kalymos/PsNee/images/BIOS/32p.png

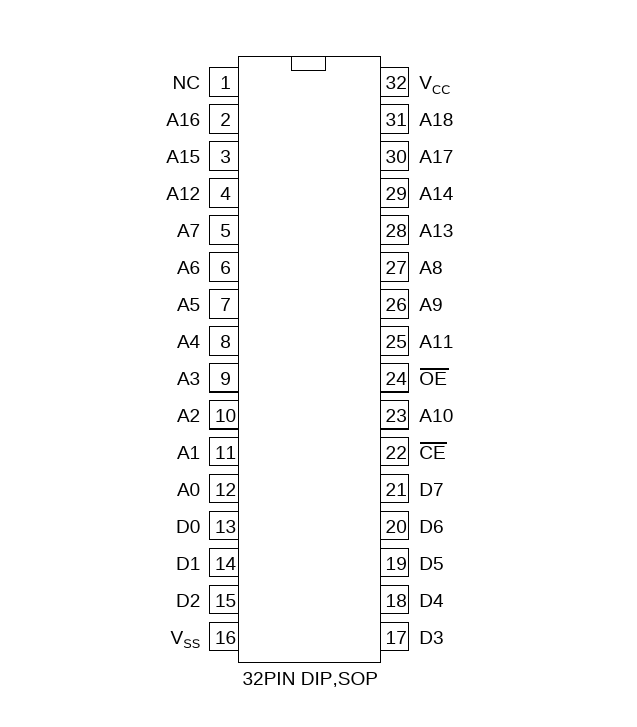
images/BIOS/32p.png
