kalymos/PsNee/images/BIOS/40p SCPH 1000-3000-pic.png

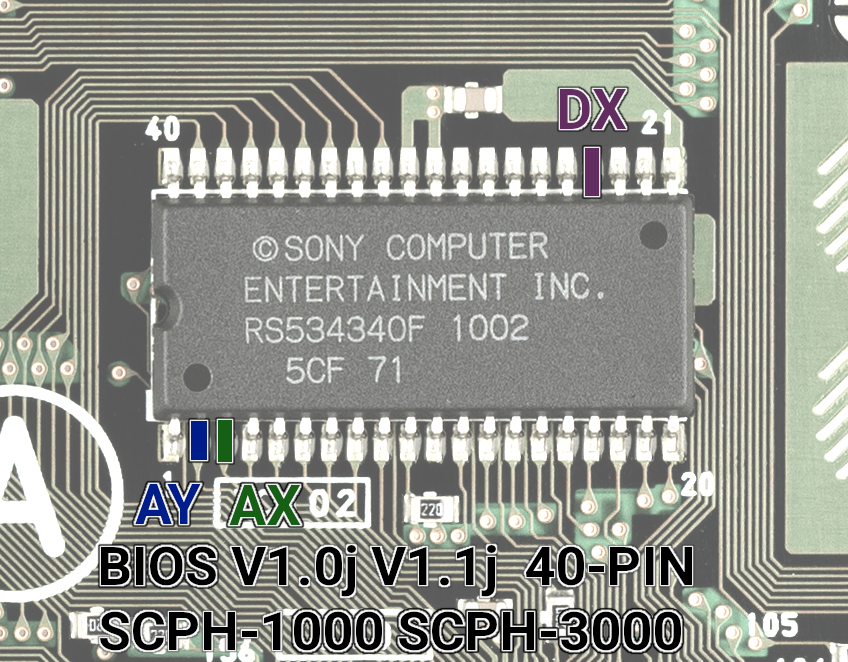
images/BIOS/40p SCPH 1000-3000-pic.png
