kalymos/PsNee/images/BIOS/40p SCPH 3500-5000-pic.png

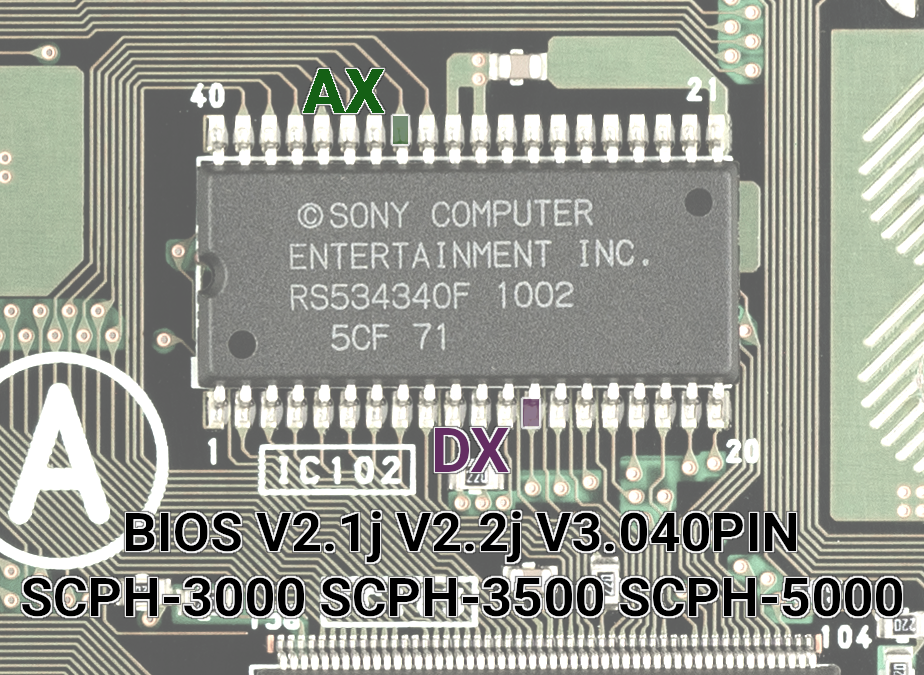
images/BIOS/40p SCPH 3500-5000-pic.png
