kalymos/PsNee/images/BIOS/40p.png

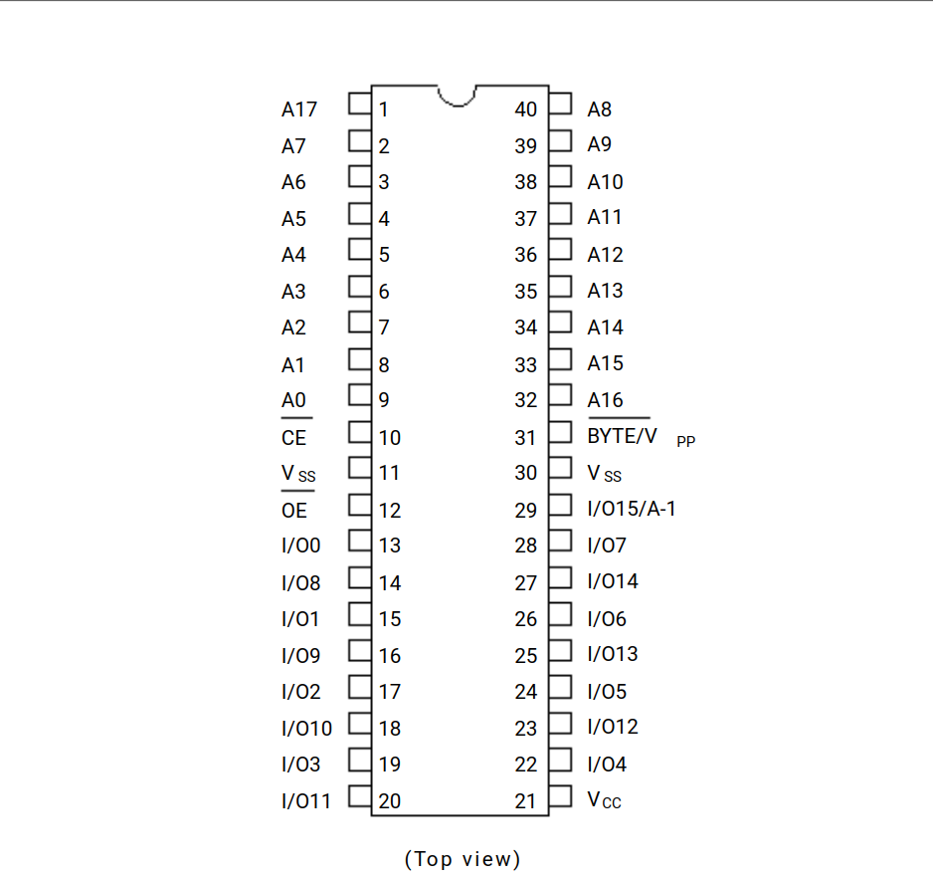
images/BIOS/40p.png
