kalymos/PsNee/images/motherboard/PU-7.png

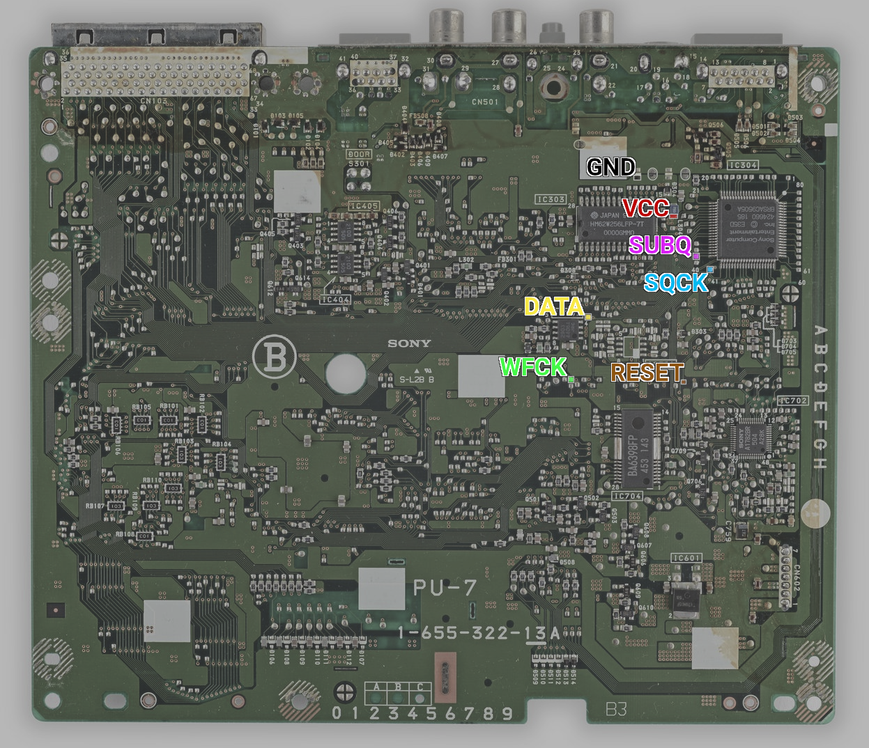
images/motherboard/PU-7.png
