kalymos/PsNee/images/motherboard/pu-8b.png

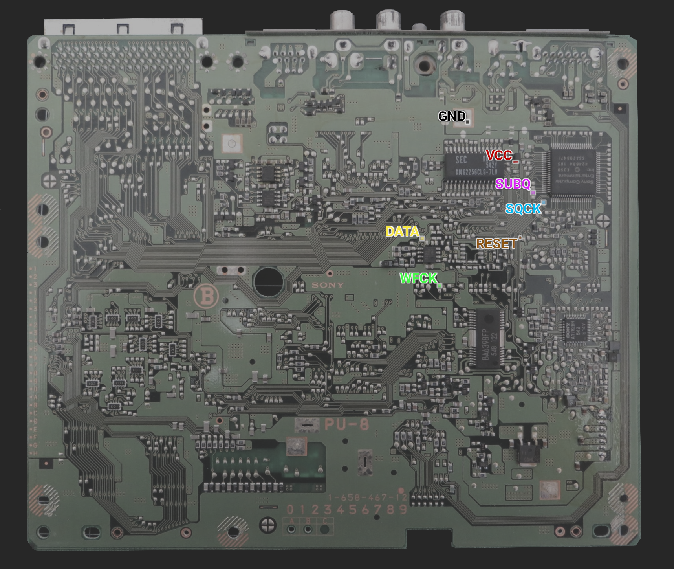
images/motherboard/pu-8b.png
