kalymos/PsNee/images/MUC Arduino/ATtiny25_45_85.png

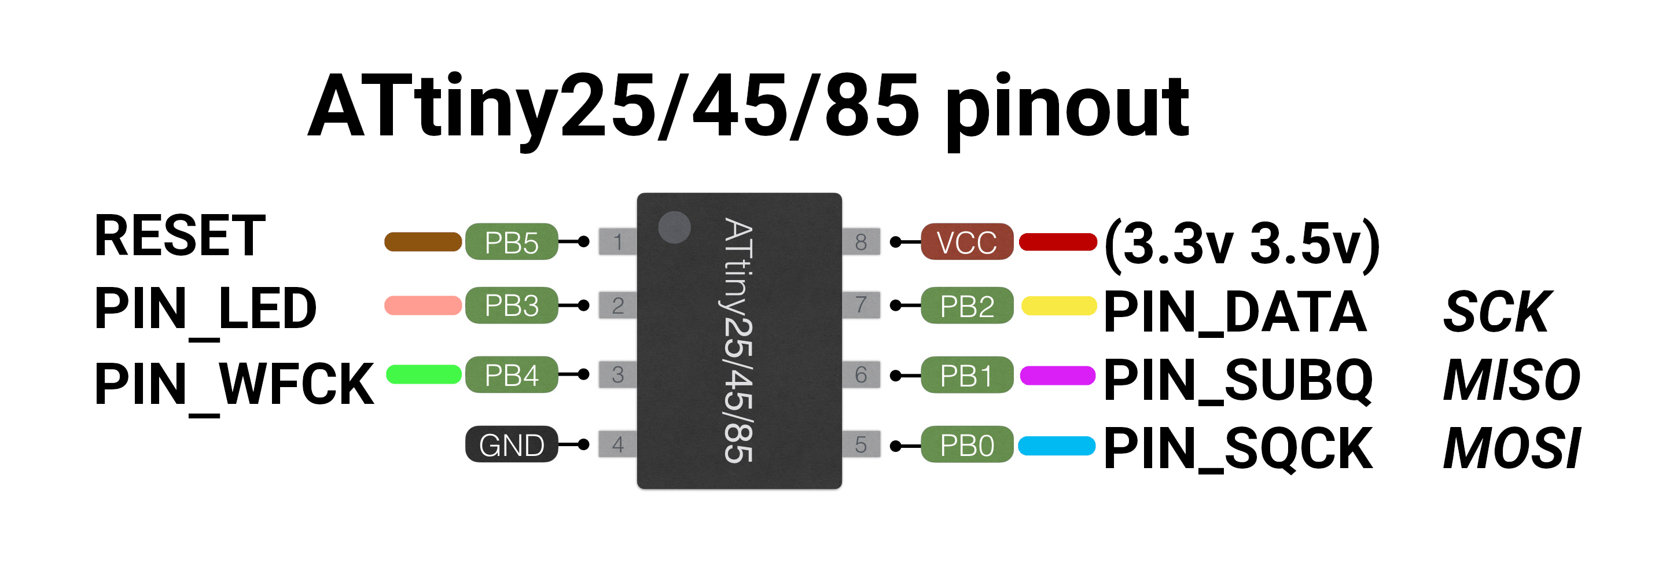
images/MUC Arduino/ATtiny25_45_85.png
