kalymos/PsNee/images/MUC Arduino/micro.png

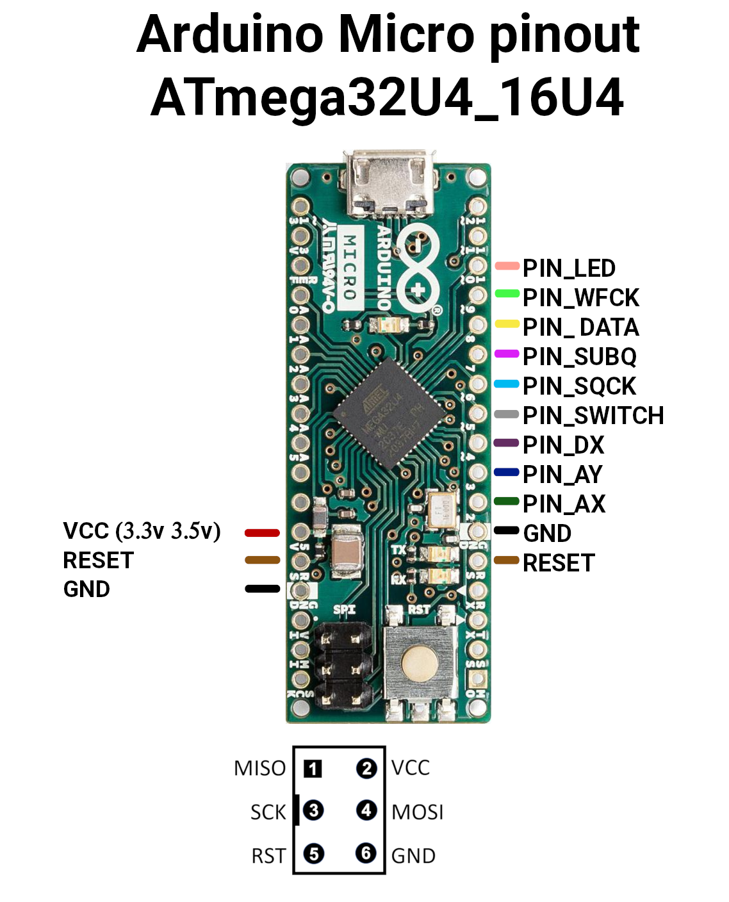
images/MUC Arduino/micro.png
