kalymos/PsNee/images/MUC Arduino/Nano.png

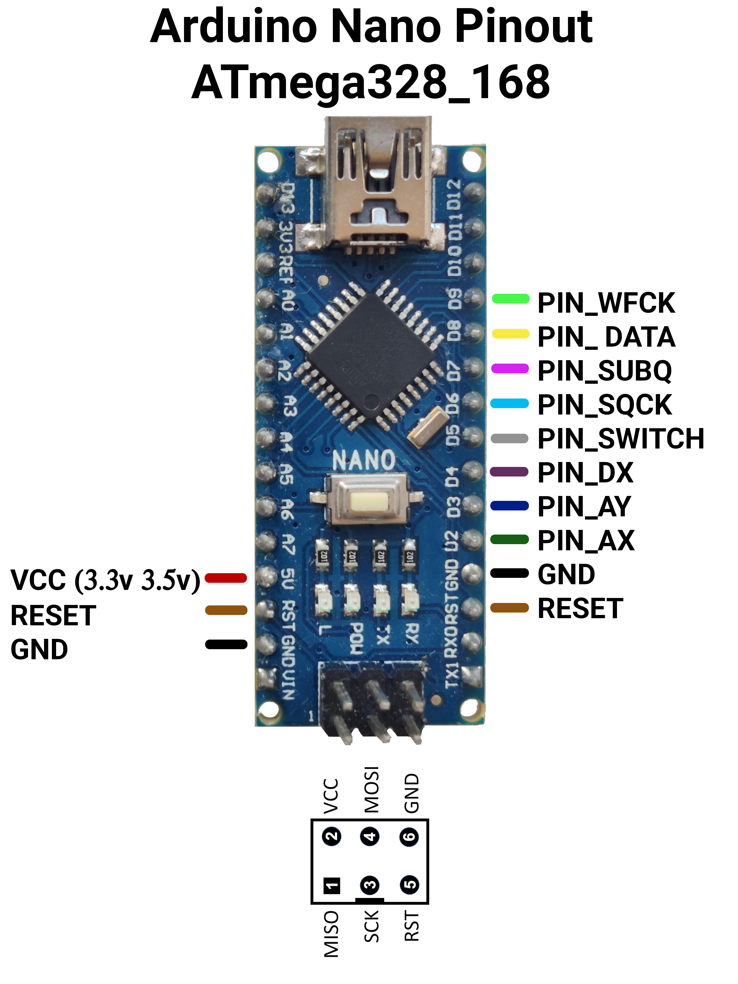
images/MUC Arduino/Nano.png
