kalymos/PsNee/images/MUC Arduino/Pro Micro.png

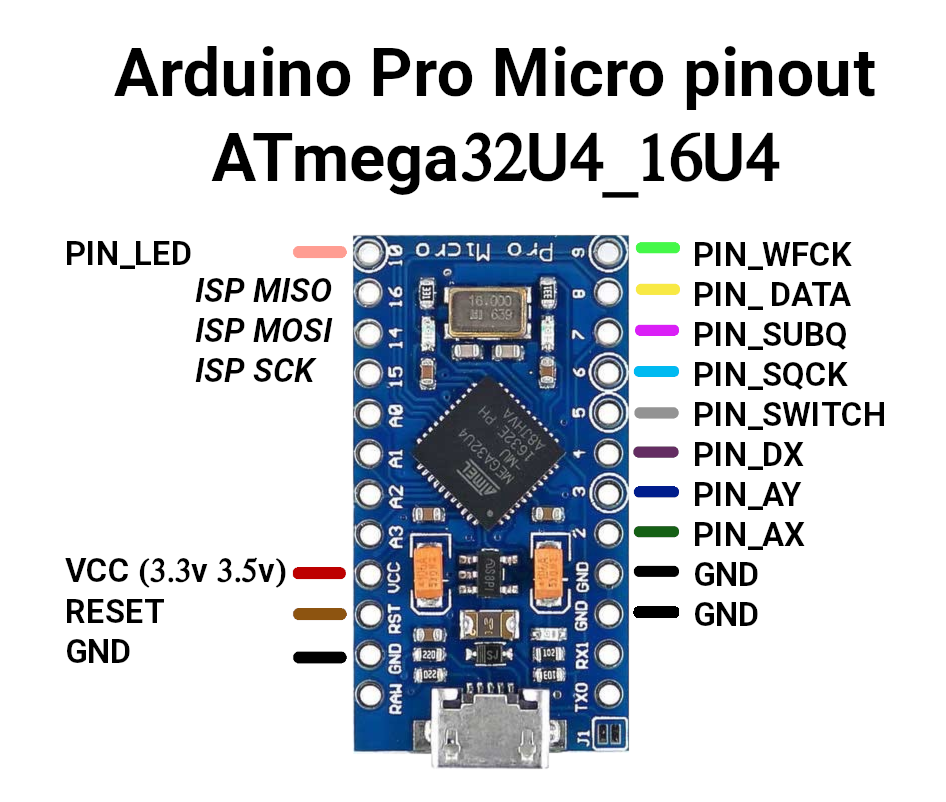
images/MUC Arduino/Pro Micro.png
