kalymos/PsNee/images/MUC Arduino/pro mini.png

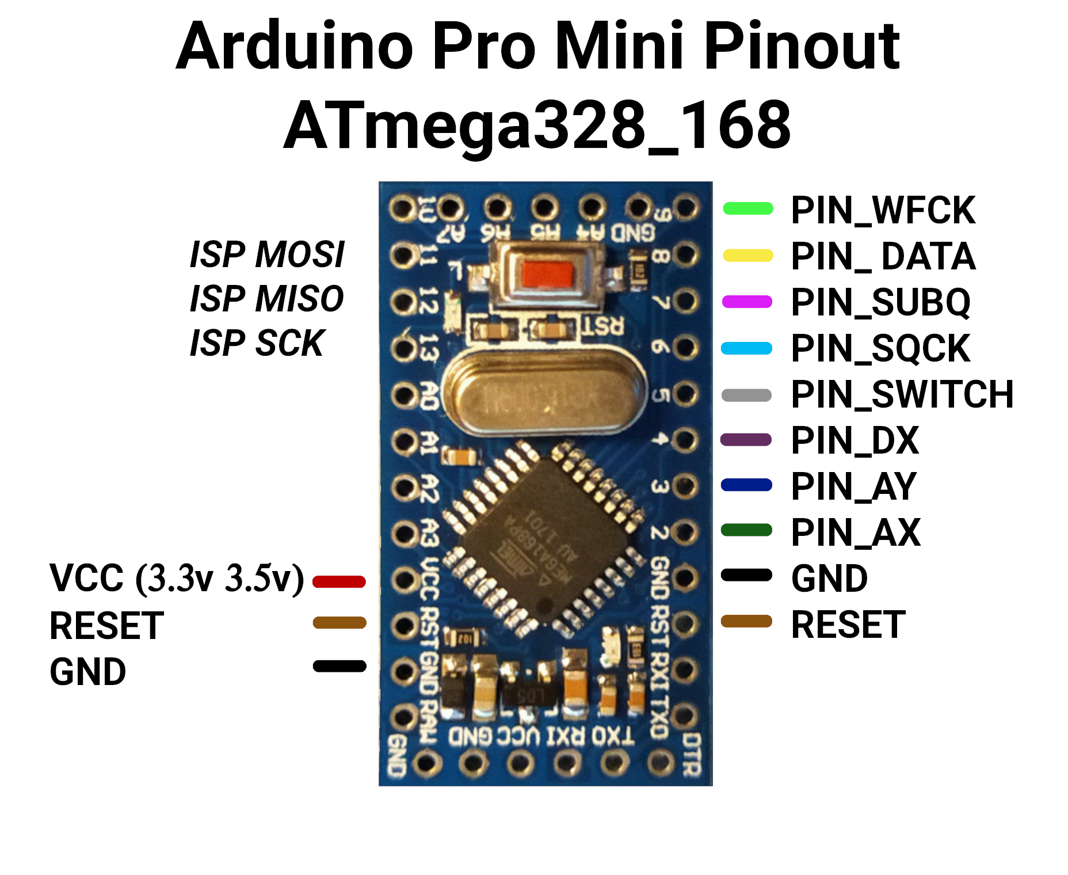
images/MUC Arduino/pro mini.png
