kalymos/PsNee/images/MUC Arduino/PSNee_V9_pinout.png

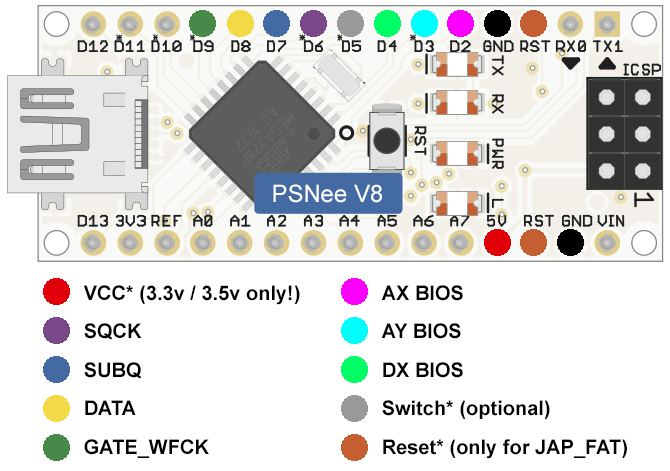
images/MUC Arduino/PSNee_V9_pinout.png
