kalymos/PsNee/images/schemat/Arduino_ISP_wires.jpg

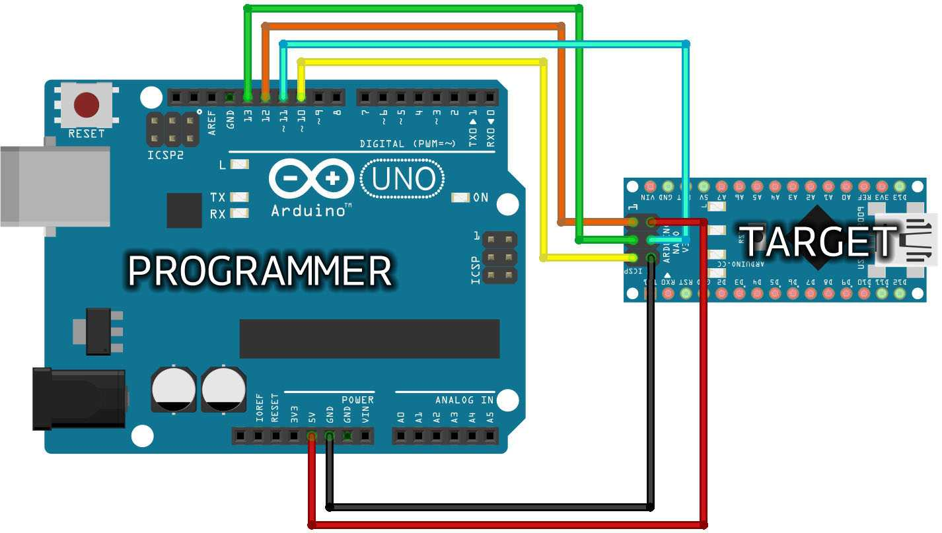
images/schemat/Arduino_ISP_wires.jpg
