kalymos/PsNee/images/schemat/ISP_gateway.png

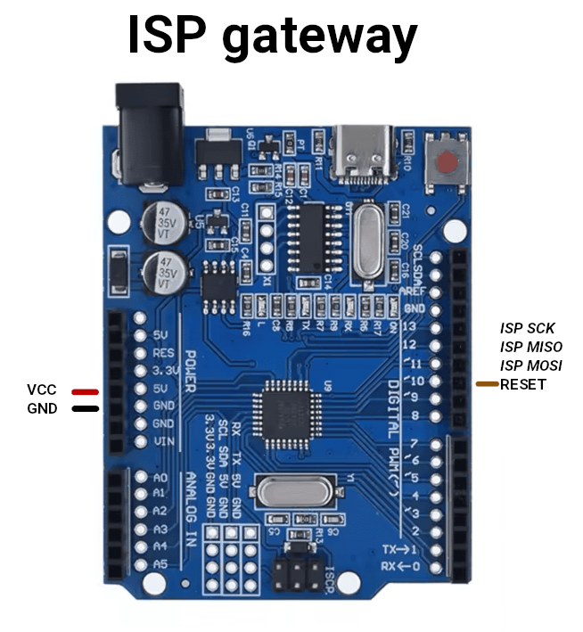
images/schemat/ISP_gateway.png
