kalymos/PsNee/images/schemat/LED_PIN.png

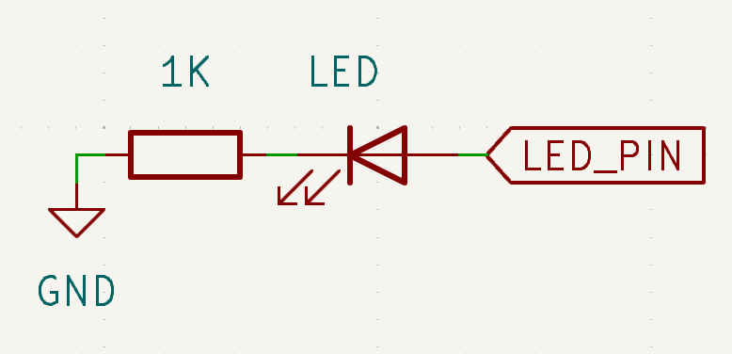
images/schemat/LED_PIN.png
