kalymos/PsNee/images/schemat/PIN_SWITCH.png

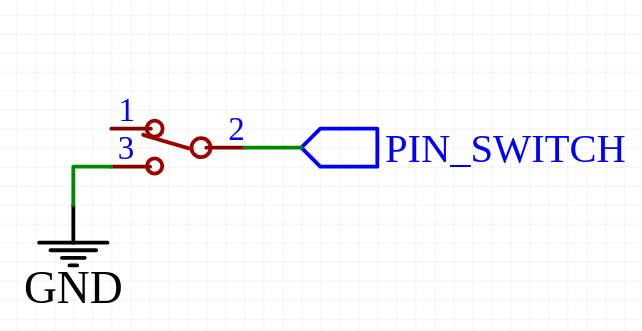
images/schemat/PIN_SWITCH.png
