kalymos/PsNee/images/tuto/blink-ISP.gif

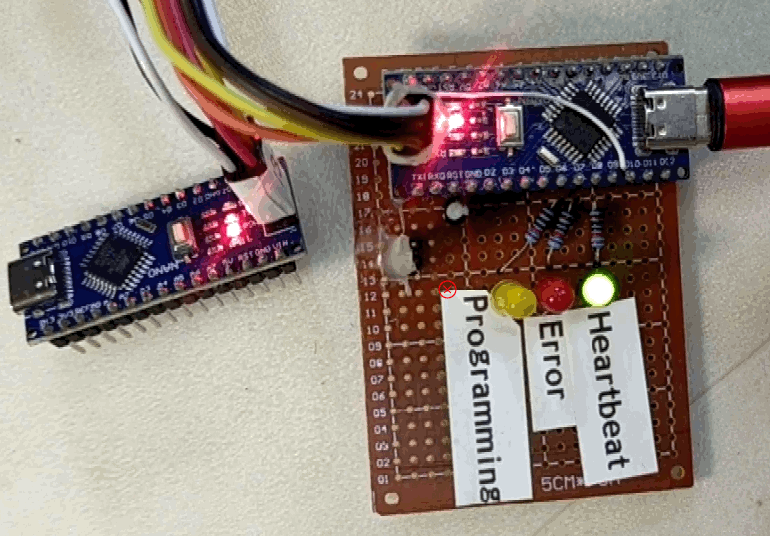
images/tuto/blink-ISP.gif
