kalymos/PsNee/images/tuto/blink-USB.gif

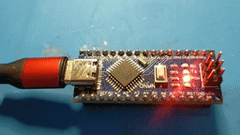
images/tuto/blink-USB.gif
