kalymos/PsNee/images/my test material/ISP-programer.jpg

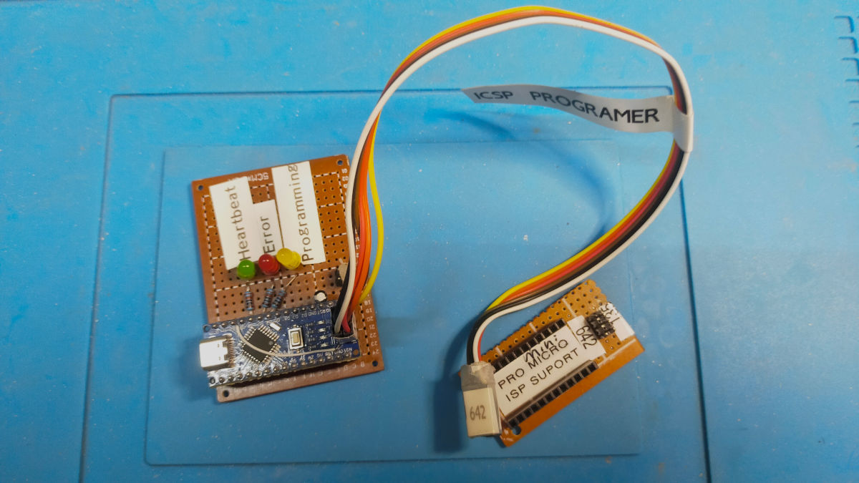
images/my test material/ISP-programer.jpg
