kalymos/PsNee/images/my test material/MCU-and-adapter.jpg

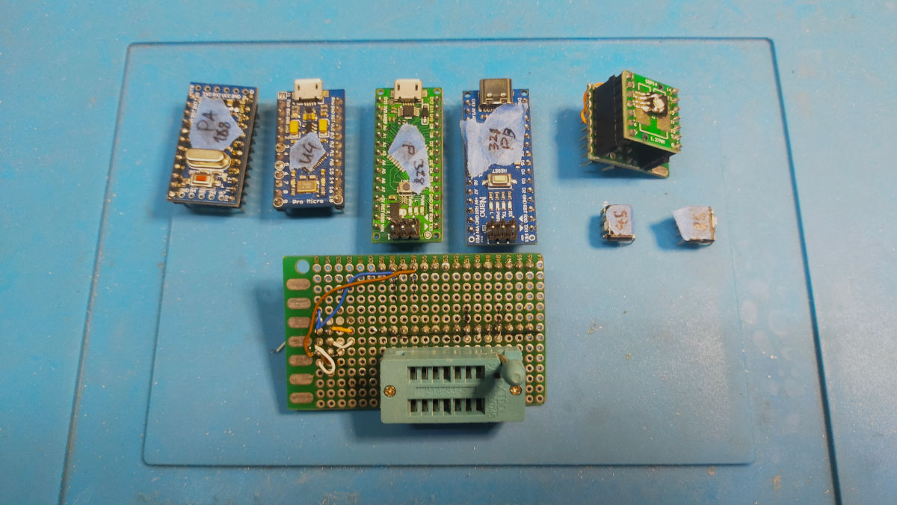
images/my test material/MCU-and-adapter.jpg
