kalymos/PsNee/(threads)

Thread 3 (2017-06-23):

BiosA18 + D2

Matyricon, 2017-06-23:
Could you please explain more about these points? Like do all PAL unit require this step? Also finding these points on the board itself has proven difficult.

kalymos, 2017-06-23:
The problem for pal occurs only on the SCPH-102.
 In the code there is the wiring mode, and it is not 100% clear, look at the wiki there is a more clot numbering.

Closed 2023-04-28.

Thread 4 (2017-06-28):

Improve instructions.

damopinn, 2017-06-28:
I used this but i commented out the NTSC fix because my ps1 doesn't need it. I think it would hang waiting for a signal it wont receive if I didn't. It doesn't mention you should edit the inject_playstation() for your region.

kalymos, 2017-06-29:
Hi if you use PsNee v6, test this version [https://github.com/kalymos/PsNee/blob/6ec387f30d0540b84bb129c454a168752bf1613f/PsNee.ino](https://github.com/kalymos/PsNee/blob/6ec387f30d0540b84bb129c454a168752bf1613f/PsNee.ino) It works with the same welding as the v6 (For me v6 does not work properly) There is also the psxdev.net that works well, seley it has not the same welding.

damopinn, 2017-06-29:
At the moment I'm not going to try I just rebuilt my ps1 with an attiny85 using v6. It's working OK.
Which region are you because v6 is Europe only but you can edit it for other regions.
and the NTSC fix needs to be removed if you don't need it I presume it will cause a hang, from reading the code it waits for an input from some bios pins which I didn't connect. What is your problem with v6?

kalymos, 2017-07-01:
I'm on the European region with SCPH-102, normally I need NTSC patch. I tested practically all the versions and it is the only one that I failed to run.
I tried several manipulation on the code, remove the patch NTSC, and something else. She always refused to inject code on the data line.

damopinn, 2017-07-01:
What device are you using because I used the Attiny85. the pin numbers are Arduino pin number like on a Digispark. using a pro mini is a lot easier. I can send you my edited code if you want.

kalymos, 2017-07-01:
I use a mini pro, and I tested an Attiny 45. I want your code, it will allow me to see where I follow myself.
I also have the new psxdev code to test.

damopinn, 2017-07-01:
I made a fork and uploaded the file. I can help to test when I'm not too busy. I suppose you leave a header to make it easier to test

kalymos, 2017-07-03:
It's good its function I had to go like a dirty :)

Thread 5 (2017-07-05):

tried to port to attiny

damopinn, 2017-07-05:
I added some code to the psxdev program.

  #define ATTINY

    #ifdef ATTINY
      // board pins
      #define sqck 3          // connect to PSX HC-05 SQCK pin
      #define subq 4          // connect to PSX HC-05 SUBQ pin
      #define data 2          // connect to point 6 in old modchip diagrams
      #define gate_wfck 0     // connect to point 5 in old modchip diagrams
      // MCU input / output
      #define SUBQPORT PINB       // Atmel MCU port for the 2 SUBQ sampling inputs
      #define SQCKBIT 3           // ATmega PD6 "SQCK" Mechacon pin 26 (PU-7 and early PU-8 Mechacons: pin 41)
      #define SUBQBIT 4           // ATmega PD7 "SUBQ" Mechacon pin 24 (PU-7 and early PU-8 Mechacons: pin 39)
      #define GATEWFCKPORT PINB   // Atmel MCU port for the gate input (used for WFCK)
      #define DATAPORT PORTB      // Atmel MCU port for the gate input (used for WFCK)
      #define GATEWFCKBIT 0       // ATmega PB1
      #define DATABIT 2          // ATmega PB0
    #endif

on the attiny there is only portb and the bit number is the same as the pin number so I changed pind to pinb and the pins and mcu input output to match but it doesnt work.

kalymos, 2017-07-07:
I would not lie. It seems to me that there is a registry call which does not conform with the Attiny. Most people even to answer exactly, are on psxdev. I do not really develop the code, I test it within the limit of my abilities ;)

damopinn, 2017-07-08:
Thanks, I found the thread on psxdev. I've been chatting there a few days now. Good job on putting this on github

Closed 2023-04-28.

Thread 9 (2017-08-28):

Arduino Pro Micro support?

gamelaster, 2017-08-28:
Hey, I have SCPH-5502, trying to use Pro Micro for modchip, but sooo, what to do, since: `has a different pin assignment and needs some easy porting`. Any more information about it?

Thanks

kalymos, 2017-08-28:
Hi if your motherboard looks like this [-->](https://upload.wikimedia.org/wikipedia/commons/thumb/b/b8/Sony_Playstation_1_SCPH-5502_motherboard_top.jpg/773px-Sony_Playstation_1_SCPH-5502_motherboard_top.jpg) It is a PU-18, you will find an adequate diagram in PsNee-V7-Diagram.

ramapcsx2, 2017-08-29:
Pro Micros can do the job but the ATmegaU chip has differnet ports and the Arduino pinout changed.
Since this code uses direct port manipulation and the pinout changed, you will have to find free pins and tell the code to use them.
For example, 'data' uses PB0, assigned to pin#8 on Arduino.
On Pro Micro, PB0 isn't available (used for an LED), so the data pin has to move and all port manipulation adjusted accordingly.
If you don't feel like doing all that, get a Nano. That should be compatible with the Arduino Uno #define ;)

ramapcsx2, 2017-08-30:
Those pins look good, yeah.
It looks like you can re-use all port defines from 'ARDUINO_BOARD'. Nice choice of pins :)
All you'll have to change is the pin numbers (sqck, subq, data, gate_wfck) and the bits (SQCKBIT, SUBQBIT, GATEWFCKBIT, DATABIT).
This should already work then.
Solder the wires, connect Vcc and ground as per the installation diagrams (now with your changed pins) and give it a test!

gamelaster, 2017-08-30:
@ramapcsx2 well, I probably already have mod chipped so I don't know if I want to do more work on it, but for contribution, I will probably try that! I will post here the results (Serial dumps if it will not work) later 😊
Thank you for now

LameNobody, 2017-10-03:
Well, tested it out with these pins,
`SQCKBIT => pin 2 (PD1)`
`SUBQBIT => pin 3 (PD0)`
`GATEWFCKBIT => pin 15 (PB1)`
`DATABIT => pin 14 (PB3)`
It booted the backup.. so I'm going to assume it worked fine.

kpek, 2020-03-22:
can anyone who got this to work with Pro Micro please share what exactly has to be changed in the code ? when i read all the info in this thread its confusing,
Do we change the pin defines only ? or only bits defines ? or both  ?

Thanks

wyatt8740, 2020-05-25:
@kpek check pull request #22 . I have this installed inside my SCPH-1001 on a pro micro.

Clone [my repository](https://github.com/wyatt8740/PsNee) and set `#define ARDUINO_32UX_BOARD`. My repository has the readme updated with the correct pinouts for it.

wyatt8740, 2020-05-28:
@ramapcsx2 can this issue be closed now since PR #22 was merged?

gamelaster, 2020-05-28:
@wyatt8740 I will close it. Thank you for testing :)

BTW. I was trying it too, sadly, after all soldering, code changes, I dummy forget that I have 5V version of ProMicro 🤦

wyatt8740, 2020-05-29:
> BTW. I was trying it too, sadly, after all soldering, code changes, I dummy forgot that I have 5V version of ProMicro
I have the 5V pro micro as well. It still worked for me, just feed it 3.5V on the Vcc pin or whatever it's called. The pin that doesn't go through a regulator. It might actually be called `5V`, but connect 3.5V to it anyway.

gamelaster, 2020-05-29:
@wyatt8740 Well, I thought the reason why it doesn't work is because 5V, well I had issue somewhere else! Good to know!

wyatt8740, 2020-06-04:
@gamelaster Glad it helped. If your board has LED's and they just turn on and stay dimmer than usual it's usually a sign they're being powered wrong through the regulator. But even though AVR's aren't really designed to run at 16MHz on ~3.3V in practice it seems to work fine with the 3.5V from a PSX at least.

Took me a while to figure that out, too, but I think rama3 or someone else on the psxdev forum thread brought it up.

Closed 2020-05-28.

Thread 10 (2017-10-04):

PSone Pins

Madad1996, 2017-10-04:
Is this compatible to the PSone, if yes which pins i should use?

ramapcsx2, 2017-10-05:
PAL or NTSC-U/J machine?
PAL requires the boot patch, which means more cables.
In any case, the install diagrams include this model. The diagram is for PAL.

Madad1996, 2017-10-06:
Cant find the Pins on the Board...
https://imgur.com/gallery/9Iwq6

Madad1996, 2017-10-06:
SCPh-102

ramapcsx2, 2017-10-07:
Ah, this is the more rare PM-41(2) board.
You'll have to use a multimeter and find something to solder to. Google image search has some old modchip installation pictures for these boards. They can help you find your pins.
The 2 BIOS pins will be the same, so will Vcc and Gnd.
Data is usually marked '6' in old diagrams. It will be one side of an smd capacitor.
WFCK is marked '5' and is a test point pad.
SUBQ is pin24, SQCK is pin26 on the HC-05 (IC304).

Closed 2023-04-28.

Thread 11 (2018-01-27):

non-working games

zoinknoise, 2018-01-27:
i apologize if this isn’t the right place to report this. have found a few non-working games.

-Henry Explorers (SLPM-86021) boots to “Insert PlayStation cd-rom”
-Tokimeki Memorial: Forever with You (SLPS-00065) boots to CD player

both are Konami games from 1995, strange coincidence.

i also found a game that trips the anti-mod protection, though I was booting a copy not an original: Ore no Ryouri (SCPS-10099) this game was burned from a Redump image.

my setup is SCPH-1001, PU-8 board, ACM drive. using latest version of code, modified a/a/a boot string on Arduino pro mini clone @16mhz.

zoinknoise, 2018-01-27:
update: uninstalled PsNee and replaced with Mayumi v1.1 (PICF508). can confirm these three games boot successfully. but now Spyro 3 doesn't work, oh well. :P

just reporting, cuz i like this project. :)

ramapcsx2, 2018-01-27:
Thanks :)
I can imagine what the failing games do. The non-booting titles are probably using a rare disc layout, maybe lots of audio in the TOC.
The one that trips the antimod, not sure. That should be almost impossible.

ramapcsx2, 2018-01-27:
Ore no Ryouri is working just fine on either a PAL (expected) or Japan PSX (should fail, if the code was bad).
The check is right after the SCE message on bootup, right? (I can hear the laser move, to search for modchip symbols. Then it continues fine, meaning it passed the test.)

zoinknoise, 2018-01-27:
hmm... i didn’t try more than once, maybe i should have. it certainly could have been  the extremely finicky ACM drive causing the error. mine is in good condition but it still despises CD-R’s.

my machine is NTSC U/C region btw.

zoinknoise, 2018-01-27:
yes the error happened immediately for me after boot. the screen actually came up in a Japanese which I can’t remember if that’s typical for a US machine.

zoinknoise, 2018-01-29:
maybe there can be an option to force game mode? so if the disc is being mistakenly booted as audio, there can be a manual override. just an idea~

zoinknoise, 2018-01-30:
reinstalled PsNee. can confirm Ore no Ryouri works fine. must have been a fluke.

trying more Konami games and found another that won't boot:

-Sexy Parodius (SLPM-86009) boots to "insert PlayStation CD-ROM"

not an original, but burned multiple times from Redump to confirm.

ramapcsx2, 2018-01-30:
The code should just work, no options necessary. If there are games that don't start, I consider it a bug that needs fixing :)
I actually have Parodius. I'll see what it does here.

ramapcsx2, 2018-02-01:
No problem on Parodius either. Check your wiring, try to attach a serial monitor and read the debug messages.

zoinknoise, 2018-02-01:
are we talking about the same Parodius? there are three for PS1 i believe. Sexy Parodius is the one that won't boot; the other two will.

if all three should work, then it must have to do with my PS1's issue with CD-R discs since i don't own original copies of those. but the two games at the top, Tokimeki and Henry Explorers, do not boot from spotless original copies. they DO boot with a Mayumi on the exact same machine/drive, so i must assume the discs are not defective.

besides these few games, i have had total success booting all backups and originals with the current version of PsNee! i will get things wired up and post some serial logs soon.

ramapcsx2, 2018-02-01:
Okay, I found Henry Explorers and this one really doesn't work.
If you look at the logs, it's easy to tell why:
61 00 A0 99 35 28 00 01 20 00 FC FF
The game has one bit too many set, compared to all other titles.
Adding the flag fixes the problem.

zoinknoise, 2018-02-01:
sweet! will the next version of the code have this fix?

i will test and log Tokimeki and Sexy Parodius later today if you don’t get to them first.

ramapcsx2, 2018-02-02:
Yeah, this is going to need a new revision. I think I also found a nicer way to go about the injection timing.
Normally, this (and old codes) use a fire and forget method to unlock the HC-05.
The new method looks at the effects of a single injection and can break/exit as soon as it thinks the HC-05 has been unlocked.
This is all to try and reduce interference to normal operation, since the modchip action is pretty bad for the error correction and thus, the laser.

zoinknoise, 2018-02-02:
excellent to hear! here are the logs i promised:

zoinknoise, 2018-02-02:
Tokimeki Memorial: Forever with You [SLPS-00065]

MCU frequency: 16000000 Hz
Waiting for SQCK..
highs: 4832 lows: 0
pu22mode: 0
21 00 A2 06 39 26 00 70 38 11 69 1F
61 00 01 06 39 31 00 00 02 00 FC FF
21 00 02 06 39 33 00 66 24 14 9F 7F
21 00 02 06 39 34 00 66 24 14 FC FF
61 00 A0 06 39 35 00 01 20 00 9F 7F
61 00 A0 06 39 36 00 01 20 00 FC FF
61 00 A0 06 39 37 00 01 20 00 9F 7F
01 00 A1 06 39 38 00 02 00 00 FC FF
01 00 A1 06 39 39 00 02 00 00 9F 7F
01 00 A1 06 39 40 00 02 00 00 FC FF
21 00 A2 06 39 41 00 70 38 11 9F 7F
21 00 A2 06 39 42 00 70 38 11 FC FF
21 00 A2 06 39 43 00 70 38 11 9F 7F
61 00 01 06 39 44 00 00 02 00 FC FF
61 00 01 06 39 45 00 00 02 00 9F 7F
61 00 01 06 39 46 00 00 02 00 FC FF
21 00 02 06 39 47 00 66 24 14 9F 7F
21 00 02 06 39 48 00 66 24 14 FC FF
21 00 02 06 39 49 00 66 24 14 9F 7F
61 00 A0 06 39 50 00 01 20 00 FC FF
61 00 A0 06 39 51 00 01 20 00 9F 7F
61 00 A0 06 39 52 00 01 20 00 FC FF
01 00 A1 06 39 53 00 02 00 00 9F 7F
01 00 A1 06 39 54 00 02 00 00 FC FF
01 00 A1 06 39 55 00 02 00 00 9F 7F
21 00 A2 06 39 56 00 70 38 11 FC FF
21 00 A2 06 39 57 00 70 38 11 9F 7F
21 00 A2 06 39 58 00 70 38 11 FC FF
61 00 01 06 39 59 00 00 02 00 9F 7F
61 00 01 06 39 60 00 00 02 00 FC FF
61 00 01 06 39 61 00 00 02 00 9F 7F
21 00 02 06 39 62 00 66 24 14 FC FF
21 00 02 06 39 63 00 66 24 14 9F 7F
21 00 02 06 39 64 00 66 24 14 FC FF
61 00 A0 06 39 65 00 01 20 00 9F 7F
61 00 A0 06 39 66 00 01 20 00 FC FF
61 00 A0 06 39 67 00 01 20 00 9F 7F
01 00 A1 06 39 68 00 02 00 00 FC FF
01 00 A1 06 39 69 00 02 00 00 9F 7F
01 00 A1 06 39 70 00 02 00 00 FC FF
21 00 A2 06 39 71 00 70 38 11 9F 7F
21 00 A2 06 39 72 00 70 38 11 FC FF
21 00 A2 06 39 73 00 70 38 11 9F 7F
61 00 01 06 39 74 00 00 02 00 FC FF
61 00 01 06 40 00 00 00 02 00 9F 7F
61 00 01 06 40 01 00 00 02 00 FC FF
21 00 02 06 40 02 00 66 24 14 9F 7F
21 00 02 06 40 03 00 66 24 14 FC FF
21 00 02 06 40 04 00 66 24 14 9F 7F
61 00 A0 06 40 05 00 01 20 00 FC FF
61 00 A0 06 40 06 00 01 20 00 9F 7F
61 00 A0 06 40 07 00 01 20 00 FC FF
01 00 A1 06 40 08 00 02 00 00 9F 7F
01 00 A1 06 40 09 00 02 00 00 FC FF
01 00 A1 06 40 10 00 02 00 00 9F 7F
21 00 A2 06 40 11 00 70 38 11 FC FF
21 00 A2 06 40 12 00 70 38 11 9F 7F
21 00 A2 06 40 13 00 70 38 11 FC FF
61 00 01 06 40 14 00 00 02 00 9F 7F
61 00 01 06 40 15 00 00 02 00 FC FF
61 00 01 06 40 16 00 00 02 00 9F 7F
21 00 02 06 40 17 00 66 24 14 FC FF
21 00 02 06 40 18 00 66 24 14 9F 7F
21 00 02 06 40 19 00 66 24 14 FC FF
61 00 A0 06 40 20 00 01 20 00 9F 7F
61 00 A0 06 40 21 00 01 20 00 FC FF
61 00 A0 06 40 22 00 01 20 00 9F 7F
01 00 A1 06 40 23 00 02 00 00 FC FF
01 00 A1 06 40 24 00 02 00 00 9F 7F
01 00 A1 06 40 25 00 02 00 00 FC FF
21 00 A2 06 40 26 00 70 38 11 9F 7F
21 00 A2 06 40 27 00 70 38 11 FC FF
21 00 A2 06 40 28 00 70 38 11 9F 7F
61 00 01 06 40 29 00 00 02 00 FC FF
61 00 01 06 40 30 00 00 02 00 9F 7F
61 00 01 06 40 31 00 00 02 00 FC FF
21 00 02 06 40 32 00 66 24 14 9F 7F
21 00 02 06 40 33 00 66 24 14 FC FF
21 00 02 06 40 34 00 66 24 14 9F 7F
61 00 A0 06 40 35 00 01 20 00 FC FF
61 00 A0 06 40 36 00 01 20 00 9F 7F
61 00 A0 06 40 37 00 01 20 00 FC FF
01 00 A1 06 40 38 00 02 00 00 9F 7F
01 00 A1 06 40 39 00 02 00 00 FC FF
01 00 A1 06 40 40 00 02 00 00 9F 7F
21 00 A2 06 40 41 00 70 38 11 FC FF
21 00 A2 06 40 42 00 70 38 11 9F 7F
21 00 A2 06 40 43 00 70 38 11 FC FF
61 00 01 06 40 44 00 00 02 00 9F 7F
61 00 01 06 40 45 00 00 02 00 FC FF
61 00 01 06 40 46 00 00 02 00 9F 7F
21 00 02 06 40 47 00 66 24 14 FC FF
21 00 02 06 40 48 00 66 24 14 9F 7F
21 00 02 06 40 49 00 66 24 14 FC FF
61 00 A0 06 40 50 00 01 20 00 9F 7F
61 00 A0 06 40 51 00 01 20 00 FC FF
61 00 A0 06 40 52 00 01 20 00 9F 7F
01 00 A1 06 40 53 00 02 00 00 FC FF
01 00 A1 06 40 54 00 02 00 00 9F 7F
01 00 A1 06 40 55 00 02 00 00 FC FF
21 00 A2 06 40 56 00 70 38 11 9F 7F
21 00 A2 06 40 57 00 70 38 11 FC FF
21 00 A2 06 40 58 00 70 38 11 9F 7F
61 00 01 06 40 59 00 00 02 00 FC FF
61 00 01 06 40 60 00 00 02 00 9F 7F
61 00 01 06 40 61 00 00 02 00 FC FF
21 00 02 06 40 62 00 66 24 14 9F 7F
21 00 02 06 40 63 00 66 24 14 FC FF
21 00 02 06 40 64 00 66 24 14 9F 7F
61 00 A0 06 40 65 00 01 20 00 FC FF
61 00 A0 06 40 66 00 01 20 00 9F 7F
61 00 A0 06 40 67 00 01 20 00 FC FF
01 00 A1 06 40 68 00 02 00 00 9F 7F
01 00 A1 06 40 69 00 02 00 00 FC FF
01 00 A1 06 40 70 00 02 00 00 9F 7F
21 00 A2 06 40 71 00 70 38 11 FC FF
21 00 A2 06 40 73 00 70 38 11 9F 7F
61 00 01 06 40 74 00 00 02 00 FC FF
61 00 01 06 41 00 00 00 02 00 9F 7F
61 00 01 06 41 01 00 00 02 00 FC FF
21 00 02 06 41 02 00 66 24 14 9F 7F
21 00 02 06 41 03 00 66 24 14 FC FF
21 00 02 06 41 04 00 66 24 14 9F 7F
61 00 A0 06 41 05 00 01 20 00 FC FF
61 00 A0 06 41 06 00 01 20 00 9F 7F
61 00 A0 06 41 07 00 01 20 00 FC FF
01 00 A1 06 41 08 00 02 00 00 9F 7F
01 00 A1 06 41 09 00 02 00 00 FC FF
01 00 A1 06 41 10 00 02 00 00 9F 7F
21 00 A2 06 41 11 00 70 38 11 FC FF
21 00 A2 06 41 12 00 70 38 11 9F 7F
21 00 A2 06 41 13 00 70 38 11 FC FF
61 00 01 06 41 14 00 00 02 00 9F 7F
61 00 01 06 41 15 00 00 02 00 FC FF
61 00 01 06 41 16 00 00 02 00 9F 7F
21 00 02 06 41 17 00 66 24 14 FC FF
21 00 02 06 41 18 00 66 24 14 9F 7F
21 00 02 06 41 19 00 66 24 14 FC FF
61 00 A0 06 41 20 00 01 20 00 9F 7F
61 00 A0 06 41 21 00 01 20 00 FC FF
61 00 A0 06 41 22 00 01 20 00 9F 7F
01 00 A1 06 41 23 00 02 00 00 FC FF
01 00 A1 06 41 24 00 02 00 00 9F 7F
01 00 A1 06 41 25 00 02 00 00 FC FF
21 00 A2 06 41 26 00 70 38 11 9F 7F
21 00 A2 06 41 27 00 70 38 11 FC FF
21 00 A2 06 41 28 00 70 38 11 9F 7F
61 00 01 06 41 29 00 00 02 00 FC FF
61 00 01 06 41 30 00 00 02 00 9F 7F
61 00 01 06 41 31 00 00 02 00 FC FF
21 00 02 06 41 32 00 66 24 14 9F 7F
21 00 02 06 41 33 00 66 24 14 FC FF
21 00 02 06 41 34 00 66 24 14 9F 7F
61 00 A0 06 41 35 00 01 20 00 FC FF
61 00 A0 06 41 36 00 01 20 00 9F 7F
61 00 A0 06 41 37 00 01 20 00 FC FF
01 00 A1 06 41 38 00 02 00 00 9F 7F
01 00 A1 06 41 39 00 02 00 00 FC FF
01 00 A1 06 41 40 00 02 00 00 9F 7F
21 00 A2 06 41 41 00 70 38 11 FC FF
21 00 A2 06 41 42 00 70 38 11 9F 7F
21 00 A2 06 41 43 00 70 38 11 FC FF
61 00 01 06 41 44 00 00 02 00 9F 7F
61 00 01 06 41 45 00 00 02 00 FC FF
61 00 01 06 41 46 00 00 02 00 9F 7F
21 00 02 06 41 47 00 66 24 14 FC FF
21 00 02 06 41 48 00 66 24 14 9F 7F
21 00 02 06 41 49 00 66 24 14 FC FF
61 00 A0 06 41 50 00 01 20 00 9F 7F
61 00 A0 06 41 51 00 01 20 00 FC FF
61 00 A0 06 41 52 00 01 20 00 9F 7F
01 00 A1 06 41 53 00 02 00 00 FC FF
01 00 A1 06 41 54 00 02 00 00 9F 7F
01 00 A1 06 41 55 00 02 00 00 FC FF
21 00 A2 06 41 56 00 70 38 11 9F 7F
21 00 A2 06 41 57 00 70 38 11 FC FF
21 00 A2 06 41 58 00 70 38 11 9F 7F
61 00 01 06 41 59 00 00 02 00 FC FF
61 00 01 06 41 60 00 00 02 00 9F 7F
61 00 01 06 41 61 00 00 02 00 FC FF
21 00 02 06 41 62 00 66 24 14 9F 7F
21 00 02 06 41 63 00 66 24 14 FC FF
21 00 02 06 41 64 00 66 24 14 9F 7F
61 00 A0 06 41 65 00 01 20 00 FC FF
61 00 A0 06 41 66 00 01 20 00 9F 7F
61 00 A0 06 41 67 00 01 20 00 FC FF
01 00 A1 06 41 68 00 02 00 00 9F 7F
01 00 A1 06 41 69 00 02 00 00 FC FF
01 00 A1 06 41 70 00 02 00 00 9F 7F
21 00 A2 06 41 71 00 70 38 11 FC FF
21 00 A2 06 41 72 00 70 38 11 9F 7F
21 00 A2 06 41 73 00 70 38 11 FC FF
61 00 01 06 41 74 00 00 02 00 9F 7F
61 00 01 06 42 00 00 00 02 00 FC FF
61 00 01 06 42 01 00 00 02 00 9F 7F
21 00 02 06 42 02 00 66 24 14 FC FF
21 00 02 06 42 03 00 66 24 14 9F 7F
21 00 02 06 42 04 00 66 24 14 FC FF
61 00 A0 06 42 05 00 01 20 00 9F 7F
61 00 A0 06 42 06 00 01 20 00 FC FF
61 00 A0 06 42 07 00 01 20 00 9F 7F
01 00 A1 06 42 08 00 02 00 00 FC FF
01 00 A1 06 42 09 00 02 00 00 9F 7F
01 00 A1 06 42 10 00 02 00 00 FC FF
21 00 A2 06 42 11 00 70 38 11 9F 7F
21 00 A2 06 42 12 00 70 38 11 FC FF
21 00 A2 06 42 13 00 70 38 11 9F 7F
61 00 01 06 42 14 00 00 02 00 FC FF
61 00 01 06 42 15 00 00 02 00 9F 7F
61 00 01 06 42 16 00 00 02 00 FC FF
21 00 02 06 42 17 00 66 24 14 9F 7F
21 00 02 06 42 18 00 66 24 14 FC FF
21 00 02 06 42 19 00 66 24 14 9F 7F
61 00 A0 06 42 20 00 01 20 00 FC FF
61 00 A0 06 42 21 00 01 20 00 9F 7F
61 00 A0 06 42 22 00 01 20 00 FC FF
01 00 A1 06 42 23 00 02 00 00 9F 7F
01 00 A1 06 42 24 00 02 00 00 FC FF
01 00 A1 06 42 25 00 02 00 00 9F 7F
21 00 A2 06 42 26 00 70 38 11 FC FF
21 00 A2 06 42 27 00 70 38 11 9F 7F
21 00 A2 06 42 28 00 70 38 11 FC FF
61 00 01 06 42 29 00 00 02 00 9F 7F
61 00 01 06 42 30 00 00 02 00 FC FF
61 00 01 06 42 31 00 00 02 00 9F 7F
21 00 02 06 42 32 00 66 24 14 FC FF
21 00 02 06 42 33 00 66 24 14 9F 7F
21 00 02 06 42 34 00 66 24 14 FC FF
61 00 A0 06 42 35 00 01 20 00 9F 7F
61 00 A0 06 42 36 00 01 20 00 FC FF
61 00 A0 06 42 37 00 01 20 00 9F 7F
01 00 A1 06 42 38 00 02 00 00 FC FF
01 00 A1 06 42 39 00 02 00 00 9F 7F
01 00 A1 06 42 40 00 02 00 00 FC FF
21 00 A2 06 42 41 00 70 38 11 9F 7F
21 00 A2 06 42 42 00 70 38 11 FC FF
21 00 A2 06 42 43 00 70 38 11 9F 7F
61 00 01 06 42 44 00 00 02 00 FC FF
61 00 01 06 42 45 00 00 02 00 9F 7F
61 00 01 06 42 46 00 00 02 00 FC FF
21 00 02 06 42 47 00 66 24 14 9F 7F
21 00 02 06 42 48 00 66 24 14 FC FF
21 00 02 06 42 49 00 66 24 14 9F 7F
61 00 A0 06 42 50 00 01 20 00 FC FF
61 00 A0 06 42 51 00 01 20 00 9F 7F
61 00 A0 06 42 52 00 01 20 00 FC FF
01 00 A1 06 42 53 00 02 00 00 9F 7F
01 00 A1 06 42 54 00 02 00 00 FC FF
01 00 A1 06 42 55 00 02 00 00 9F 7F
21 00 A2 06 42 56 00 70 38 11 FC FF
21 00 A2 06 42 57 00 70 38 11 9F 7F
21 00 A2 06 42 58 00 70 38 11 FC FF
61 00 01 06 42 59 00 00 02 00 9F 7F
61 00 01 06 42 60 00 00 02 00 FC FF
61 00 01 06 42 61 00 00 02 00 9F 7F
21 00 02 06 42 62 00 66 24 14 FC FF
21 00 02 06 42 63 00 66 24 14 9F 7F
21 00 02 06 42 64 00 66 24 14 FC FF
61 00 A0 06 42 65 00 01 20 00 9F 7F
61 00 A0 06 42 66 00 01 20 00 FC FF
61 00 A0 06 42 67 00 01 20 00 9F 7F
01 00 A1 06 42 68 00 02 00 00 FC FF
01 00 A1 06 42 69 00 02 00 00 9F 7F
01 00 A1 06 42 70 00 02 00 00 FC FF
21 00 A2 06 42 71 00 70 38 11 9F 7F
21 00 A2 06 42 72 00 70 38 11 FC FF
21 00 A2 06 42 73 00 70 38 11 9F 7F
61 00 01 06 42 74 00 00 02 00 FC FF
61 00 01 06 43 00 00 00 02 00 9F 7F
61 00 01 06 43 01 00 00 02 00 FC FF
21 00 02 06 43 02 00 66 24 14 9F 7F
21 00 02 06 43 03 00 66 24 14 FC FF
21 00 02 06 43 04 00 66 24 14 9F 7F
61 00 A0 06 43 05 00 01 20 00 FC FF
61 00 A0 06 43 06 00 01 20 00 9F 7F
61 00 A0 06 43 07 00 01 20 00 FC FF
01 00 A1 06 43 08 00 02 00 00 9F 7F
01 00 A1 06 43 09 00 02 00 00 FC FF
01 00 A1 06 43 10 00 02 00 00 9F 7F
21 00 A2 06 43 11 00 70 38 11 FC FF
21 00 A2 06 43 12 00 70 38 11 9F 7F
21 00 A2 06 43 13 00 70 38 11 FC FF
61 00 01 06 43 14 00 00 02 00 9F 7F
61 00 01 06 43 15 00 00 02 00 FC FF
61 00 01 06 43 16 00 00 02 00 9F 7F
21 00 02 06 43 17 00 66 24 14 FC FF
21 00 02 06 43 18 00 66 24 14 9F 7F
21 00 02 06 43 19 00 66 24 14 FC FF
61 00 A0 06 43 20 00 01 20 00 9F 7F
61 00 A0 06 43 21 00 01 20 00 FC FF
61 00 A0 06 43 22 00 01 20 00 9F 7F
01 00 A1 06 43 23 00 02 00 00 FC FF
01 00 A1 06 43 24 00 02 00 00 9F 7F
01 00 A1 06 43 25 00 02 00 00 FC FF
21 00 A2 06 43 26 00 70 38 11 9F 7F
21 00 A2 06 43 27 00 70 38 11 FC FF
21 00 A2 06 43 28 00 70 38 11 9F 7F
61 00 01 06 43 29 00 00 02 00 FC FF
61 00 01 06 43 30 00 00 02 00 9F 7F
61 00 01 06 43 31 00 00 02 00 FC FF
21 00 02 06 43 32 00 66 24 14 9F 7F
21 00 02 06 43 33 00 66 24 14 FC FF
21 00 02 06 43 34 00 66 24 14 9F 7F
61 00 A0 06 43 35 00 01 20 00 FC FF
61 00 A0 06 43 36 00 01 20 00 9F 7F
61 00 A0 06 43 37 00 01 20 00 FC FF
01 00 A1 06 43 38 00 02 00 00 9F 7F
01 00 A1 06 43 39 00 02 00 00 FC FF
01 00 A1 06 43 40 00 02 00 00 9F 7F
21 00 A2 06 43 41 00 70 38 11 FC FF
21 00 A2 06 43 42 00 70 38 11 9F 7F
21 00 A2 06 43 43 00 70 38 11 FC FF
61 00 01 06 43 44 00 00 02 00 9F 7F
61 00 01 06 43 45 00 00 02 00 FC FF
61 00 01 06 43 46 00 00 02 00 9F 7F
21 00 02 06 43 47 00 66 24 14 FC FF
21 00 02 06 43 48 00 66 24 14 9F 7F
21 00 02 06 43 49 00 66 24 14 FC FF
61 00 A0 06 43 50 00 01 20 00 9F 7F
61 00 A0 06 43 51 00 01 20 00 FC FF
61 00 A0 06 43 52 00 01 20 00 9F 7F
01 00 A1 06 43 53 00 02 00 00 FC FF
01 00 A1 06 43 54 00 02 00 00 9F 7F
01 00 A1 06 43 55 00 02 00 00 FC FF
21 00 A2 06 43 56 00 70 38 11 9F 7F
21 00 A2 06 43 57 00 70 38 11 FC FF
21 00 A2 06 43 58 00 70 38 11 9F 7F
61 00 01 06 43 59 00 00 02 00 FC FF
61 00 01 06 43 60 00 00 02 00 9F 7F
61 00 01 06 43 61 00 00 02 00 FC FF
21 00 02 06 43 62 00 66 24 14 9F 7F
21 00 02 06 43 63 00 66 24 14 FC FF
21 00 02 06 43 64 00 66 24 14 9F 7F
61 00 A0 06 43 65 00 01 20 00 FC FF
61 00 A0 06 43 66 00 01 20 00 9F 7F
61 00 A0 06 43 67 00 01 20 00 FC FF
01 00 A1 06 43 68 00 02 00 00 9F 7F
01 00 A1 06 43 69 00 02 00 00 FC FF
01 00 A1 06 43 70 00 02 00 00 9F 7F
21 00 A2 06 43 71 00 70 38 11 FC FF
21 00 A2 06 43 72 00 70 38 11 9F 7F
21 00 A2 06 43 73 00 70 38 11 FC FF
61 00 01 06 43 74 00 00 02 00 9F 7F
61 00 01 06 44 00 00 00 02 00 FC FF
61 00 01 06 44 01 00 00 02 00 9F 7F
21 00 02 06 44 02 00 66 24 14 FC FF
21 00 02 06 44 03 00 66 24 14 9F 7F
21 00 02 06 44 04 00 66 24 14 FC FF
61 00 A0 06 44 05 00 01 20 00 9F 7F
61 00 A0 06 44 06 00 01 20 00 FC FF
61 00 A0 06 44 07 00 01 20 00 9F 7F
01 00 A1 06 44 08 00 02 00 00 FC FF
01 00 A1 06 44 09 00 02 00 00 9F 7F
01 00 A1 06 44 10 00 02 00 00 FC FF
21 00 A2 06 44 11 00 70 38 11 9F 7F
21 00 A2 06 44 12 00 70 38 11 FC FF
21 00 A2 06 44 13 00 70 38 11 9F 7F
61 00 01 06 44 14 00 00 02 00 FC FF
61 00 01 06 44 15 00 00 02 00 9F 7F
61 00 01 06 44 16 00 00 02 00 FC FF
21 00 02 06 44 17 00 66 24 14 9F 7F
21 00 02 06 44 18 00 66 24 14 FC FF
21 00 02 06 44 19 00 66 24 14 9F 7F
61 00 A0 06 44 20 00 01 20 00 FC FF
61 00 A0 06 44 21 00 01 20 00 9F 7F
61 00 A0 06 44 22 00 01 20 00 FC FF
01 00 A1 06 44 23 00 02 00 00 9F 7F
01 00 A1 06 44 24 00 02 00 00 FC FF
01 00 A1 06 44 25 00 02 00 00 9F 7F
21 00 A2 06 44 26 00 70 38 11 FC FF
21 00 A2 06 44 27 00 70 38 11 9F 7F
21 00 A2 06 44 28 00 70 38 11 FC FF
61 00 01 06 44 29 00 00 02 00 9F 7F
61 00 01 06 44 30 00 00 02 00 FC FF
61 00 01 06 44 31 00 00 02 00 9F 7F
21 00 02 06 44 32 00 66 24 14 FC FF
21 00 02 06 44 33 00 66 24 14 9F 7F
21 00 02 06 44 34 00 66 24 14 FC FF
61 00 A0 06 44 35 00 01 20 00 9F 7F
61 00 A0 06 44 36 00 01 20 00 FC FF
61 00 A0 06 44 37 00 01 20 00 9F 7F
01 00 A1 06 44 38 00 02 00 00 FC FF
01 00 A1 06 44 39 00 02 00 00 9F 7F
01 00 A1 06 44 40 00 02 00 00 FC FF
21 00 A2 06 44 41 00 70 38 11 9F 7F
21 00 A2 06 44 42 00 70 38 11 FC FF
21 00 A2 06 44 43 00 70 38 11 9F 7F
61 00 01 06 44 44 00 00 02 00 FC FF
61 00 01 06 44 45 00 00 02 00 9F 7F
61 00 01 06 44 46 00 00 02 00 FC FF
21 00 02 06 44 47 00 66 24 14 9F 7F
21 00 02 06 44 48 00 66 24 14 FC FF
21 00 02 06 44 49 00 66 24 14 9F 7F
61 00 A0 06 44 50 00 01 20 00 FC FF
61 00 A0 06 44 51 00 01 20 00 9F 7F
61 00 A0 06 44 52 00 01 20 00 FC FF
01 00 A1 06 44 53 00 02 00 00 9F 7F
01 00 A1 06 44 54 00 02 00 00 FC FF
01 00 A1 06 44 55 00 02 00 00 9F 7F
21 00 A2 06 44 56 00 70 38 11 FC FF
21 00 A2 06 44 57 00 70 38 11 9F 7F
21 00 A2 06 44 58 00 70 38 11 FC FF
61 00 01 06 44 59 00 00 02 00 9F 7F
61 00 01 06 44 60 00 00 02 00 FC FF
61 00 01 06 44 61 00 00 02 00 9F 7F
21 00 02 06 44 62 00 66 24 14 FC FF
21 00 02 06 44 63 00 66 24 14 9F 7F
21 00 02 06 44 64 00 66 24 14 FC FF
61 00 A0 06 44 65 00 01 20 00 9F 7F
61 00 A0 06 44 66 00 01 20 00 FC FF
61 00 A0 06 44 67 00 01 20 00 9F 7F
01 00 A1 06 44 68 00 02 00 00 FC FF
01 00 A1 06 44 69 00 02 00 00 9F 7F
01 00 A1 06 44 70 00 02 00 00 FC FF
21 00 A2 06 44 71 00 70 38 11 9F 7F
21 00 A2 06 44 72 00 70 38 11 FC FF
21 00 A2 06 44 73 00 70 38 11 9F 7F
61 00 01 06 44 74 00 00 02 00 FC FF
61 00 01 06 45 00 00 00 02 00 9F 7F
61 00 01 06 45 01 00 00 02 00 FC FF
21 00 02 06 45 02 00 66 24 14 9F 7F
21 00 02 06 45 03 00 66 24 14 FC FF
21 00 02 06 45 04 00 66 24 14 9F 7F
61 00 A0 06 45 05 00 01 20 00 FC FF
61 00 A0 06 45 06 00 01 20 00 9F 7F
61 00 A0 06 45 07 00 01 20 00 FC FF
01 00 A1 06 45 08 00 02 00 00 9F 7F
01 00 A1 06 45 09 00 02 00 00 FC FF
01 00 A1 06 45 10 00 02 00 00 9F 7F
21 00 A2 06 45 11 00 70 38 11 FC FF
21 00 A2 06 45 12 00 70 38 11 9F 7F
21 00 A2 06 45 13 00 70 38 11 FC FF
61 00 01 06 45 14 00 00 02 00 9F 7F
61 00 01 06 45 15 00 00 02 00 FC FF
61 00 01 06 45 16 00 00 02 00 9F 7F
21 00 02 06 45 17 00 66 24 14 FC FF
21 00 02 06 45 18 00 66 24 14 9F 7F
21 00 02 06 45 19 00 66 24 14 FC FF
61 00 A0 06 45 20 00 01 20 00 9F 7F
61 00 A0 06 45 21 00 01 20 00 FC FF
61 00 A0 06 45 22 00 01 20 00 9F 7F
01 00 A1 06 45 23 00 02 00 00 FC FF
01 00 A1 06 45 24 00 02 00 00 9F 7F
01 00 A1 06 45 25 00 02 00 00 FC FF
21 00 A2 06 45 26 00 70 38 11 9F 7F
21 00 A2 06 45 27 00 70 38 11 FC FF
21 00 A2 06 45 28 00 70 38 11 9F 7F
61 00 01 06 45 29 00 00 02 00 FC FF
61 00 01 06 45 30 00 00 02 00 9F 7F
61 00 01 06 45 31 00 00 02 00 FC FF
21 00 02 06 45 32 00 66 24 14 9F 7F
21 00 02 06 45 33 00 66 24 14 FC FF
21 00 02 06 45 34 00 66 24 14 9F 7F
61 00 A0 06 45 35 00 01 20 00 FC FF
61 00 A0 06 45 36 00 01 20 00 9F 7F
61 00 A0 06 45 37 00 01 20 00 FC FF
61 00 01 06 51 59 00 00 02 00 9F 7F
61 01 00 00 00 34 00 00 01 40 FC FF
61 01 00 00 00 23 00 00 01 51 9F 7F
61 01 00 00 00 22 00 00 01 52 FC FF
61 01 00 00 00 21 00 00 01 53 9F 7F
61 01 00 00 00 20 00 00 01 54 FC FF
61 01 00 00 00 19 00 00 01 55 9F 7F
61 01 00 00 00 18 00 00 01 56 FC FF
61 01 00 00 00 17 00 00 01 57 9F 7F
61 01 00 00 00 16 00 00 01 58 FC FF
61 01 00 00 00 15 00 00 01 59 9F 7F
61 01 00 00 00 14 00 00 01 60 FC FF
61 01 00 00 00 13 00 00 01 61 9F 7F
61 01 00 00 00 12 00 00 01 62 FC FF
61 01 00 00 00 11 00 00 01 63 9F 7F
61 01 00 00 00 10 00 00 01 64 FC FF
61 01 00 00 00 09 00 00 01 65 9F 7F
61 01 00 00 00 08 00 00 01 66 FC FF
61 01 00 00 00 07 00 00 01 67 9F 7F
61 01 00 00 00 06 00 00 01 68 FC FF
61 01 00 00 00 05 00 00 01 69 9F 7F
61 01 00 00 00 04 00 00 01 70 FC FF
61 01 00 00 00 03 00 00 01 71 9F 7F
61 01 00 00 00 02 00 00 01 72 FC FF
61 01 00 00 00 01 00 00 01 73 9F 7F
61 01 00 00 00 09 00 00 01 65 FC FF
61 01 00 00 00 08 00 00 01 66 9F 7F
61 01 00 00 00 07 00 00 01 67 FC FF
61 01 00 00 00 06 00 00 01 68 9F 7F
61 01 00 00 00 05 00 00 01 69 FC FF
61 01 00 00 00 04 00 00 01 70 9F 7F
61 01 00 00 00 03 00 00 01 71 FC FF
61 01 00 00 00 02 00 00 01 72 9F 7F
61 01 00 00 00 01 00 00 01 73 FC FF
61 01 00 00 00 09 00 00 01 65 9F 7F
61 01 00 00 00 08 00 00 01 66 FC FF
61 01 00 00 00 07 00 00 01 67 9F 7F
61 01 00 00 00 06 00 00 01 68 FC FF
61 01 00 00 00 05 00 00 01 69 9F 7F
61 01 00 00 00 04 00 00 01 70 FC FF
61 01 00 00 00 03 00 00 01 71 9F 7F
61 01 00 00 00 02 00 00 01 72 FC FF
61 01 00 00 00 01 00 00 01 73 9F 7F
61 01 00 00 00 09 00 00 01 65 FC FF
61 01 00 00 00 08 00 00 01 66 9F 7F
61 01 00 00 00 07 00 00 01 67 FC FF
61 01 00 00 00 06 00 00 01 68 9F 7F
61 01 00 00 00 05 00 00 01 69 FC FF
61 01 00 00 00 04 00 00 01 70 9F 7F
61 01 00 00 00 03 00 00 01 71 FC FF
61 01 00 00 00 02 00 00 01 72 9F 7F
61 01 00 00 00 01 00 00 01 73 FC FF
61 01 00 00 00 09 00 00 01 65 9F 7F
61 01 00 00 00 08 00 00 01 66 FC FF
61 01 00 00 00 07 00 00 01 67 9F 7F
61 01 00 00 00 06 00 00 01 68 FC FF
61 01 00 00 00 05 00 00 01 69 9F 7F
61 01 00 00 00 04 00 00 01 70 FC FF
61 01 00 00 00 03 00 00 01 71 9F 7F
61 01 00 00 00 02 00 00 01 72 FC FF
61 01 00 00 00 01 00 00 01 73 9F 7F
61 01 00 00 00 09 00 00 01 65 FC FF
61 01 00 00 00 08 00 00 01 66 9F 7F
61 01 00 00 00 07 00 00 01 67 FC FF
61 01 00 00 00 06 00 00 01 68 9F 7F
61 01 00 00 00 05 00 00 01 69 FC FF
61 01 00 00 00 04 00 00 01 70 9F 7F
61 01 00 00 00 03 00 00 01 71 FC FF
61 01 00 00 00 02 00 00 01 72 9F 7F
61 01 00 00 00 01 00 00 01 73 FC FF
61 01 00 00 00 09 00 00 01 65 9F 7F
61 01 00 00 00 08 00 00 01 66 FC FF
61 01 00 00 00 07 00 00 01 67 9F 7F
61 01 00 00 00 06 00 00 01 68 FC FF
61 01 00 00 00 05 00 00 01 69 9F 7F
61 01 00 00 00 04 00 00 01 70 FC FF
61 01 00 00 00 03 00 00 01 71 9F 7F
61 01 00 00 00 02 00 00 01 72 FC FF
61 01 00 00 00 01 00 00 01 73 9F 7F
61 01 00 00 00 09 00 00 01 65 FC FF
61 01 00 00 00 08 00 00 01 66 9F 7F
61 01 00 00 00 07 00 00 01 67 FC FF
61 01 00 00 00 06 00 00 01 68 9F 7F
61 01 00 00 00 05 00 00 01 69 FC FF
61 01 00 00 00 04 00 00 01 70 9F 7F
61 01 00 00 00 03 00 00 01 71 FC FF
61 01 00 00 00 02 00 00 01 72 9F 7F
61 01 00 00 00 01 00 00 01 73 FC FF
61 01 00 00 00 09 00 00 01 65 9F 7F
61 01 00 00 00 08 00 00 01 66 FC FF
61 01 00 00 00 07 00 00 01 67 9F 7F
61 01 00 00 00 06 00 00 01 68 FC FF
61 01 00 00 00 05 00 00 01 69 9F 7F
61 01 00 00 00 04 00 00 01 70 FC FF
61 01 00 00 00 03 00 00 01 71 9F 7F
61 01 00 00 00 02 00 00 01 72 FC FF
61 01 00 00 00 01 00 00 01 73 9F 7F
61 01 00 00 00 09 00 00 01 65 FC FF
61 01 00 00 00 08 00 00 01 66 9F 7F
61 01 00 00 00 07 00 00 01 67 FC FF
61 01 00 00 00 06 00 00 01 68 9F 7F
61 01 00 00 00 05 00 00 01 69 FC FF
61 01 00 00 00 04 00 00 01 70 9F 7F
61 01 00 00 00 03 00 00 01 71 FC FF
61 01 00 00 00 02 00 00 01 72 9F 7F
61 01 00 00 00 01 00 00 01 73 FC FF
61 01 00 00 00 09 00 00 01 65 9F 7F
61 01 00 00 00 08 00 00 01 66 FC FF
61 01 00 00 00 07 00 00 01 67 9F 7F
61 01 00 00 00 06 00 00 01 68 FC FF
61 01 00 00 00 05 00 00 01 69 9F 7F
61 01 00 00 00 04 00 00 01 70 FC FF
61 01 00 00 00 03 00 00 01 71 9F 7F
61 01 00 00 00 02 00 00 01 72 FC FF
61 01 00 00 00 01 00 00 01 73 9F 7F
61 01 00 00 00 09 00 00 01 65 FC FF
61 01 00 00 00 08 00 00 01 66 9F 7F
61 01 00 00 00 07 00 00 01 67 FC FF
61 01 00 00 00 06 00 00 01 68 9F 7F
61 01 00 00 00 05 00 00 01 69 FC FF
61 01 00 00 00 04 00 00 01 70 9F 7F
61 01 00 00 00 03 00 00 01 71 FC FF
61 01 00 00 00 02 00 00 01 72 9F 7F
61 01 00 00 00 01 00 00 01 73 FC FF
61 01 00 00 00 09 00 00 01 65 9F 7F
61 01 00 00 00 08 00 00 01 66 FC FF
61 01 00 00 00 07 00 00 01 67 9F 7F
61 01 00 00 00 06 00 00 01 68 FC FF
61 01 00 00 00 05 00 00 01 69 9F 7F
61 01 00 00 00 04 00 00 01 70 FC FF
61 01 00 00 00 03 00 00 01 71 9F 7F
61 01 00 00 00 02 00 00 01 72 FC FF
61 01 00 00 00 01 00 00 01 73 9F 7F
61 01 00 00 00 09 00 00 01 65 FC FF
61 01 00 00 00 08 00 00 01 66 9F 7F
61 01 00 00 00 07 00 00 01 67 FC FF
61 01 00 00 00 06 00 00 01 68 9F 7F
61 01 00 00 00 05 00 00 01 69 FC FF
61 01 00 00 00 04 00 00 01 70 9F 7F
61 01 00 00 00 03 00 00 01 71 FC FF
61 01 00 00 00 02 00 00 01 72 9F 7F
61 01 00 00 00 01 00 00 01 73 FC FF
61 01 00 00 00 09 00 00 01 65 9F 7F
61 01 00 00 00 08 00 00 01 66 FC FF
61 01 00 00 00 07 00 00 01 67 9F 7F
61 01 00 00 00 06 00 00 01 68 FC FF
61 01 00 00 00 05 00 00 01 69 9F 7F
61 01 00 00 00 04 00 00 01 70 FC FF
61 01 00 00 00 03 00 00 01 71 9F 7F
61 01 00 00 00 02 00 00 01 72 FC FF
61 01 00 00 00 01 00 00 01 73 9F 7F
61 01 00 00 00 09 00 00 01 65 FC FF
61 01 00 00 00 08 00 00 01 66 9F 7F
61 01 00 00 00 07 00 00 01 67 FC FF
61 01 00 00 00 06 00 00 01 68 9F 7F
61 01 00 00 00 05 00 00 01 69 FC FF
61 01 00 00 00 04 00 00 01 70 9F 7F
61 01 00 00 00 03 00 00 01 71 FC FF
61 01 00 00 00 02 00 00 01 72 9F 7F
61 01 00 00 00 01 00 00 01 73 FC FF
61 01 00 00 00 09 00 00 01 65 9F 7F
61 01 00 00 00 08 00 00 01 66 FC FF
61 01 00 00 00 07 00 00 01 67 9F 7F
61 01 00 00 00 06 00 00 01 68 FC FF
61 01 00 00 00 05 00 00 01 69 9F 7F
61 01 00 00 00 04 00 00 01 70 FC FF
61 01 00 00 00 03 00 00 01 71 9F 7F
61 01 00 00 00 02 00 00 01 72 FC FF
61 01 00 00 00 01 00 00 01 73 9F 7F
61 01 00 00 00 09 00 00 01 65 FC FF
61 01 00 00 00 08 00 00 01 66 9F 7F
61 01 00 00 00 07 00 00 01 67 FC FF
61 01 00 00 00 06 00 00 01 68 9F 7F
61 01 00 00 00 05 00 00 01 69 FC FF
61 01 00 00 00 04 00 00 01 70 9F 7F
61 01 00 00 00 03 00 00 01 71 FC FF
61 01 00 00 00 02 00 00 01 72 9F 7F
61 01 00 00 00 01 00 00 01 73 FC FF
61 01 00 00 00 09 00 00 01 65 9F 7F
61 01 00 00 00 08 00 00 01 66 FC FF
61 01 00 00 00 07 00 00 01 67 9F 7F
61 01 00 00 00 06 00 00 01 68 FC FF
61 01 00 00 00 05 00 00 01 69 9F 7F
61 01 00 00 00 04 00 00 01 70 FC FF
61 01 00 00 00 03 00 00 01 71 9F 7F
61 01 00 00 00 02 00 00 01 72 FC FF
61 01 00 00 00 01 00 00 01 73 9F 7F
61 01 00 00 00 09 00 00 01 65 FC FF
61 01 00 00 00 08 00 00 01 66 9F 7F
61 01 00 00 00 07 00 00 01 67 FC FF
61 01 00 00 00 06 00 00 01 68 9F 7F
61 01 00 00 00 05 00 00 01 69 FC FF
61 01 00 00 00 04 00 00 01 70 9F 7F
61 01 00 00 00 03 00 00 01 71 FC FF
61 01 00 00 00 02 00 00 01 72 9F 7F
61 01 00 00 00 01 00 00 01 73 FC FF
61 01 00 00 00 09 00 00 01 65 9F 7F
61 01 00 00 00 08 00 00 01 66 FC FF
61 01 00 00 00 07 00 00 01 67 9F 7F
61 01 00 00 00 06 00 00 01 68 FC FF
61 01 00 00 00 05 00 00 01 69 9F 7F
61 01 00 00 00 04 00 00 01 70 FC FF
61 01 00 00 00 03 00 00 01 71 9F 7F
61 01 00 00 00 02 00 00 01 72 FC FF
61 01 00 00 00 01 00 00 01 73 9F 7F
61 01 00 00 00 09 00 00 01 65 FC FF
61 01 00 00 00 08 00 00 01 66 9F 7F
61 01 00 00 00 07 00 00 01 67 FC FF
61 01 00 00 00 06 00 00 01 68 9F 7F
61 01 00 00 00 05 00 00 01 69 FC FF
61 01 00 00 00 04 00 00 01 70 9F 7F
61 01 00 00 00 03 00 00 01 71 FC FF
61 01 00 00 00 02 00 00 01 72 9F 7F
61 01 00 00 00 01 00 00
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

Thread 12 (2018-01-27):

Any reason why we shouldn't use 5v Arduino?

mylogon341, 2018-01-27:
Hi, I'm _fairly_ new to electronics. I have some 5v 16Mhz Arduino Pro Mini boards and found that these run on 3.3/3.5v no problem. Is there any reason why I shouldn't use 5v boards?
Thanks

zoinknoise, 2018-01-28:
that’s the kind of Arduino I’m using for PsNee with no problem, the 8mhz option is probably just for people with that board

ramapcsx2, 2018-01-28:
Every 5V Arduino I had / I tested ran fine at 3.3V / 16Mhz. But some of them will not rewrite correctly at that voltage.
I'd say it is fine to flash a 5V / 16Mhz Arduino at 5V, and then use in the PSX at 3.3V.
Never had any issues and the system isn't critical.

mylogon341, 2018-01-28:
That's great to know. Thank you so much. I was just really confused on why there was such an emphasis on not using the 5v versions without any reason given. Good to know that I don't have to go out and buy more Arduinos.
Thanks

ramapcsx2, 2018-01-28:
The warning is a little different:
It says you must not use an Arduino *that is powered by 5V*, the reason being that it would send 5V level signals into the 3.3V PSX.

mylogon341, 2018-01-28:
Ah. So it does. I seemed to have misread/ misunderstood the point. That makes total sense.
Thanks @ramapcsx2 !

Closed 2018-01-28.

Thread 15 (2019-01-01):

Attiny85

gtchandra, 2019-01-01:
Hi, thanks for the great page, the project is awesome, I tried today to mod my father PS1 with an ATTINY85 and did not work.
I initially set the clockspeed at 8Mhz internal clock (burning the bootloader) then I programmed the chip using my programmer and an arduino board with ISP.
I also tried to get some debug details, connecting on pin3 @115200 and it seems working, injection is called sometimes, but I had no luck in making a burnt CD working (already tried on other modded boards). It seems injection is not effective.
Any advice?
thanks

kalymos, 2019-01-01:
From memory, the stability of the ATTINY85 clock and problematic. The best solution is to use an arduino pro mini.

Or the https://github.com/kalymos/PsNee/blob/AttyNee/PsNee.ino branch, and built for ATTINY.

For more explanation the forum http://www.psxdev.net/forum/viewtopic.php?f=47&t=1262&start=480 is the best place.

happy New Year.

gtchandra, 2019-01-01:
Thank you! and happy New Year to you!!

gtchandra, 2019-01-01:
I'm trying to change code to http://www.psxdev.net/forum/viewtopic.php?f=47&t=1262&start=480
but I can't find all the necessary board endpoint. I was able to find LID, GATE and Reset using this diagram.
http://modchip.aeug.org/install/508-pu18-stealth.html
but still cant find
// - PB3 = biosA18
// - PB4 = biosD2
on the PU-18 Board...

kalymos, 2019-01-01:
I understand why you can not find, the indication is in the code.

unsigned char biosA18 = 11; //Only used in SCPH-102 PAL mode

unsigned char biosD2 = 12; //Only used in SCPH-102 PAL mode

Thank you for the question, I just added the warning in the table.

Le mar. 1 janv. 2019 à 14:41, Gabriele Tazzari <notifications@github.com> a
écrit :

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

ramapcsx2, 2019-01-08:
The chip works just fine, but your laser/drive/electronics have lots of trouble reading the disk.
Note: Once you see the black PS screen with a burned copy, you know that a modchip is working ;)

gtchandra, 2019-01-08:
that's what I thought, I have to clean and repair the optical drive.
Thanks, I'll let you know and eventually switch back to attiny85 (which worked as well up to that point) so we can put a TESTED on the SCPH5502.

kalymos, 2019-01-08:
Great thank you for keeping me informed.

Le mar. 8 janv. 2019 à 11:51, Gabriele Tazzari <notifications@github.com> a
écrit :

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

gtchandra, 2019-03-02:
Hi there, just a quick one to update on the issue here.
The PSX I was working SCPH5502 on had serious issues related to the CD DSP. I tried on a SCPH 7502 (PU-22) with an ATTINY85 and it works perfectly.
Thanks for your support.

Closed 2019-03-02.

Thread 16 (2019-05-06):

PAL PsOne GU 41 Problem with Bios patching

Speedy1102, 2019-05-06:
I soldered a Arduino Pro mini Board.

The Chip works fine for PAL Games.

When i want to Load a Backup of an NTSC Game it loads 2 out of 6 Times.

Flashed the Code twice.

Shortened Cables

The Arduino is flashed over isp. So no Bootloader i guess.

Can you give me any Tips ?

Thanks

Speedy1102, 2019-05-08:
The Arduino Board Sems to be Faulty.

Tried an other one and Works Perfect.

Closed 2019-05-08.

Thread 19 (2020-02-16):

A problem with PM-41 NTSC-J boards 1-679-335-61

celcion, 2020-02-16:
I recently got a bunch of Japanese PS Ones (PM-41) sold in one lot as unchecked and while I was testing and fixing them, I also tried to mod them with PsNee. Most of them worked fine, but two boards with "1-679-335-61" printed on top of them just didn't want to boot CD-Rs no matter what I did. It starts spinning the disc, but not speeding it up for actual checking. And after some time it either shows the standard "Please Insert Playstation Format disc" screen, or switch to CD Audio player if the game on CD-R contains audio tracks. No injecting happens during this time either. As if I inserted the wrong disc.
Still, licensed discs worked fine and PsNee debug output showed that it does injecting. I also messed around a bit with injection making licensed discs not loading too as a test, so I determined that PsNee indeed does injection and PS One takes it. I also tried to change the CD drive to the one that worked fine in the other modded PS One and it didn't help too. These "1-679-335-61" boards looks almost exactly the same as "1-679-335-51" ones that worked fine, all the soldering points for the mod are at the same locations.
I'm using ATTiny45 with the latest "master" version of the firmware and soldering instructions. I tried to play around with injection and timing, but it didn't help at all.
Here is debug log from the CD-R (Guilty Gear) loading which ultimately led to CD-Audio player: https://pastebin.com/eb0sip99
And here's the log from the regular game disc (Tekken 3) which boots like it should: https://pastebin.com/NcADhLkx

I'm pretty much stuck at this point, don't know what to do next.
Maybe I should try AttyNee? Does it work with ATTiny45?
Thanks in advance for any help.

ramapcsx2, 2020-02-16:
Is the Guilty Gear log cut short?
It looks like garbage data at first, then some valid subcodes, then it ends.
The initial garbage is fine, as long as it then starts to read valid subcodes.

celcion, 2020-02-17:
Thank you for the fast answer!
No, this is a full log of Guilty Gear loading, PS One actually stops the disc spinning after that. And if you go to the CD Player - it shows two tracks, the second being audio one, obviously. This Guilty Gear disc works just fine on the *-41 and *-51 boards revisions. And I tried to swap the CD drive from those, it didn't help. It's like if PS One also does some other checks before it starts treating the disk like a game disk at all.
And - no, this is not a PM-41 (2) board, the layout is the same as the regular PM-41.
Here's the picture of the board: https://photos.app.goo.gl/PLAXBrBjAA5mwDpi6

ramapcsx2, 2020-02-17:
Ah yeah, okay.
The CD controller redesign happened with -71, so the WFCK test point is for the regular PM-41 indeed.

So I suppose your -61 expects unlock symbols earlier than all the other boards.
You can test that by reducing the threshold here:
https://github.com/kalymos/PsNee/blob/master/PsNee.ino#L383
Remember to also lower the ceiling accordingly here:
https://github.com/kalymos/PsNee/blob/master/PsNee.ino#L386

(Example: threshold 7, ceiling 5)

celcion, 2020-02-17:
I went all the way to the 0 for the ceiling and it didn't help, even Tekken 3 started to hang on the startup.

Thing is that it's not even trying to spin the disc faster like it should. And whaty I also noticed is that it's not spinning the CD-R discs specifically, any of them (I have about 5 different CD-R disc types). Because when I tried to put just a random factory written CD disc with Windows game - it started to spin it.

And, again, it's not because of the CD drive itself, I specifically tried the drive from the PS One with -41 board which was modded with the same PsNee and ATTiny45 and worked fine - it also doesn't even try to spin up the CD-R disc. But it still detects it as an Audio CD. Like, it slowly spins it and then goes to CD Player in the BIOS. And all the audio tracks reads fine, so it's not just reading problem either.

I don't really know the details, but it looks like it it fails to detect CD-R disc correctly even before modchip have to inject anything.

ramapcsx2, 2020-02-18:
Ah, okay. So yeah, this is a hardware problem.
I've seen this on an older model PSX once or twice: The CD controller never goes into 2x mode.
But these machines would also not run official games. They were simply broken.
If your console still runs an official disk, then I assume the CD subsystem is not working up to spec.
This could be caused by bad capacitors, resistors, even the modchip (if it's soldered on wrong, or not working correctly).

celcion, 2020-02-18:
Yeah, I thought so when I had this with the first -61 board I had. But I just passed the modchip I made with PsNee to the PS One with the -51 board - and it worked right away. And then I had another -61 - and it failed in exactly the same manner. And I also passed the chip to the other board (-11 this time) - and it also worked fine. I never had any problems with the other boards. I soldered them all in pretty much the same way, like this (this one works fine): https://photos.app.goo.gl/GmzEfzRoS7c9zdkG8
I'm not a pro, so of course it could be my shoddy soldering, I won't deny that.

Both of these -61 systems runs official discs, both fails in the very same manner with the modchip. So I could assume they both have some common hardware problem, sure, but I don't have any clue where to look. I think I should also note that they have different CD driver, first one have BA5947FP and the other one have AN8732SB.
Still, you're right, this problem is probably is not related to PsNee whatsoever since it looks like it never comes to PsNee to do anything.

One last question though, if I may - what else could I try to check? Like, try some other version of PsNee and the soldering?
Thank you for your time anyway.

ramapcsx2, 2020-02-19:
Soldering and modchip seem to be fine. I think the CD-R is not being read reliably.
Reasoning: The subcode logs from PsNee look fine, except that it never proceeds to inject.
So I assume that the drive times out and resets reading, then gives up.

celcion, 2020-02-19:
Yeah, but good question is - why? I mean, I tried the CD drive from the PS One where modchip worked without any problems at all. Three of them, in fact. For me it pretty much excludes any possibilities of problems with CD drive itself.
I think that PROBABLY -61 has some BIOS alterations that does some initial disc checking or something. Because it still tries to spin up a regular factory made Windows CD disc with the game (and freeze there, just staying on double spinning speed). This is what makes it really strange, because unmodded PS One doesn't try to spin up the same disc, just showing the standard "Please Insert Playstation Format disc" screen. So it looks like PsNee does its job kicking PS One to detect the regular disc as a game disc, but not for CD-R discs... Which kinda don't make too much sense to me.
I tried all the CD-R types I had, even tried to write on 4x speed with some old IDE CD-RW drive I have - it still doesn't work...
I modded 10 PS Ones so far, one of them being older SCPH-9000 (which I used as a first "victim") - and only those two -61 boards just don't work, all the other works pretty much fine. So I guess we can safely assume that -61 boards probably need some additional research to do in order make PsNee work. I can try to help with that if you're interested and will tell me what to do.

ramapcsx2, 2020-02-19:
Well, as I said, you can pretty much exclude problems with the modchip itself.
The issue is directly with CD-R and that board revision, and the striking difference between CD-R and pressed disks is their lower pit/land reflectivity.

jayjr1105, 2020-07-08:
I realize this is some months back but did you ever figure it out?  I had a similar issue with a NTSC PM-41 board with 1-679-335-61 on it.  Someone on Discord helped me set the fuses correctly and it resolved my issue.  Working fine on my 1-679-335-61 board now.

celcion, 2020-07-08:
> I realize this is some months back but did you ever figure it out? I had a similar issue with a NTSC PM-41 board with 1-679-335-61 on it. Someone on Discord helped me set the fuses correctly and it resolved my issue. Working fine on my 1-679-335-61 board now.

Oh, really? No, I didn't resolve it. Could you please tell me what you did to make it work?

jayjr1105, 2020-07-08:
Keep in mind that I had a SCEA board and this may or may not work for you.  In my case I used an ATTINY85 chip and it wouldn't work at all.  Someone on Discord walked me through setting up the correct "fuses" on the chip and now it works...  I took some notes https://ghostbin.co/paste/4uam3

celcion, 2020-07-08:
Thank you! So, wiring is the same, only fuses should be different?

jayjr1105, 2020-07-08:
Yes, Wiring is identical to any other PM-41 board.

celcion, 2020-07-08:
So, I checked. Sadly, it didn't help. I also noticed that your wiring is slightly different - checked that too. No luck.
It looks like it's some kind of strange SCEI-specific case of -61 boards... I also tried to program it with universal programmer, playing with fuses - no luck either. I guess that I can also try some actual Arduino board instead of ATTiny45, but I doubt it'll change anything...

jayjr1105, 2020-07-09:
My wiring is only slight different because I used different points for ground and vcc.   There are more than one solder point for the other wires as well.  I used this pinout/guide https://quade.co/ps1-modchip-guide/psnee/pm-41/

Too bad it's still not working.  check your solder points with a multimeter in continuity mode.

celcion, 2020-07-09:
I mean, I used a local soldering diagram. This one: https://github.com/kalymos/PsNee/blob/master/PsNee%20modchip%20installation%20guide.pdf
And I altered it for SQCK soldering point. Makes no difference really, but why not.
Anyway, I re-soldered it so many times and on two different boards, I doubt it was a problem with bad soldering - at least once I had to get it right. Also, I successfully modded more than 10 other PS Ones with not -61 boars, including even two -71s (PM-41(2)).
I also tried different ATTiny chips (tried ATTiny13a with different firmware) and other soldering diagrams. Everything failed to work. I can only conclude that it probably have something to do with different BIOS since Japanese PM-41s has region lock that requires disc image patching.

L10N37, 2021-08-29:
I made a new chip not long ago, https://github.com/L10N37/tehUberChip_Another_PSX_Modchip

No jap console BIOS patching though, although someone released 'psnee V8' about the same time with JAP BIOS patching support.

ItzSwirlz, 2023-06-19:
Hello, I'm on a PM-41 (2), SCPH-101, NTSC model. Having same issue here and I've tried resoldering

kalymos, 2023-06-23:
I don't know exactly what your problem is, but with my PU41, I had to set
the timer on line 153

Le lun. 19 juin 2023 à 21:37, Joshua Peisach ***@***.***> a
écrit :

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

Closed 2023-04-28.

Thread 20 (2020-02-17):

PM-41 PAL issue with BIOS patching

greguz, 2020-02-17:
Hi everyone.
I just installed a PsNee (Arduino Pro Mini 3.3v 8MHz no bootloader) inside an SCPH-102 PAL.
PAL games (both backups and original) work fine, but I have an original NTCS game that I'm not able to boot. Already shortened all wires, but no luck. Always show the "dashboard".

From what I understood, the problem may be the [BIOS patch section](https://github.com/kalymos/PsNee/blob/master/PsNee.ino#L175). I suppose the Arduino running at 8MHz may be too slow to patch the BIOS in time. Could it make sense?

Thanks, and nice project!

ramapcsx2, 2020-02-18:
I suspect this is the problem, yes.
You can verify that the patch worked by the video mode the PSone uses for the BIOS.
If it's still PAL, the patch failed. If it's NTSC (the screen is larger than in PAL, and 60Hz instead of 50Hz), then the patch worked and the issue is somewhere else.

Unfortunately, we found some inconsistencies with the BIOS patch. You may want to read about it in the development thread, but you may not find a quick solution:
http://www.psxdev.net/forum/viewtopic.php?f=47&t=1262&start=460

greguz, 2020-02-21:
I just ordered another Pro Mini, a 5V 16MHz version this time. In the next days, I'll do some testing with both the Arduino versions.

Thank you @ramapcsx2

greguz, 2020-03-06:
With the 16MHz version, I was able to boot my NTCS game, and The TV shows a nice "NTCS" label.

I confirm that with the 8MHz the TV is still running on PAL mode, I was not able to make it work.

Even with the 16MHz version, sometimes the game will not boot, like 15% of boots.

ramapcsx2, 2020-03-07:
Okay, thanks for the report :)
I'm not sure how to make this better though, maybe the chip isn't well suited for patching this early after power on.

greguz, 2020-03-07:
Thanks for the support. :)
Hopefully, in the next days, I'll do some more testing with other and more powerful boards.

Closed 2020-03-07.

Thread 21 (2020-02-20):

PM-41(2) PAL different layout

klode82, 2020-02-20:
I cannot find all points to made solders on my PCB. I'm working with an Arduino Nano with ATMega.

This is the PCB: [https://imgur.com/tgAdHI5](url)

ramapcsx2, 2020-02-20:
Try this:
https://i.imgur.com/68TnVRw.jpg

klode82, 2020-02-20:
Thanks a lot!, but is not too easy understand where the wired are connected on the Nano, and a wire is hidden (the pins 4 and 5...)
Thanks to your image, I've realized this one.

https://imgur.com/a/g9mkhkB

Please, can you help me to identify D4 and D5?

Thanks.

ramapcsx2, 2020-02-20:
Sorry, I don't have a board out to find the pins.

klode82, 2020-02-20:
Don't worry, I've found all Pins.

https://imgur.com/vJZQBQL

I'll try as soon as possible.

Closed 2023-04-28.

Thread 24 (2020-12-07):

ESP8266 Support?

INVALID-CLIENT, 2020-12-07:
Will this be able to work with a ESP8266?

ramapcsx2, 2020-12-09:
Of course, but you'll have to port it :)

INVALID-CLIENT, 2020-12-10:
> Of course, but you'll have to port it :)

I'm new with arduinos. How would one possibly port it to the ESP8266? Would I just change the pin layout in the .ino file? Or is there more to it?

Closed 2023-04-28.

Thread 25 (2020-12-11):

PS2 Compatibility?

LackofTrack, 2020-12-11:
Hi, I was wondering if this mod chip could be installed in a PS2. I've tracked down all the pins required but I don't know if the PS2 acts different to the PS1. If so, is there anyway to make it work?

LackofTrack, 2020-12-16:
Anybody? @ramapcsx2?

ramapcsx2, 2020-12-16:
Oh, this is probably a bad idea.
The theory of operation could apply on a PS2, but due to the various differences, it would basically be whole new project.

I once got a very simple (unlock symbol spamming) modchip working in the PS2, so if you simply use an old 4 wire chip code, that would do it.
The bigger issue is with all the software protections.

LackofTrack, 2020-12-16:
I assume the 4 wire method wouldn't allow for anti modchip games right? That's a bummer, but thanks for answering. Is the PS2 really that different in PS1 mode? I always assumed they would be virtually identical.

ramapcsx2, 2020-12-16:
Yes, a lot of details are different. The hardware is (obviously) PS2 chips, but configured to run in a backward compatible mode.
The tricks to fool the PSX hardware don't apply 1to1.

LackofTrack, 2020-12-19:
I made my own stealth modchip for the PS2 with the help of your code. I found a handy signal that goes low until the PS2 enters PSX mode. From there I just use your code. It works pretty well for the most part.

DraconicNEO, 2021-01-19:
> I made my own stealth modchip for the PS2 with the help of your code. I found a handy signal that is High until the PS2 enters PSX mode (I just spam the unlock symbol while in PS2 mode). From there I just use your code. It works pretty well for the most part.

Is this for PS1 games on PS2 or is it an actual PS2 modchip? For some reason no one else has had the idea of using an Arduino as a PS2 modchip (Just PS1).

LackofTrack, 2021-01-24:
Sorry, it's just for PS1 games. PS2 modchips seem to be a bit more complicated, perhaps too much for an Arduino.

LMS737, 2021-01-25:
@LackofTrack Hello. I am also interested in getting this to work for PS1 mode inside a PS2. You said that you found a handy signal that indicates the current mode. Do you mind telling us which signal, and where you tapped it from, so it might also help others out?

Also I wonder what you meant by "works well for the most part". What issues did you encounter, and did you manage to solve it?

DraconicNEO, 2021-01-25:
>
>
> Sorry, it's just for PS1 games. PS2 modchips seem to be a bit more complicated, perhaps too much for an Arduino.

Maybe it would work with the Raspberry Pi Pico, or if Not that I'm sure it would defiantly work with a raspberry Pi zero.

LackofTrack, 2021-01-27:
@LMS737 I believe the signal I used was 'GFS', at least that's what the Service Manual calls it. I'm not actually sure what the signal is for but it stays HIGH until the PS2 enters PS1 Mode. So you can use it to determine where you are in the boot process. You'll also have to wire a Reset signal if you want it to work when you reset the console. You can do this by wiring the reset button on the Arduino to the power button on the PS2.

> Also I wonder what you meant by "works well for the most part". What issues did you encounter, and did you manage to solve it?
It only works if you directly go into the game from boot up, meaning you can't go to the menu and then insert your game. I haven't figure out why it won't work when booting from the menu, but for my case it really doesn't matter.

Closed 2023-04-28.

Thread 28 (2021-01-02):

PU-23 and ATtiny45

Jambul46, 2021-01-02:
can someone please post me wiring diagram for ATtiny45 i can't find it and i don't want to mess it up.

PS MdN:SCPH-9002 PU-23.

Thanks.

Jambul46, 2021-01-02:
and i don't understand this
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

kalymos, 2021-01-03:
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

Jambul46, 2021-01-03:
yeah i know but i would need something like this
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

But TY.

Jambul46, 2021-01-03:
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

Something like this?

Jambul46, 2021-01-03:
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
?

kalymos, 2021-01-03:
yes I think that's it, it's been a long time since I modded a ps.

Jambul46, 2021-01-03:
Ok Thanks.

Jambul46, 2021-01-05:
just want to ask i have PAL PSone and i the code it says that bios patch is not supported
and when i put i game it says me "Please Insert PlayStation CD-ROM"

Jambul46, 2021-01-05:
oh only for PM-41 so  do i have to enable it?

Jambul46, 2021-01-06:
Nice it work's i had to select default region

wyatt8740, 2021-04-06:
You can also just get ground off the "disc lid" switch.

Sorry about the miscellaneous gore on this board. It was a parts board I revitalized.

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

Closed 2023-04-28.

Thread 30 (2021-04-24):

A problem with PM-41 NTSC-J board PM-41 (2) -71

eduardokenj, 2021-04-24:
I have issue with backup games burned in CD-R, some times jump to cd player or go to red screen "please insert PlayStation disc", here is the logs from the boot. I used an a arduino pro mini and programmed it with ISP.
[STREETFIHGTERCOLLECTION2-BKP_SCEA.txt](https://github.com/kalymos/PsNee/files/6370776/STREETFIHGTERCOLLECTION2-BKP_SCEA.txt)
[TEKKEN3-BKP_SCEI.txt](https://github.com/kalymos/PsNee/files/6370777/TEKKEN3-BKP_SCEI.txt)
[MEGAMANX5-BKP_SCEA.txt](https://github.com/kalymos/PsNee/files/6370778/MEGAMANX5-BKP_SCEA.txt)
[R4_RIDGERACERTYPE4-BKP_SCEA.txt](https://github.com/kalymos/PsNee/files/6370779/R4_RIDGERACERTYPE4-BKP_SCEA.txt)

and here the logs from original disks
[ACECOMBAT3-OG_SCEI.txt](https://github.com/kalymos/PsNee/files/6370780/ACECOMBAT3-OG_SCEI.txt)
[MGS-OG_SCEA.txt](https://github.com/kalymos/PsNee/files/6370781/MGS-OG_SCEA.txt)

PS: my installation is correct and CD-R run in PS2

Closed 2023-04-28.

Thread 32 (2021-09-08):

ISS Pro Evolution not booting on my SCPH-102 with PSNee 7.01

MrGasS, 2021-09-08:
My "daily driver" PS1 is an SCPH-102, with PM-41(A) motherboard, manufactured during year 2000 and with a PSNee 7.01 that I installed in September 2019 (Arduino Pro Mini 5v/16MhZ clone as I remember).

I used this console a lot and it reads everything.

Yesterday I tried to run two versions of ISS Pro Evolution :
-SLES-02095-P / ENG-FR-DE (on Ritek Co. 97m15s17f/Pioneer burner at 4x speed/IMGBurn)
-SLES-02424 / ITA-ESP (on Ritek Co. 97m15s17f/Pioneer burner at 4x speed/IMGBurn and CMC Magnetics Corp. 97m26s66f/LG-Hitachi burner at 16x speed/IMGBurn)

This specific PSOne with PSNee goes straight into the Audio CD Player screen without booting these games.

These three discs work with my other consoles like PS1 (5502,9002,102,102c) with Mayumi4/OneChip and PS2 (39004,50004,70004) with Modbo 5.0.

What could be the problem?

EDIT 23-9-2021
WORKAROUND: I successfully booted ISS Pro Evolution on my PSNee PSOne both with TonyHax boot CD and memory card exploit (currently at version 1.4.3)

Closed 2023-04-28.

Thread 33 (2022-04-04):

How to tell if Fuses are correct?

jayjr1105, 2022-04-04:
I remember a while back having to use AVRdude to manually set fuses on ATTINY85's for them to work in a PM-41.  I just did a couple new ATTINY85's and I can't tell from the output but it's possible burning the bootloader is not setting the fuses as it should?

https://ghostbin.com/DEgrU/raw

kalymos, 2022-04-04:
From memory, the fuse is not modified by burning the PsNee.

Thread 35 (2022-12-09):

Works great with an ATtiny85 on a PU-8

lagomorph, 2022-12-09:
No issue, just wanted to report success. Serial debug even works at 115200 which surprises me a bit. Every once in a while I'll get the play CD screen with a burned CD but it's pretty rare. Cool stuff!

some-git-user, 2023-01-13:
@lagomorph sorry for taking over your thread, but maybe you could give me some help with attiny85.
I programmed the attiny85 with ardiuno as ISP without a problem.
But after soldering, the PU-23 does not read any game disc. Neither originals nor backups. After reading the disc, the ps1 stuck at "please insert ps1 disc" screen.
But audio CDs working fine.

kalymos, 2023-01-13:
It seems to me of memory it can be the internet clock of 85, which is not perfect.I will see if I find the parameter of the code to modify

lagomorph, 2023-01-13:
Not sure about the PU-23. Are you able to get debug info out of it by defining PSNEEDEBUG? If I connect it up to a console I get something like:

m 0
41000101234900000200257F
41000101235000000200FCFF
010002012351000024669F7F
01000201235200002466FCFF
010002012353000024669F7F
01000301235400054454FCFF
010003012355000544549F7F
01000301235600054454FCFF
010004012357001019509F7F
01000401235800101950FCFF
010004012359001019509F7F
01000501236000154026FCFF
010005012361001540269F7F
01000501236200154026FCFF
!
410100000006000001699F7F
41010000000500000170FCFF
410100000004000001719F7F
41010000000300000172FCFF
410100000002000001739F7F
41010000000100000174FCFF
410100000009000001669F7F
41010000000800000167FCFF
410100000007000001689F7F
41010000000600000169FCFF
410100000005000001709F7F
41010000000400000171FCFF
410100000003000001729F7F
41010000000200000173FCFF
410100000001000001749F7F
41010000000900000166FCFF
410100000008000001679F7F
41010000000700000168FCFF
410100000006000001699F7F
41010000000500000170FCFF
410100000004000001719F7F
41010000000300000172FCFF
410100000002000001739F7F
41010000000100000174FCFF
410100000009000001669F7F
41010000000800000167FCFF
410100000007000001689F7F
41010000000600000169FCFF
...

kalymos, 2023-01-13:
If you want more info on serial output, you can find more info on the original forum. http://www.psxdev.net/forum/viewtopic.php?f=47&t=1262&start=40
Because there frankly it is beyond my poor memory;)

some-git-user, 2023-01-14:
Ok, thank you guys. It's my first programmed chip ever. Will try to enable debugging.

kalymos, 2023-01-14:
Welcome. I never tested the debug on the Attiny, but it seems to me that the output is a little different from the Atmeg

some-git-user, 2023-01-15:
Can confirm it's working on PU-23, but can't really tell why. Tested with Dino Crisis.
Only thing I changed, is the define PSNEEDEBUG flag, but didn't need to debug yet.
Also this time, I choose "Burn Bootloader" before flashing the Attiny85.
Is this even necessary and I forget it in the first place?

kalymos, 2023-01-16:
It's not necessary.
Arduino bootloader operation introduces boot latency, which prevents proper operation of PsNee if you boot the console with a CD in it.

The bootloader is only necessary, when you want to program with the TxTr interface, if you prefer the SIP which does not need a bootloader.

lagomorph, 2023-01-16:
Burning the bootloader also sets the fuses. Maybe an old fuse value was causing issues. 🤷‍♂️

kalymos, 2023-01-16:
I didn't know that it modifies the fuses, it's always good to take as a trick

Closed 2023-04-28.

Thread 36 (2022-12-10):

Arduino Mini Pro 3.3v 8mhz and Japanese PU-7 SCPH-1000. Is there any additional step?

odelot, 2022-12-10:
Hi. First of all, thanks for the amazing job!

I've tried to use Arduino pro mini 8mhz 3.3v, using the Arduino Uno as an ISP programmer, but it didn't work.

Does this version only work with NTSC PU-7?

Can you give me some direction so I can debug what is happening?

Thanks in advance

odelot, 2022-12-10:
forget about it. took another arduino and worked great, thanksss

Closed 2022-12-10.

Thread 37 (2022-12-13):

Pro Micro pinout column was deleted from readme

wyatt8740, 2022-12-13:
What was the reasoning for deleting the ProMicro column from the table in the README?

It still claims to be "supported" in the readme, but the pinout i tested and contributed was removed in https://github.com/kalymos/PsNee/commit/df44218ea28a6499ee7ff2a0575fc0931ad1dd85 with no explanation given.

Pins 15 and 14 on the ProMicro are not labeled as SCK and MISO on the ProMicro as they are on the Leonardo. They are labeled 15 and 14.

I suspect that's what https://github.com/kalymos/PsNee/issues/31 is asking about.

kalymos, 2022-12-13:
Hello
I removed the promicro because it has the same pin-out as the Arduino uno.
iI is true that I should specify, Arduino Uno and ATMega 368

Closed 2023-04-28.

Thread 39 (2022-12-31):

Update information on the PSX copy protection

david4599, 2022-12-31:
Hi, I noticed that the "PLAYSTATION 1 SECURITY - HOW IT DOES ITS THING" paragraph is really outdated and should be updated to gather clearer and accurate information, e.g.:

> very little pits and ehm... little not-pits

The "not-pits" are called lands.

> The nifty Sony engineers did not use the pits and stuff to store the security checks for Playstation discs, but went crazy with the rolled up carrier string.

The engineers were not as crazy as it sounds like. They just replaced the 22kHz frequency modulated ATIP (Absolute Time In Pregroove) signal useful for burning only by the 250bps SCEx string (same 22kHz frequency but amplitude modulated).

> the Sony engineers decidedly "fumbled up" the track of sector 4 on a Playstation disc (the track was modulated, in nerd-speak) so that the error correction circuit outputs a recognisable signal, as the laser needs to be corrected to follow the track optimally. This output signal actually is a 250bps serial bitstream

We know the sector 4 has nothing to do with the 250bps SCEx string which is actually located all over the lead-in (I can confirm from my experiments that it begins at least from the middle of it, around sector -6000 and stops just before sector 0). The sector 4 can be seen in any PSX CD image file and contains the license string we see on the boot screen with the 3D PlayStation logo.

kalymos, 2023-01-13:
The part of the text where you propose modifications had been written by the person who had modified the code the most, unfortunately she is no longer really active on this project.
Personally, I was more concerned with trying to gather the documentation, I don't have enough knowledge, in English and in the operation of the system, to modify this part of the text.
 For these different reasons if you feel the courage to send me a version of the improved text I would be grateful.

david4599, 2023-01-17:
I am not the best in English either but here is what would be the modified text, maybe too long but should be accurate enough and hopefully without errors.
And actually, "not-pit" is technically not wrong but the term "land" is always used to designate the opposite of pit.

### The PlayStation 1 security, how does it work?

To protect its precious PlayStation from running unauthorized software, Sony implemented a copy protection mechanism based on a simple ASCII string of text that is read from a part of an original PlayStation disc that cannot be reproduced by an ordinary PC CD burner.

Basically, a CD is made from a really long spiral of pits and lands that represent the data stored on the disc. Inside the Optical Pickup Unit (OPU), a laser diode emits infrared light that goes through lenses and mirrors, hits the disc, bounces back and shines on a sensor made from at least 4 photodiodes. These photodiodes receive different amounts of light depending on pits and lands' reflectivity allowing to recover the data but they are also used to perform self-adjustment to keep the track aligned and in focus.
This is done by comparing photodiodes outputs in a way to create the Tracking Error (TE) and Focus Error (FE) signals and then send them to the CD controller to move the lens head horizontally for the tracking and vertically for the focus.

On a CD-ROM (read-only disc pressed inside a CD factory), the spiral is a simple rolled up line. However, on a blank CD-R, the spiral i.e. the pregroove is wobbling on all over the disc and the CD controller follows it. This wobble picked up by the TE signal actually carries data known as the Absolute Time In Pregroove (ATIP) and is frequency-modulated at 22kHz (1x read speed). The ATIP contains information about the disc characteristics but is useful only for burning.

Now, what is the relation between these explanations and the PlayStation security?

As PlayStation discs are read-only mediums, they do not need the ATIP. Sony engineers surely thought:

> Why not reuse the wobble that burners can't reproduce (in theory) to encode some sort of information that will provide copy protection?

And that's what they did! In the lead-in area of a PlayStation disc (negative sectors), the spiral is wobbling at the same 22kHz frequency like a CD-R but instead of storing the ATIP, they stored a 250bps amplitude-modulated serial bitstream (with 1 start bit and 2 stop bits) that repeats until sector 0 (end of lead-in).

The important thing to understand is the bitstream is not part of the game data which is encoded using pits and lands' length. Instead, it is made by slightly shifting the pits and lands' position. The self-adjusting system simply follows this wobbling track creating a modulated TE signal that needs to be demodulated using a 22kHz filter. Then, it goes to the PlayStation sub-CPU for decoding.

The bitstream in plain ASCII says "SCEA" (Sony Computer Entertainment of America), "SCEE" (Sony Computer Entertainment of Europe) or "SCEI" (Sony Computer Entertainment Inc. (i.e. Japan)), depending on the region of the disc.
The security thus functions not only as copy protection, but also as region protection.

The text string from the disc is compared with the one that is embedded in the PlayStation sub-CPU. If these text strings are the same, the disc is interpreted to be authentic and from the correct region. Bingo!

kalymos, 2023-01-17:
great, I'll take a look to get this straightened out when I get back from vacation ;)

kalymos, 2023-02-05:
I went home, reread the text, and made the changes.
Thank you for your contribution.

david4599, 2023-02-06:
You're welcome!

Closed 2023-02-06.

Thread 40 (2023-01-28):

RPi Pico support?

xslendix, 2023-01-28:
Those are some really cheap microcontrollers, and are easy to come by. I think having support for those would be quite cool.

VoxelTek, 2023-04-27:
I agree, and I'm trying to port the code to it now. I literally have not tested this code and am not an Arduino or PS1 security guru by any means, but I figure I might as well give it a shot.

[https://github.com/VoxelTek/PicoNee](https://github.com/VoxelTek/PicoNee)

kalymos, 2023-04-28:
Good initiative, here I will keep the code for attiny and attmega.
Tell me when the code will be functional I will put a link.

Le ven. 28 avr. 2023 à 01:06, VoxelTek ***@***.***> a écrit :

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

remoitrix, 2023-06-14:
Hi!
I compiled the code and show this errors;

In file included from C:\Users\thesp\AppData\Local\Arduino15\packages\Seeeduino\hardware\rp2040\2.7.2\variants\SEEED_XIAO_RP2040/pinmode_arduino.h:30:0,
                 from C:\Users\thesp\AppData\Local\Arduino15\packages\Seeeduino\hardware\rp2040\2.7.2\cores\arduino/Arduino.h:26,
                 from C:\Users\thesp\AppData\Local\Temp\arduino\sketches\05397FCBE827B03C5F7D492FE9E31C1C\sketch\sketch_jun14a.ino.cpp:1:
C:\Users\thesp\Desktop\mods\psone hard-softmod\Mod cambio Bios\PsNee-7.01\PsNee-7.01\test\sketch_jun14a\sketch_jun14a.ino: In function 'void inject_SCEX(char)':
C:\Users\thesp\Desktop\mods\psone hard-softmod\Mod cambio Bios\PsNee-7.01\PsNee-7.01\test\sketch_jun14a\sketch_jun14a.ino:103:24: error: 'PINB' was not declared in this scope
   #define GATEWFCKPORT PINB   // MCU port for the gate input (used for WFCK)
                        ^
C:\Users\thesp\AppData\Local\Arduino15\packages\Seeeduino\hardware\rp2040\2.7.2\cores\arduino/api/Common.h:67:32: note: in definition of macro 'bitClear'
 #define bitClear(value, bit) ((value) &= ~(1UL << (bit)))
                                ^~~~~
C:\Users\thesp\Desktop\mods\psone hard-softmod\Mod cambio Bios\PsNee-7.01\PsNee-7.01\test\sketch_jun14a\sketch_jun14a.ino:174:16: note: in expansion of macro 'GATEWFCKPORT'
       bitClear(GATEWFCKPORT, DATABIT); // data low
                ^~~~~~~~~~~~
C:\Users\thesp\Desktop\mods\psone hard-softmod\Mod cambio Bios\PsNee-7.01\PsNee-7.01\test\sketch_jun14a\sketch_jun14a.ino:103:24: note: suggested alternative: 'SING'
   #define GATEWFCKPORT PINB   // MCU port for the gate input (used for WFCK)
                        ^
C:\Users\thesp\AppData\Local\Arduino15\packages\Seeeduino\hardware\rp2040\2.7.2\cores\arduino/api/Common.h:67:32: note: in definition of macro 'bitClear'
 #define bitClear(value, bit) ((value) &= ~(1UL << (bit)))
                                ^~~~~
C:\Users\thesp\Desktop\mods\psone hard-softmod\Mod cambio Bios\PsNee-7.01\PsNee-7.01\test\sketch_jun14a\sketch_jun14a.ino:174:16: note: in expansion of macro 'GATEWFCKPORT'
       bitClear(GATEWFCKPORT, DATABIT); // data low
                ^~~~~~~~~~~~
C:\Users\thesp\Desktop\mods\psone hard-softmod\Mod cambio Bios\PsNee-7.01\PsNee-7.01\test\sketch_jun14a\sketch_jun14a.ino:103:24: error: 'PINB' was not declared in this scope
   #define GATEWFCKPORT PINB   // MCU port for the gate input (used for WFCK)
                        ^
C:\Users\thesp\AppData\Local\Arduino15\packages\Seeeduino\hardware\rp2040\2.7.2\cores\arduino/api/Common.h:65:32: note: in definition of macro 'bitRead'
 #define bitRead(value, bit) (((value) >> (bit)) & 0x01)
                                ^~~~~
C:\Users\thesp\Desktop\mods\psone hard-softmod\Mod cambio Bios\PsNee-7.01\PsNee-7.01\test\sketch_jun14a\sketch_jun14a.ino:183:38: note: in expansion of macro 'GATEWFCKPORT'
           bool wfck_sample = bitRead(GATEWFCKPORT, GATEWFCKBIT);
                                      ^~~~~~~~~~~~
C:\Users\thesp\Desktop\mods\psone hard-softmod\Mod cambio Bios\PsNee-7.01\PsNee-7.01\test\sketch_jun14a\sketch_jun14a.ino:103:24: note: suggested alternative: 'SING'
   #define GATEWFCKPORT PINB   // MCU port for the gate input (used for WFCK)
                        ^
C:\Users\thesp\AppData\Local\Arduino15\packages\Seeeduino\hardware\rp2040\2.7.2\cores\arduino/api/Common.h:65:32: note: in definition of macro 'bitRead'
 #define bitRead(value, bit) (((value) >> (bit)) & 0x01)
                                ^~~~~
C:\Users\thesp\Desktop\mods\psone hard-softmod\Mod cambio Bios\PsNee-7.01\PsNee-7.01\test\sketch_jun14a\sketch_jun14a.ino:183:38: note: in expansion of macro 'GATEWFCKPORT'
           bool wfck_sample = bitRead(GATEWFCKPORT, GATEWFCKBIT);
                                      ^~~~~~~~~~~~
C:\Users\thesp\Desktop\mods\psone hard-softmod\Mod cambio Bios\PsNee-7.01\PsNee-7.01\test\sketch_jun14a\sketch_jun14a.ino:104:20: error: 'PORTB' was not declared in this scope
   #define DATAPORT PORTB      // MCU port for the gate input (used for WFCK)
                    ^
C:\Users\thesp\AppData\Local\Arduino15\packages\Seeeduino\hardware\rp2040\2.7.2\cores\arduino/api/Common.h:66:30: note: in definition of macro 'bitSet'
 #define bitSet(value, bit) ((value) |= (1UL << (bit)))
                              ^~~~~
C:\Users\thesp\Desktop\mods\psone hard-softmod\Mod cambio Bios\PsNee-7.01\PsNee-7.01\test\sketch_jun14a\sketch_jun14a.ino:184:11: note: in expansion of macro 'bitWrite'
           bitWrite(DATAPORT, DATABIT, wfck_sample); // output wfck signal on data pin
           ^~~~~~~~
C:\Users\thesp\Desktop\mods\psone hard-softmod\Mod cambio Bios\PsNee-7.01\PsNee-7.01\test\sketch_jun14a\sketch_jun14a.ino:184:20: note: in expansion of macro 'DATAPORT'
           bitWrite(DATAPORT, DATABIT, wfck_sample); // output wfck signal on data pin
                    ^~~~~~~~
C:\Users\thesp\Desktop\mods\psone hard-softmod\Mod cambio Bios\PsNee-7.01\PsNee-7.01\test\sketch_jun14a\sketch_jun14a.ino:103:24: error: 'PINB' was not declared in this scope
   #define GATEWFCKPORT PINB   // MCU port for the gate input (used for WFCK)
                        ^
C:\Users\thesp\AppData\Local\Arduino15\packages\Seeeduino\hardware\rp2040\2.7.2\cores\arduino/api/Common.h:67:32: note: in definition of macro 'bitClear'
 #define bitClear(value, bit) ((value) &= ~(1UL << (bit)))
                                ^~~~~
C:\Users\thesp\Desktop\mods\psone hard-softmod\Mod cambio Bios\PsNee-7.01\PsNee-7.01\test\sketch_jun14a\sketch_jun14a.ino:196:12: note: in expansion of macro 'GATEWFCKPORT'
   bitClear(GATEWFCKPORT, DATABIT); // pull data low
            ^~~~~~~~~~~~
C:\Users\thesp\Desktop\mods\psone hard-softmod\Mod cambio Bios\PsNee-7.01\PsNee-7.01\test\sketch_jun14a\sketch_jun14a.ino:103:24: note: suggested alternative: 'SING'
   #define GATEWFCKPORT PINB   // MCU port for the gate input (used for WFCK)
                        ^
C:\Users\thesp\AppData\Local\Arduino15\packages\Seeeduino\hardware\rp2040\2.7.2\cores\arduino/api/Common.h:67:32: note: in definition of macro 'bitClear'
 #define bitClear(value, bit) ((value) &= ~(1UL << (bit)))
                                ^~~~~
C:\Users\thesp\Desktop\mods\psone hard-softmod\Mod cambio Bios\PsNee-7.01\PsNee-7.01\test\sketch_jun14a\sketch_jun14a.ino:196:12: note: in expansion of macro 'GATEWFCKPORT'
   bitClear(GATEWFCKPORT, DATABIT); // pull data low
            ^~~~~~~~~~~~
C:\Users\thesp\Desktop\mods\psone hard-softmod\Mod cambio Bios\PsNee-7.01\PsNee-7.01\test\sketch_jun14a\sketch_jun14a.ino: In function 'void setup()':
C:\Users\thesp\Desktop\mods\psone hard-softmod\Mod cambio Bios\PsNee-7.01\PsNee-7.01\test\sketch_jun14a\sketch_jun14a.ino:296:3: error: 'ADCSRA' was not declared in this scope
   ADCSRA = ADCSRA & B01111111;
   ^~~~~~
C:\Users\thesp\Desktop\mods\psone hard-softmod\Mod cambio Bios\PsNee-7.01\PsNee-7.01\test\sketch_jun14a\sketch_jun14a.ino:296:3: note: suggested alternative: 'ADC0'
   ADCSRA = ADCSRA & B01111111;
   ^~~~~~
   ADC0
C:\Users\thesp\Desktop\mods\psone hard-softmod\Mod cambio Bios\PsNee-7.01\PsNee-7.01\test\sketch_jun14a\sketch_jun14a.ino:298:3: error: 'ACSR' was not declared in this scope
   ACSR = B10000000;
   ^~~~
C:\Users\thesp\Desktop\mods\psone hard-softmod\Mod cambio Bios\PsNee-7.01\PsNee-7.01\test\sketch_jun14a\sketch_jun14a.ino:300:3: error: 'DIDR0' was not declared in this scope
   DIDR0 = DIDR0 | B00111111;
   ^~~~~
C:\Users\thesp\Desktop\mods\psone hard-softmod\Mod cambio Bios\PsNee-7.01\PsNee-7.01\test\sketch_jun14a\sketch_jun14a.ino:300:3: note: suggested alternative: 'DIR'
   DIDR0 = DIDR0 | B00111111;
   ^~~~~
   DIR
In file included from C:\Users\thesp\AppData\Local\Arduino15\packages\Seeeduino\hardware\rp2040\2.7.2\variants\SEEED_XIAO_RP2040/pinmode_arduino.h:30:0,
                 from C:\Users\thesp\AppData\Local\Arduino15\packages\Seeeduino\hardware\rp2040\2.7.2\cores\arduino/Arduino.h:26,
                 from C:\Users\thesp\AppData\Local\Temp\arduino\sketches\05397FCBE827B03C5F7D492FE9E31C1C\sketch\sketch_jun14a.ino.cpp:1:
C:\Users\thesp\Desktop\mods\psone hard-softmod\Mod cambio Bios\PsNee-7.01\PsNee-7.01\test\sketch_jun14a\sketch_jun14a.ino: In function 'void loop()':
C:\Users\thesp\Desktop\mods\psone hard-softmod\Mod cambio Bios\PsNee-7.01\PsNee-7.01\test\sketch_jun14a\sketch_jun14a.ino:100:20: error: 'PIND' was not declared in this scope
   #define SUBQPORT PIND       // 1MCU port for the 2 SUBQ sampling inputs
                    ^
C:\Users\thesp\AppData\Local\Arduino15\packages\Seeeduino\hardware\rp2040\2.7.2\cores\arduino/api/Common.h:65:32: note: in definition of macro 'bitRead'
 #define bitRead(value, bit) (((value) >> (bit)) & 0x01)
                                ^~~~~
C:\Users\thesp\Desktop\mods\psone hard-softmod\Mod cambio Bios\PsNee-7.01\PsNee-7.01\test\sketch_jun14a\sketch_jun14a.ino:326:20: note: in expansion of macro 'SUBQPORT'
     while (bitRead(SUBQPORT, SQCKBIT) == 1) {
                    ^~~~~~~~
C:\Users\thesp\Desktop\mods\psone hard-softmod\Mod cambio Bios\PsNee-7.01\PsNee-7.01\test\sketch_jun14a\sketch_jun14a.ino:100:20: note: suggested alternative: 'PIN_D5'
   #define SUBQPORT PIND       // 1MCU port for the 2 SUBQ sampling inputs
                    ^
C:\Users\thesp\AppData\Local\Arduino15\packages\Seeeduino\hardware\rp2040\2.7.2\cores\arduino/api/Common.h:65:32: note: in definition of macro 'bitRead'
 #define bitRead(value, bit) (((value) >> (bit)) & 0x01)
                                ^~~~~
C:\Users\thesp\Desktop\mods\psone hard-softmod\Mod cambio Bios\PsNee-7.01\PsNee-7.01\test\sketch_jun14a\sketch_jun14a.ino:326:20: note: in expansion of macro 'SUBQPORT'
     while (bitRead(SUBQPORT, SQCKBIT) == 1) {
                    ^~~~~~~~
C:\Users\thesp\Desktop\mods\psone hard-softmod\Mod cambio Bios\PsNee-7.01\PsNee-7.01\test\sketch_jun14a\sketch_jun14a.ino:100:20: error: 'PIND' was not declared in this scope
   #define SUBQPORT PIND       // 1MCU port for the 2 SUBQ sampling inputs
                    ^
C:\Users\thesp\AppData\Local\Arduino15\packages\Seeeduino\hardware\rp2040\2.7.2\cores\arduino/api/Common.h:65:32: note: in definition of macro 'bitRead'
 #define bitRead(value, bit) (((value) >> (bit)) & 0x01)
                                ^~~~~
C:\Users\thesp\Desktop\mods\psone hard-softmod\Mod cambio Bios\PsNee-7.01\PsNee-7.01\test\sketch_jun14a\sketch_jun14a.ino:339:21: note: in expansion of macro 'SUBQPORT'
     while ((bitRead(SUBQPORT, SQCKBIT)) == 0);
                     ^~~~~~~~
C:\Users\thesp\Desktop\mods\psone hard-softmod\Mod cambio Bios\PsNee-7.01\PsNee-7.01\test\sketch_jun14a\sketch_jun14a.ino:100:20: note: suggested alternative: 'PIN_D5'
   #define SUBQPORT PIND       // 1MCU port for the 2 SUBQ sampling inputs
                    ^
C:\Users\thesp\AppData\Local\Arduino15\packages\Seeeduino\hardware\rp2040\2.7.2\cores\arduino/api/Common.h:65:32: note: in definition of macro 'bitRead'
 #define bitRead(value, bit) (((value) >> (bit)) & 0x01)
                                ^~~~~
C:\Users\thesp\Desktop\mods\psone hard-softmod\Mod cambio Bios\PsNee-7.01\PsNee-7.01\test\sketch_jun14a\sketch_jun14a.ino:339:21: note: in expansion of macro 'SUBQPORT'
     while ((bitRead(SUBQPORT, SQCKBIT)) == 0);
                     ^~~~~~~~
C:\Users\thesp\Desktop\mods\psone hard-softmod\Mod cambio Bios\PsNee-7.01\PsNee-7.01\test\sketch_jun14a\sketch_jun14a.ino:100:20: error: 'PIND' was not declared in this scope
   #define SUBQPORT PIND       // 1MCU port for the 2 SUBQ sampling inputs
                    ^
C:\Users\thesp\AppData\Local\Arduino15\packages\Seeeduino\hardware\rp2040\2.7.2\cores\arduino/api/Common.h:65:32: note: in definition of macro 'bitRead'
 #define bitRead(value, bit) (((value) >> (bit)) & 0x01)
                                ^~~~~
C:\Users\thesp\Desktop\mods\psone hard-softmod\Mod cambio Bios\PsNee-7.01\PsNee-7.01\test\sketch_jun14a\sketch_jun14a.ino:341:22: note: in expansion of macro 'SUBQPORT'
     sample = bitRead(SUBQPORT, SUBQBIT);
                      ^~~~~~~~
C:\Users\thesp\Desktop\mods\psone hard-softmod\Mod cambio Bios\PsNee-7.01\PsNee-7.01\test\sketch_jun14a\sketch_jun14a.ino:100:20: note: suggested alternative: 'PIN_D5'
   #define SUBQPORT PIND       // 1MCU port for the 2 SUBQ sampling inputs
                    ^
C:\Users\thesp\AppData\Local\Arduino15\packages\Seeeduino\hardware\rp2040\2.7.2\cores\arduino/api/Common.h:65:32: note: in definition of macro 'bitRead'
 #define bitRead(value, bit) (((value) >> (bit)) & 0x01)
                                ^~~~~
C:\Users\thesp\Desktop\mods\psone hard-softmod\Mod cambio Bios\PsNee-7.01\PsNee-7.01\test\sketch_jun14a\sketch_jun14a.ino:341:22: note: in expansion of macro 'SUBQPORT'
     sample = bitRead(SUBQPORT, SUBQBIT);
                      ^~~~~~~~

exit status 1

Compilation error: 'PINB' was not declared in this scope

dazzaXx, 2024-03-18:
Is there any update on the ported pi version? I have a bunch of Picos and RP2040 Zeros that I could use with it.

remoitrix, 2024-03-18:
Nothing yet. I think that is a forgiven project.

VoxelTek, 2024-03-19:
Unfortunately, I didn't have the necessary hardware in order to test my code and such. I was unable to even get the original PSNee working, and as such testing and debugging my code is somewhat out of my reach.

Apologies to everyone involved, feel free to take over the project if you'd like to help continue my work.

dazzaXx, 2024-03-19:
No worries, I did try to also compile [kalymos's version of PicoNee](https://github.com/kalymos/PicoNee) and noticed some defines were apart of some sort of [port manipulation](https://docs.arduino.cc/retired/hacking/software/PortManipulation) being used, and because we try to compile for rp2040 boards, the code for them doesnt include this I assume, thats why it errors on PINB, PORTB, etc.

I'm no coder, but this is as far as I could get with figuring out why it doesnt like to compile.

Closed 2024-09-11.

Thread 42 (2023-04-25):

Should the RX and TX LED's be permamently on in the Pro Micro?

FaxMac, 2023-04-25:
Hello, After I installed the code via SPI to the Pro Micro that I am going to use for this project, I noticed that when powering on the board, the RX and TX LED's are constantly on, But while checking the code, I noticed that there is no logic or line that turns on those LED's.

To other users that used a Pro Micro in this project, Is this normal behavior?

FaxMac, 2023-04-27:
> hello, it maybe that the debugging option is used, if it used it constantly sends a data stream on the output Le mer. 26 avr. 2023 à 00:24, FaxMac ***@***.***> a écrit :
> […](#)
> Hello, After I installed the code via SPI to the Pro Micro that I am going to use for this project, I noticed that when powering on the board, the RX and TX LED's are constantly on, But while checking the code, I noticed that there is no logic or line that turns on those LED's. To other users that used a Pro Micro in this project, Is this normal behavior? — Reply to this email directly, view it on GitHub <#42>, or unsubscribe <https://github.com/notifications/unsubscribe-auth/ABDOKBHQBIRPLKJWQ2B4HM3XDBFKNANCNFSM6AAAAAAXLTQRRY> . You are receiving this because you are subscribed to this thread.Message ID: ***@***.***>

That's the thing, I remember specifically not uncommenting the #include debug

kalymos, 2023-04-27:
I took a look in the code, between line 250 and 256, we see that the serial
port is open under all conditions, and I'm not sure the right way to change
that.
Perhaps by commenting out lines 253 to 256, i tested the compilation it
passes, but it will be necessary to test if the mode is still functional
after that.

hope this is useful

Le jeu. 27 avr. 2023 à 02:53, FaxMac ***@***.***> a écrit :

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

Closed 2024-09-11.

Thread 43 (2023-07-22):

PM-41 NTSC J

some-git-user, 2023-07-22:
ATtiny85 does not load originals/backups from PAL region, but japanese originals/backups running fine.
I can repeatedly hear the disc spinning up/slowing down until I land in the memorycard/cd player menu.
While in the menu, the disc is still spinning up/slowing down (I don't see the "insert PS disc" screen).

wyatt8740, 2023-07-24:
Mid/Late model Japanese systems have to have the discs patched to claim to be NTSC-J or have their entire BIOS chips replaced, because there's a secondary check in the BIOS code that the modchip (which manipulates the mechacon) cannot bypass (yet, at least). The only PAL PSX that does this is the PM-41(2), and no north american units do the check.

So it's easiest to patch your game discs so that the BIOS thinks they're NTSC-J region. But it's not really something within the scope of this modchip to be able to fix (unless someone makes a hack like the one for the PAL PM-41(2) - which the ATTiny85 might not have enough pins to do anyway).

some-git-user, 2023-07-25:
Thanks for the explanation. I think this is very important information and should be written down in the Readme. Up until now I thought only PAL PM-41 boards needed a BIOS patch to run region free.

kalymos, 2024-09-11:
By the way if you are still interested, a new version is in the works that supports all Japanese models.

https://github.com/kalymos/PSNee_V8/tree/test2

Closed 2024-09-11.

Thread 44 (2023-08-10):

Disc not recognized as Standard Disc

Redsam121, 2023-08-10:
I keep getting this message when booting up either burned discs or originals. I'm using a schp-5502 from japan with an Arduino Pro Mini

The message translates to "This item is not a playstation standard disc"
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

Redsam121, 2023-08-13:
Nevermind I solved the problem. Discs needed to be patched with region before burning due to the Japanese models having extra region check components. Also the Arduino needed to be programmed with 5V not 3V.

Closed 2023-08-13.

Thread 45 (2023-09-10):

Question  about running mod

arminsalcin, 2023-09-10:
Hello,

Thanks for library, i used attiny85 and programmer avrisp i succesfully burned chip (with no bootloader) and 8Mhz internal clock but after installation i cant run original PAL game, my system is SCPH-101 with PM-41 (2) board it is also NTSC-U console

Question is :
- Can we still run original games after chip?
- Will PAL games work after the chip on NTSC console?
- Is burning fuses on attiny really necessary before uploading code via arduino IDE? (I didnt do this part)

kalymos, 2023-09-10:
Hello,

Overall the answer is yes to all three questions, for the fuses if you
install the Arduino bootloader, and then you burn the program again the
fuses remain.

But normally on SCP-101, you have to run the bios patch, which is not
really possible on ATtiny85.

Sorry

Le dim. 10 sept. 2023 à 20:28, Armin Salčin ***@***.***> a
écrit :

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

arminsalcin, 2023-09-10:
Thanks for the quick answer, i got confused by the bios patch [here](https://quade.co/ps1-modchip-guide/psnee/pm-41-2/) It says only if you have PAL SCP-101 to do bios patch, I will try with Arduino pro mini definitely to move out of probably mistakes with burning fuses.

Closed 2024-09-11.

Thread 46 (2023-11-28):

Incorrect pinouts in guide.pdf for PU-8

ger911man, 2023-11-28:
Here is photos from "PsNee modchip installation guide.pdf"
First photo: correct pinouts.
Second photo: SUBQ and SQCK should be swapped.
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

Her is my installation, it works flawlessly.
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

ger911man, 2024-04-02:
Of course you may use it.
Thank you.

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

Closed 2024-03-21.

Thread 47 (2023-12-15):

PU-8 playstation , using arduino mini pro 8 mhz, no disk detected with psnee

interfan, 2023-12-15:
PU-8 playstation , using arduino mini pro 8 mhz, no disk detected with psnee.

I have ps1 PU-8.

I used arduino mini pro 8mhz model.
PSNEE uploaded and the line for the mini uncommented.
All wires soldered as per diagram.
After the modchip is installed, the disks are spinning but i see the menu for the audio disk or memory card.
if i disconnect the chip the ps1 is working again with original disk.

What could be the issue?

kalymos, 2023-12-16:
hello a user pointed out to me that I had made an error in the wiring
diagram for the Pu-8 which I have just updated. check that you are using
the latest version of the PDF. If it persists it could be due to timing
issues.

Le sam. 16 déc. 2023 à 00:46, interfan ***@***.***> a écrit :

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

interfan, 2023-12-17:
My wiring is correct as per latest diagram.
I tried increasing the attempts to (inject symbols now. 2 x 3 runs seems optimal to cover all boards) from 2 to 3.
#define ARDUINO_328_BOARD
I have also tried #define APPLY_PSONE_PAL_BIOS_PATCH
I have also tried to set delay_between_injections o 72

Im tottaly blocked.....with this one.

Disk is spinning (original disk) , but i am sent to the screen for audio disk and memmory card.

How i can debug what is going on?
Any one with the same board that can help on this?

ba114, 2025-03-26:
What was the resolution to this? Im having the same problem with my PU-8

kalymos, 2025-03-26:
If you are using an 8MHz ATmega, the current code is more compatible.
maybe V7 version can work.
But if it is not that, to help you I will need the console number, we already have the motherboard number, I also need to know the number of your MCU, your compilation options, what is the compilation and injection chain that you used, and also a photo of the soldering.

ba114, 2025-03-26:
Fixed my issue. I was using AVRDUDESS GUI to flash the compiled HEX but i hadnt set the fuses correctly for ATTiny45. I was using v8.5 ino which doesnt actually specifically state the fuse values for the tiny (unless i missed it).

kalymos, 2025-03-26:
I'm very glad it's going to work for you, all the necessary information is in the Wiki, it's one of the big changes I made in this version.
It allowed me to better classify the information and include a lot of details.

Closed 2024-01-17.

Thread 48 (2023-12-25):

Cannot play ps1 backups with different region than console.

gufunkt-tacos, 2023-12-25:
I just modded my old PS1 (European, PU-22) with an ATtiny85 which has worked perfectly. However, when I tried to play Parasite Eve (the American version), it wouldn't get passed the initial screen. It says "SCEE" as well as "Sony Computer Entertainment America".

kalymos, 2023-12-27:
It is possible that the game has additional protection, but I don't have
the list in mind, I know for example that "resident evil nemesis" has this
kind of protection.

Le lun. 25 déc. 2023 à 21:29, Саймън Аткинсън ***@***.***> a
écrit :

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

Closed 2024-09-11.

Thread 49 (2024-01-17):

Help regarding ripped off point on sqck on PU-8    

interfan, 2024-01-17:
Help regarding ripped off point on sqck on PU-8!

Now even my original disk is not playing ! how to fix that where should i make connection?

🫥🫥🫥🫥🫥😥😥😥😥😥

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

interfan, 2024-01-17:
Fixed it, pin 3 on the otherside of the board chip CXD

Closed 2024-01-17.

Thread 51 (2024-03-21):

Docs: Nano: PSNee 3.3v in VIN not working

The-May, 2024-03-21:
I flashed bootloader via SPI and I couldnt get it to work.
I double checked wiring, solder points etc.
After some troubleshooting I found out that SPI VCC worked instead of VIN
This is mentioned in a older Video: https://www.youtube.com/watch?v=mhMCT63-h08

See Picture what i mean:
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

Maybe this should be changed (or at least mentioned?) in the modchip installation guide

kalymos, 2024-03-21:
Thanks for pointing this out to me because I made the same mistake in all
the diagrams, it's fixed 😅

Le jeu. 21 mars 2024 à 14:20, The-May ***@***.***> a écrit :

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

Closed 2024-03-21.

Thread 53 (2024-03-21):

Does PSNee need to be flashed via SPI for a PU-7 board?

dazzaXx, 2024-03-21:
Hi, just wondering if SPI flashing is needed for a PU-7 board, I have an Arduino Nano on the way and noticed some mentions of SPI flashing the comments of the .ino code file as well as around the web, I presume that is for the "PM-41 patching" portion but I just wanted to double check that it is fine to upload the code via the usb port.

Thanks!

kalymos, 2024-03-21:
The best is always to flash in isp, this eliminates the boot code.

The easiest way to do this is to transform an Arduino into an ISP
programmer, with the Arduino as ISP sketch

Le jeu. 21 mars 2024 à 21:14, dazzaXx ***@***.***> a écrit :

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

dazzaXx, 2024-03-21:
Do you have any recommendations for SPI Programmer sketches?

kalymos, 2024-03-22:
The one that is available in the Arduino ;)

https://docs.arduino.cc/built-in-examples/arduino-isp/ArduinoISP/

Le jeu. 21 mars 2024 à 23:23, dazzaXx ***@***.***> a écrit :

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

dazzaXx, 2024-03-22:
Thank you, I'm a bit of a noob when it comes to arduino and ive never used an ISP flasher before, i've only used the upload button in the IDE xD

dazzaXx, 2024-03-23:
Hi, i've just finished making a ISP flasher with my spare mega2560 I had lying around and tested flashing another arduino with it and it finally works! _(I'm not a coder at all so it took me HOURS to figure it out)_

So for now i'll close this issue so it's not left open. Now it's ready for when my nano arrives for PsNee!

Thanks for the help mate, I really do appreciate the help and tips. 👍

kalymos, 2024-03-23:
two little extra tips, using the ISP you can install the bootloader (in
Arduino choose the right card, and in the options installed the bootloader)
installing the bootloader with Arduino modifies part of the registers
(often called fuse ) which sometimes allows the Attiny to work correctly

Le sam. 23 mars 2024 à 01:40, dazzaXx ***@***.***> a écrit :

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

dazzaXx, 2024-03-23:
Is that needed for a Nano? I know when you flash with ISP it removes the bootloader for faster boot times which is needed for this use of PsNee, is the Burn Bootloader option for say if I wanted to upload normally to it again?

kalymos, 2024-03-23:
Normally it's not necessary for a Nano, and for the rest that's it

Le sam. 23 mars 2024 à 19:30, dazzaXx ***@***.***> a écrit :

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

Closed 2024-03-23.

Thread 54 (2024-03-25):

PU-7 all game discs being read as Audio CD's

dazzaXx, 2024-03-25:
Basically the title, i've installed PsNee with my arduino, but now, even with legit discs, it always kicks me to the CD player.

It's most likely me thats done something wrong, but what could it have been?

dazzaXx, 2024-03-25:
It seems it may have to do with the voltage the nano is recieving, i disconnected the 3.3v from the nano and plugged in a usb lead and it seemed to read them fine. I dont suppose there is any 5v pads i could test out?

kalymos, 2024-03-26:
For this project we always power the Arduino with 3.3v (we are at the limit
of the recommended voltage for a 16 mh clock), but this allows us to be
sure that the signal sent to the ps does not destroy it.
The first thing to check is the wiring.

Le lun. 25 mars 2024 à 22:24, dazzaXx ***@***.***> a écrit :

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

dazzaXx, 2024-03-26:
Well on my edits, the ps1 doesn't even read anything anymore, once the lid sensor is put down and released, the ps just spins forever until its reset, and the nano doesn't even output pulses to show when its injecting anymore.

I enabled debug and did see it was attempting to inject, but now nothing even happens.

dazzaXx, 2024-03-26:
It wouldn't suprise me if I've fried something on the board.

kalymos, 2024-03-26:
I won't tell you that you have to fear the worst.
If you read the output of the Arduino through the USB, there is no longer a
conflict between the USB power supply at 5v and the internal voltage of the
Playstation....

already trying to disconnect the VCC from the Arduino, and also unplug the
USB, this should prevent the Arduino from turning on

Le mar. 26 mars 2024 à 14:54, dazzaXx ***@***.***> a écrit :

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

dazzaXx, 2024-03-26:
Unfortunately I have already disconnected vcc and ground from the Arduino and even unplugged the usb. And the results were still the same.

kalymos, 2024-03-26:
Unfortunately I think she is dead R.I.P 😔

Le mar. 26 mars 2024 à 15:24, dazzaXx ***@***.***> a écrit :

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

dazzaXx, 2024-03-26:
No worries, I figured that was the case. Thank you for the help.

kalymos, 2024-03-26:
It may be an input output of the Arduino which is broken.
Personally I will install the bootloader and I will test the inputs and
outputs of the Arduino

Le mar. 26 mars 2024 à 18:20, dazzaXx ***@***.***> a écrit :

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

dazzaXx, 2024-03-26:
It could also be the fact that Ive made the wires too long, as I didnt read properly that theyre meant to be as short as possible.

dazzaXx, 2024-03-26:
Hi, I've finally fixed it and its working fully now. I shortened the wires as well as resoldered the ground on the nano as it turned out that it was loose.

Thanks again for the help and tips!

kalymos, 2024-03-26:
Glad to know all is well.
 good DIY

Le mar. 26 mars 2024 à 21:25, dazzaXx ***@***.***> a écrit :

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

Closed 2024-03-26.

Thread 57 (2024-10-05):

Psnee not working help

5a796d, 2024-10-05:
Can you give me a step by step guide? I have pal 5502 pu-18, pro micro 5v 16mhz (set on arduino to 5v 16mhz) flashed from arduino ide enabling atmega32x4 in the sketch, correctly connected the 4 wires plus power supply on vin pin at 3.5v as per the diagram but it doesn't work, it asks me insert the CD or start the games as if they were audio CDs. With modchip pic12c508 everything works, same thing with unirom cart. Thank you

kalymos, 2024-10-19:
Sorry for not responding earlier...
I am currently preparing the new version of the chip mode, with completely revised documentation.
Everything is available in this git [https://github.com/kalymos/PSNee_V8/tree/test2](https://github.com/kalymos/PSNee_V8/tree/test2)

Closed 2024-10-10.

Thread 58 (2024-11-16):

SCPH 100 question

kschewe, 2024-11-16:
I have the JP version of the ps1.  I am using the Arduino Nano.
 In you code i #define ARDUINO_328_BOARD
In the instructions it does not mention to wire to bios chip, it only mentioned the PAL version.  Is this correct?
I was not able to get it to work at the moment.  My other one i install mod chip and change the bios on the JP version

kalymos, 2024-11-16:
hi. if it is indeed a 100 then a Japanese one. this version of the mode does not work with it, look instead at version 8.5, which works with it, and which has a new documentation.

https://github.com/kalymos/PSNee_V8/tree/test2

kschewe, 2024-11-16:
Thanks for the response
I read the Doc on this one for the pu-41.  i will try and get back to you.
Thanks
________________________________
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

kschewe, 2024-11-17:
psnee v8.5 works on schp-100 JP version.  The 2 additional points needed be soldered tot he bios chip DX and AX.  8 wires in total.  I used the Arduino nano.  Using Arduino ide.  All i did was define atmega328 and define scph-100.  Programmed by usb com port.  Nothing else was required.

kalymos, 2024-11-17:
Does it work with region-free or burned games? If so, it's good.
but if you programmed it without ISP, the bootloader is still on the card, and it can cause a delay that prevents the bios patch.

kschewe, 2024-11-17:
I just tested and it worked on legit NA, JP and burnt game.  So far it loaded up all games with no issues.  I intend to install on a schp 1000 model soon.  I could try again with the other method since it seems to have no issues programming the nano when installed into ps1.
 I did not try the ISP way since it was first time using this software and Arduino.

kalymos, 2024-11-17:
I'm happy for you.
P.S. Sometimes using ISP can be a bit of a pain, to test I use a blink sketch.

ba114, 2025-02-15:
> hi. if it is indeed a 100 then a Japanese one. this version of the mode does not work with it, look instead at version 8.5, which works with it, and which has a new documentation.
>
> https://github.com/kalymos/PSNee_V8/tree/test2

Is the latest version you published here now fully compatible with SCPH-100?

kalymos, 2025-02-15:
Hello
Normally the mode is compatible with your console, taking into account that the Attiny are not compatible with the bios patches that are necessary for Japanese consoles, you are forced to use the ATmega.
Unfortunately as I do not have this console personally, and I do not have any feedback yet, I have not yet put it in the table as being guaranteed.
But even without the bios patch not being functional, you will still be able to make burned Japanese games work for me.

If you do I would be happy to have your feedback so that I can put this console table to test.

ba114, 2025-02-15:
> Hello Normally the mode is compatible with your console. For the BIOS patch to work you need to program with the ISP. I made a tutorial to be able to program with the ISP, https://github.com/kalymos/PsNee/wiki/Personal-recipe-to-make-a-good-PSNee Unfortunately as I do not have this console personally, and I do not have any feedback yet, I have not yet put it in the table as being guaranteed.
>
> If you do I would be happy to have your feedback so that I can put this console table.

Have just programmed a pro micro using my UNO R3. Will look into wiring it up tomorrow and see what happens

ba114, 2025-02-16:
installed today. im having trouble with the pinouts.

The wiring diagram here (https://github.com/kalymos/PsNee/wiki/PM%E2%80%9041-diagram) shows pins AX and DX labelled, which i have run to pins 2 and 4 respectively on my pro micro. Where is the AY pin on the motherboard and where doi wire reset to?

With it wired as is, i get "please insert a PlayStation format disc" regardless of what disc is installed. I dont have a genuine NTSC-J disc to test with, but i assumed my PAL disc would show a region error rather than saying to insert a disc.

kalymos, 2025-02-16:
Your pike connection is correct, on the PM_41 we do not use the AY pin.
The bios patch seems suitable otherwise it would cause a black screen. (but it is not 100% guaranteed)
Was there a game in Japanese version in the burned CDs that you used, it also does not work it would seem to indicate a problem with the injection of the region code.
And using a normal music CD, can give you a unit of the state of the player.
You can use the LED run option, with this letter will light up just after the console starts to signal the injection of the bios patch, and a second time when reading the region zone. This will already give you an indication that the chip mode detects the moments when it must inject the code.
Feel free to use a multimeter in continuity mode to triple check if the wiring is correct, I always do this because I always get it wrong ;)

ba114, 2025-02-16:
> Your pike connection is correct, on the PM_41 we do not use the AY pin. The bios patch seems suitable otherwise it would cause a black screen. (but it is not 100% guaranteed) Was there a game in Japanese version in the burned CDs that you used, it also does not work it would seem to indicate a problem with the injection of the region code. And using a normal music CD, can give you a unit of the state of the player. You can use the LED run option, with this letter will light up just after the console starts to signal the injection of the bios patch, and a second time when reading the region zone. This will already give you an indication that the chip mode detects the moments when it must inject the code. Feel free to use a multimeter in continuity mode to triple check if the wiring is correct, I always do this because I always get it wrong ;)

Tried with Japanese burnt cd and get the same error.
Wiring was double checked with multimeter for continuity and all good there.

Can hear the laser on the drive trying to adjust to read the discs but end result is the same on all discs I try.

The red led on the arduino is always on, I don't seen any other activity. I'll enable the led run code and try again to see what happens.

kschewe, 2025-02-16:
I was successful on mine.  I tested JP NA legit and burnt game.  I am using a different chip though and that might be the difference.  I did not get around to try on the 1000 JP model i have yet.  I was going to investigate burning it to a single chip instead of these little boards for more room.
________________________________
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

kalymos, 2025-02-16:
It's good that you succeeded, I could just know the detail, what was the Arduino board, the console number, and the motherboard number.

This is to complete the success table

ba114, 2025-02-16:
should i be usings v8 or v8.5.2?

kalymos, 2025-02-16:
v8.5.2

ba114, 2025-02-16:
> v8.5.2

yep thats what im using...

kschewe, 2025-02-16:
here are are few pics.

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

ba114, 2025-02-16:
Ok all working now. exported the compiled HEX and reflashed using avrdudess setting the fuses in there.
Tested with Jap and NA burned discs and original PAL discs. All loaded fine.

kalymos, 2025-02-17:
Good that it works, but ultimately it was an injection problem.

kalymos, 2025-02-18:
one last thing i could have the command line you used for arvdude

ba114, 2025-02-18:
> one last thing i could have the command line you used for arvdude

i used avrdudess gui for it

ba114, 2025-02-26:
> one last thing i could have the command line you used for arvdude

avrdude.exe -c avrisp -p m32u4 -P COM7 -b 19200 -U flash:w:"C:\Users\xxxxx\OneDrive\Documents\Arduino\Projects\PSNee_V8.5\build\PSNeecore.avr.32u4\PSNee_V8.5.ino.hex":a -U lfuse:w:0xFF:m -U hfuse:w:0xDF:m -U efuse:w:0xFF:m

Closed 2025-03-19.

Thread 60 (2024-12-08):

PM-41 PAL problem

impy101, 2024-12-08:
I've spent the past 5 hours trying to get PSNee to work on my PAL PM-41 but nothing works. I've used Arduino Uno as a programmer and a FT232RL to program Arduino Nano's and Mini-Pro's and neither work. I definitely have everything wired correctly and I checked with a multimeter that everything is reading right. But the PSOne still refuses to read burned discs that my older PSX does read.

kalymos, 2024-12-08:
At first glance like this it's hard to tell. Did you compile and connect
correctly with the bios patch.

by the way I give you the link to the new version, with completely revised
documentation
https://github.com/kalymos/PSNee_V8/tree/test2

Le dim. 8 déc. 2024 à 01:05, impy101 ***@***.***> a écrit :

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

impy101, 2024-12-08:
> At first glance like this it's hard to tell. Did you compile and connect correctly with the bios patch. by the way I give you the link to the new version, with completely revised documentation https://github.com/kalymos/PSNee_V8/tree/test2 Le dim. 8 déc. 2024 à 01:05, impy101 ***@***.***> a écrit :
> […](#)
> I've spent the past 5 hours trying to get PSNee to work on my PAL PM-41 but nothing works. I've used Arduino Uno as a programmer and a FT232RL to program Arduino Nano's and Mini-Pro's and neither work. I definitely have everything wired correctly and I checked with a multimeter that everything is reading right. But the PSOne still refuses to read burned discs that my older PSX does read. — Reply to this email directly, view it on GitHub <#60>, or unsubscribe <https://github.com/notifications/unsubscribe-auth/ABDOKBEOHRW2SXOF2EBTUYL2EOEN7AVCNFSM6AAAAABTGVC252VHI2DSMVQWIX3LMV43ASLTON2WKOZSG4ZDIOBWGQ4DSOI> . You are receiving this because you are subscribed to this thread.Message ID: ***@***.***>

Same thing I'm afraid. I definitely compiled it properly and there's nothing wrong with my wiring.

My FT232RL to Pro-mini wiring: VCC - VCC, GND - GND, TX - RX, RX - TX, DTR - DTR. Board settings in arduino IDE are correct and for programmer I used Arduino as ISP and AVRISP MKII. Still nothing, all I get is my PSOne sees the discs as some kind of media with minutes etc.

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

kalymos, 2024-12-08:
you tested with a genuine disc from another region?

Le dim. 8 déc. 2024 à 11:26, impy101 ***@***.***> a écrit :

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

impy101, 2024-12-08:
> you tested with a genuine disc from another region? I'm not 100% sure, but it looks like the bios patch isn't working. Le dim. 8 déc. 2024 à 11:26, impy101 ***@***.***> a écrit :
> […](#)
> At first glance like this it's hard to tell. Did you compile and connect correctly with the bios patch. by the way I give you the link to the new version, with completely revised documentation https://github.com/kalymos/PSNee_V8/tree/test2 Le dim. 8 déc. 2024 à 01:05, impy101 *@*. *> a écrit : … <#m_227642057732138511_> I've spent the past 5 hours trying to get PSNee to work on my PAL PM-41 but nothing works. I've used Arduino Uno as a programmer and a FT232RL to program Arduino Nano's and Mini-Pro's and neither work. I definitely have everything wired correctly and I checked with a multimeter that everything is reading right. But the PSOne still refuses to read burned discs that my older PSX does read. — Reply to this email directly, view it on GitHub <#60 <#60>>, or unsubscribe https://github.com/notifications/unsubscribe-auth/ABDOKBEOHRW2SXOF2EBTUYL2EOEN7AVCNFSM6AAAAABTGVC252VHI2DSMVQWIX3LMV43ASLTON2WKOZSG4ZDIOBWGQ4DSOI <https://github.com/notifications/unsubscribe-auth/ABDOKBEOHRW2SXOF2EBTUYL2EOEN7AVCNFSM6AAAAABTGVC252VHI2DSMVQWIX3LMV43ASLTON2WKOZSG4ZDIOBWGQ4DSOI> . You are receiving this because you are subscribed to this thread.Message ID: @.*> Same thing I'm afraid. I definitely compiled it properly and there's nothing wrong with my wiring. My FT232RL to Pro-mini wiring: VCC - VCC, GND - GND, TX - RX, RX - TX, DTR - DTR. Board settings in arduino IDE are correct and for programmer I used Arduino as ISP and AVRISP MKII. Still nothing, all I get is my PSOne sees the discs as some kind of media with minutes etc. Screenshot.2024-12-08.112316.png (view on web) <https://github.com/user-attachments/assets/299df03a-6cc9-4c74-8297-d0c320f297fb> — Reply to this email directly, view it on GitHub <[#60 (comment)](https://github.com/kalymos/PsNee/issues/60#issuecomment-2525578273)>, or unsubscribe <https://github.com/notifications/unsubscribe-auth/ABDOKBEAAJP3YN6FPSWZAST2EQNGBAVCNFSM6AAAAABTGVC252VHI2DSMVQWIX3LMV43OSLTON2WKQ3PNVWWK3TUHMZDKMRVGU3TQMRXGM> . You are receiving this because you commented.Message ID: ***@***.***>

I don't have a genuine disc from another region unfortunately. However, I noticed in the guide that I should be uploading the code with sketch -> upload using programmer. I tried that several times, but I just get: avrdude: stk500_recv(): programmer is not responding

However, when I upload "normally" using Arduino ISP it does succesfully upload.

kalymos, 2024-12-08:
The recipe I use is really specific, and must be followed step by step.
But if your ISP method works, use it.
I'm not 100% sure, but it looks like the bios patch isn't working.

P.S. Little extra tip, used the LED_RUN option, it told you if the region code is sent

kalymos, 2024-12-08:
P.P.S Injection with Arduino ISP is always a bit tricky, personally I always test first with the blink sketch ;)

Thread 63 (2025-02-09):

Black screen on SCPH-1000 with 1.1j BIOS

notsocafe, 2025-02-09:
(I am aware that GitHub issues are not the best way to discuss this, but I've yet to find any other trustworthy online exchange about this)

I tried to build a PsNee for my SCPH-1000 out of an Arduino Nano clone (Whadda WPB102), but the console no longer boots when BIOS patching is plugged in.

Arduino has defines Atmega328_168 & SCPH_3000 uncommented, flashing is done through ArduinoISP via a proxy Uno.

When everything besides BIOS lines are plugged in, the console works fine, but does not read any other region disc.
When BIOS lines are plugged in the Arduino, TV reports AV/RGB signal going through, but it's only black screen. No reaction from CD drive.

All connections are OK through continuity testing, although non-BIOS lines are using longer cables.

Is there a bug, or something to investigate?
I can probably try shorter cables, but do you have any tips on how to fit connections through the case?

(Available for discussion in French if needed.)

kalymos, 2025-02-09:
I feel less alone, I just received a SCPH-1000 and I have the same problem,
today.
indeed like you I think that it comes from a problem with the injection of
the bios patch, the problem is that the Russians who made the bios patches
did not comment on their work at all, I will have to recheck the wiring.
unfortunately if it is the code that is messed up I can't do much.
a priori if you have already installed some that worked, it is because your
cables must not be too long. on all the ones that I have I have the cables
that come out of the box with harnesses, to be able to test the different
chipsets.
je parle aussi français, mais pour la réponse cela donnait en anglais si
des gens avaient le même souci

Le dim. 9 févr. 2025 à 23:43, cafe ***@***.***> a écrit :

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

notsocafe, 2025-02-16:
I can confirm that the modchip works with the correct BIOS diagram.
Thank you for the hard work.
Maybe we'd need to update the comments in the .ino to match the IC102 pinout.

kalymos, 2025-02-16:
the information in the .ino is correct it was the diagram that was wrong

just one more thing, could you tell me again on which machine you managed to install the mode, giving me the console number, the motherboard number, and which Arduino board you used.

ba114, 2025-03-26:
I just installed on SCPH-1000 (40 pin bios) as well. Anduino Pro Mini (5v16MHz),  Uncommented #define SCPH_1000.

Boots original Jap and Backup discs but doesnt boot original or backup games from other regions.
Followed the BIOS pin pictures from the wiki and the pinout diagram for pro mini.

kalymos, 2025-03-26:
What method did you use to inject the code into the pro mini?

ba114, 2025-03-26:
> What method did you use to inject the code into the pro mini?

Exported compiled code and flashed using USBasp in AVRDUDESS. Fuses were set per wiki.

kalymos, 2025-03-26:
I'm not really familiar with this injection method, but it should work so you can play Japanese copy discs.
To be sure of the bios version, the bios dumper disk will give you the references that correspond to the one in the code.
https://github.com/kalymos/PsNee/wiki/Just-what-you-need-to-know-to-know-your-BIOS-with-BIOS-Dumper-2.6.
After that the last thing on my mind is a problem with the connections.

ba114, 2025-03-26:
> I'm not really familiar with this injection method, but it should work so you can play Japanese copy discs. To be sure of the bios version, the bios dumper disk will give you the references that correspond to the one in the code. https://github.com/kalymos/PsNee/wiki/Just-what-you-need-to-know-to-know-your-BIOS-with-BIOS-Dumper-2.6. After that the last thing on my mind is a problem with the connections.

Yes it works with NTSC-J copy discs. Just doesnt work with NTSC-U or PAL (original or copy)

Closed 2025-02-16.

Thread 66 (2025-02-13):

Attiny45 and UNO as ISP -- Upload error:  avrdude: invalid byte value ({upload.low_fuses}) specified for immediate mode

ivancosta, 2025-02-13:
I'm programming an Attiny45 through an Arduino Uno as ISP and ARDUINO IDE and I get this error when trying to upload using the programmer:

In the Wiki and in the instructions PDF it's mentioned that settings have to be made in the fuses, but NO fuses options are visible in the IDE.

I'm using the method of copying the PSNeecore folder at the arduino15/packages/ directory.

What am I doing wrong?

Console log:

```
Sketch uses 844 bytes (20%) of program storage space. Maximum is 4096 bytes.
Global variables use 30 bytes (11%) of dynamic memory, leaving 226 bytes for local variables. Maximum is 256 bytes.
avrdude: invalid byte value ({upload.low_fuses}) specified for immediate mode
avrdude: read from file '{upload.low_fuses}' failed
Failed programming: uploading error: exit status 1
```

kalymos, 2025-02-13:
Thanks for the feedback
I think I found where the bug is, I'll have to check tomorrow.

And it's normal that you can't find the fuse option for the Attiny, since we can't use them with the bios patch.

kalymos, 2025-02-13:
In the meantime you can use one of the standard Attiny libraries, it won't change much in the recipe

ivancosta, 2025-02-13:
When you say "libraries" you mean a board manager, like https://github.com/damellis/attiny ?

kalymos, 2025-02-13:
If you are here, I have fixed the bug, the problem is that I don't have an ATTiny at hand at the moment.
Could you test it for me?
If yes I have uploaded a new PSNeecore file, just replace it in your folder.

ivancosta, 2025-02-15:
I've tested and the bug is fixed

kalymos, 2025-02-15:
Thank you very much for your reply.

Can I still ask you something?
What is the console number where you installed the mod, the motherboard number, and the ATtiny you used?

ivancosta, 2025-02-15:
I'm trying to mod a 7001, motherboard PU-20 with Attiny45.

Flashed the Attiny, soldered and it's not functioning.

In the .ino sketch I've **uncommented** these 2 lines only:
` #define ATtiny85_45_25`
and
`#define SCPH_xxx1`

The wires I'm using are not super short, they are like 7cm.
I am missing something?

kalymos, 2025-02-15:
It's not the length of the cables, on my test machines more than 20 cm.
If the programming by ISP went well, the first thing I suspect even at home is to have soldered the cables in the right order and in the right place, you can send me pictures of the soldering on the motherboard.

I personally did tests on the 7002 pu-20 version.

ivancosta, 2025-02-15:
Here are my soldering points

This board came to me having a modchip already installed and it was not working either.

But the console runs backup disks normally with softmod FreePsxBoot/Unirom

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

kalymos, 2025-02-15:
At a glance on the welds I see one or two small problems, the part where you removed the cable sheath is a little long, generally I arrange it so that it is between 1 and 2 mm.

And the soldering of the SUBQ and the wfck are not very beautiful.

Personally to have good welds first on the point where I want to mess up I add a little solder, I expose the cable, I put a little solder on the end of the cable, and if necessary I shorten it, then I follow the cable and the point.

And finally I check if I have no false contact with a multimeter.

One last thing, if it welds badly, add flux.

ivancosta, 2025-02-15:
Yeah, not proud of my soldering on that.
I redid those and it still do not work.

Monday I will try flashing the Uno, to tell if make any difference, maybe it is an issue with my board / OR the Attiny.
I have an old analog osciloscope at hand, too, to poke around.

PS: a have flashed a bootloader to the Attiny to test with the blink sketch, and it was ok.
Noobie question: bootloader flashed prior to PSNee, ok? not ok?

Thanks for the support!

kalymos, 2025-02-16:
It's good that you're trying to check that if you injected a sketch on the target, but at this stage a simple multimeter in continuity mode is sufficient to check if the welds are good, and that all the cables are in the right order.

ivancosta, 2025-02-17:
I've soldered a socket and tested with an Arduino Uno R3, it works fine. Put the Attiny back on, and it no longer works.

kalymos, 2025-02-18:
apparently there is a problem with injecting the code into the ATtiny, someone managed to solve the problem next door, using arvdude directly. I'll ask him for his command line

kalymos, 2025-03-14:
I'm glad it worked for you. I was a little worried I'd bricked your ATtiny with the wrong fuse settings.
If you've checked out the new wiki and its tutorial, what do you think?
Have a nice day!

ivancosta, 2025-03-14:
Well, I have bought new Attinys, the ones (2) I was using don't accept any programming anymore. I think they are bricked, but don't worry with that, your new updates came right in time when the new chips have arrived! Thanks again!
I

kalymos, 2025-03-14:
There are ways to recover, you can put a 16 MHz clock on the right pins (I made a mistake in setting the fuses and I tell them an external clock), you can reprogram them again via ISP, to change the fuses. Or use a more advanced programmer like the Chinese t48.

ivancosta, 2025-03-14:
I'll take a look at those later, with a 16Mhz crystal. Thanks for suggesting that.
The wiki is becoming more helpful!

I'm not an english native speaker, so pardon my past, present and future text errors :)

I noticed some errors in the text and suggest the following corrections at the top of the wiki page.

"MUC" → "MCU" (Assuming you meant "Microcontroller Unit").
"current supporters" → "currently supported"
"Not compatible with BIOS patch" → "Not compatible with the BIOS patch"

and so on...

kalymos, 2025-03-14:
Don't worry, let's just say English is my third language ;)
I looked at the schedules you mentioned.

Closed 2025-02-15.

Thread 67 (2025-02-15):

resolved

godmanpicoli, 2025-02-15:

kalymos, 2025-02-16:
just before you leave i could know if the installation was successful, what is the console number, motherboard number, and the arduino you used ?

Closed 2025-02-15.

Thread 68 (2025-02-19):

Difficulty installing on the Japanese SCPH 1000

godmanpicoli, 2025-02-19:
I have already checked the installation of the wires on the Arduino Nano and on the PS1 board. I cannot start games from another region without the PS screen changing colors. Some games freeze on the PS screen. However, I can run the CD-R with the PSX BIOS Dumper.
Japanese games work normally.

Arduino Nano 328PB Fuses: H: DF, L: EE, E: FF
PS1 SCPH_1000 PU7 BIOS ver. 1.1 CRC 3539DEF6 checked with PSX Bios Dumper

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

kalymos, 2025-02-19:
for european games it's normal that it doesn't work very well, the internal clock of japanese ps1 doesn't allow it.
there is a mode to change the clock, at the end of the first page of the wiki you have a link to this world

godmanpicoli, 2025-02-19:
I forgot to mention that I used American games, even with American games do I need to change the PS1's internal clock?

kalymos, 2025-02-19:
https://github.com/L10N37/PSXTAL if it's a PU-7 I'm not sure it works.

godmanpicoli, 2025-02-20:
> https://github.com/L10N37/PSXTAL se for um PU-7, não tenho certeza se funciona.

For American games, is it necessary to change the internal clock?

kalymos, 2025-02-20:
Sorry I have never used this mod, I am primarily concerned with psnee. but I think I have already heard of this problem, only I do not remember in which forum, maybe psxdev

godmanpicoli, 2025-02-22:
> Sorry I have never used this mod, I am primarily concerned with psnee. but I think I have already heard of this problem, only I do not remember in which forum, maybe psxdev

I replaced the Arduino Nano 328PB with an Arduino Pro Mini 328P and it worked normally.

kalymos, 2025-02-22:
Glad it works for you, but I thought the only difference between these two was the package.
I absolutely have to do a global test campaign again.
by the way thanks for the screenshots it helped me understand what is used to detect the BIOS.

ba114, 2025-03-27:
> > Sorry I have never used this mod, I am primarily concerned with psnee. but I think I have already heard of this problem, only I do not remember in which forum, maybe psxdev
>
> I replaced the Arduino Nano 328PB with an Arduino Pro Mini 328P and it worked normally.

Are you saying that switching to the pro mini 328P with no other changes now allows you to play PAL and NTSC-U games on your SCPH-1000?

I have the 40-pin bios SCPH-1000 with pro mini 328PB and it only plays NTSC-J discs + backups. No other regions.

Is yours pro mini a 5v 16MHz model or 3.3v 8MHz model?

kalymos, 2025-03-28:
I just received 328PB cards yesterday, and they work fine, moreover if you look on the first page you will see that I have updated the table of tests that I have done.
For ATmega cards, a 16MHz crystal is essential.

ba114, 2025-03-28:
> I just received 328PB cards yesterday, and they work fine, moreover if you look on the first page you will see that I have updated the table of tests that I have done. For ATmega cards, a 16MHz crystal is essential.

For scph-1000 40pin with PAL and NTSC-U?

kalymos, 2025-03-28:
Yes, I tested this combination yesterday morning. In fact, with that, I was able to update the table of tested combinations.
https://github.com/kalymos/PsNee/blob/master/images/test-PSNee-v8.6.png

If you want me to help you more, I need to.
The motherboard number.
The code injection technique you used.
 A photo of the solder joints on the BIOS.

ba114, 2025-03-28:
Think I killed my ps1 anyway by being lazy and trying to flash my pro mini
without disconnecting from the ps1

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

kalymos, 2025-03-28:
Unfortunately, this is one of the biggest risks, especially on older models. If you want to start again with another one, choose the later models, SCPH-700x-7500x-900x-10x, they are much more robust, and the drive is of better quality.
At first I made the same mistake, luckily it was on a SCPH-102 model, which held up.

Closed 2025-03-19.

Thread 71 (2025-03-15):

PSNeecore-1.2 folder goes where?

nex86, 2025-03-15:
Where exactly do I put this folder?
documentation mentions "arduino/hardware/" but where exactly?

I found C:\Users\nexxu\AppData\Local\Arduino15\packages\arduino\hardware\avr\1.8.6
has these files, but do I replace them?

I'm an absolute noob with Arduino IDE.

kalymos, 2025-03-15:
When you install the Arduino IDE, you'll normally see the Arduino folder in your home directory, where you'll find a Sketch folder where your programs are saved by default. This is the folder.

nex86, 2025-03-15:
The folder in documents?
There is a library folder and a MAX30100_adafruitio  folder

nex86, 2025-03-15:
Okay.. I now put it in
Documents\Arduino\hardware\PSNeecore-1.2\avr

kalymos, 2025-03-15:
Yes something like that, and normally the next time you open Arduino IDE it should appear in Tools -> Board

kalymos, 2025-03-15:
P.S. The other path is possible, but it's more complicated to explain.
P.P.S. Once you've successfully installed your application, you can answer the short questionnaire in the discussion section.
Have fun!

nex86, 2025-03-15:
Ok got this but now I have more issues.

its getting me "request upload failed"
when compiling and uploading the sketch.
I have an Arduino Micro 32U4

kalymos, 2025-03-15:
Are you at step 4 ?

nex86, 2025-03-15:
yes but tools -> varient is also something that is not listed on there.

kalymos, 2025-03-15:
Tools -> Processor -> your MCU varient for the modchip
It's corrected, excuse me.

nex86, 2025-03-15:
Ok so I picked:

Board: PSNEE->ATMEGA32u4
Port: COM6 (Arduino Micro / ATMEGA32u4
Programmer: Arduino as ISP (ATMEGA32u4)

when I know upload the sketch it keeps on "uploading.."
and the LED on the Arduino is blinking.
How long is it supposed to take?

kalymos, 2025-03-15:
Not long, normally the program tells you when it's finished injecting.
Oh yeah, that's right, your target doesn't have the blink LED itself.
Don't worry, I'm interested in hearing about your problems; it lets me know what mistakes I've made.

kalymos, 2025-03-15:
I edited this, I hope it's understandable.

For ATtiny, and ATmega32U4 diagram, and modify the Blink sketch accordingly

    ATtiny LED_BUILTIN -> PIN 3
    ATmega32U4 LED_BUILTIN -> PIN 10

nex86, 2025-03-15:
I tried it with original Arduino Micro and Pro Micro that has the USB-C , but both behave the same.

I'm no sure if I'm doing this wrong here.
Do I need two Arduinos to program one?
from my Understandig, it is only required when the microcontroller does not have a programmer by its own.
But my Micros do have a programmer.

kalymos, 2025-03-15:
I see, yes to program in ISP you need two cards, the first which becomes the ISP programmer, and the second which will be your target.

kalymos, 2025-03-15:
If you don't need the bios patch, you can just use USB injection

nex86, 2025-03-15:
According to the guide, SCPH 9002, does not need bios patching. but correct me if I'm wrong.
USB injection does not seem to work. or do I need to change anything?

kalymos, 2025-03-15:
Give me half an hour to check if the USB injection works properly. I stopped using it for my tests.
PS: I still have to tweak the ISP injection tutorial a little. In the meantime, if you find anything you don't understand, let me know.

nex86, 2025-03-15:
I tried to inject with my Arduino Uno, connected it as said in the diagram but when I go on "upload using a programmer" it says "failed."

kalymos, 2025-03-15:
USB injection works very well for me.
What compilation options do you have comments in the sketch?

Normally when you have installed a chip on your console and it works at least partially with the LED_RUN option, the letter that flashes with the blink sketch will light up with each injection of the region code.

nex86, 2025-03-15:
It looks like I can not upload anything as usual anymore.
The Arduino Micro disconnects itself just before uploading.
It did the ISP Gateway method with my Uno, and USB uploading broke after this.

kalymos, 2025-03-15:
It's not exactly a great idea.
It could be that the boards you have are no longer working properly, have lost their bootloader, or that the fuses are no longer working properly.
There's a fairly simple solution for this: reinstalling a bootloader using an ISP gateway.
In the tutorial, there's a link that explains more about the intricacies of ISP gateways. https://docs.arduino.cc/built-in-examples/arduino-isp/ArduinoISP/

nex86, 2025-03-15:
I ended up using the Micro pro, and it works.
In case I have to update the firmware, what steps do I need to do?
Can I do this right while its connected to the motherboard of the PSX or do I have to desolder it?

Closed 2025-03-19.

Thread 73 (2025-03-23):

This happens when booting a game

1vers1on, 2025-03-23:
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

kalymos, 2025-03-23:
Hello,
Could I have some information?
What is the console version?
What is the motherboard number?
What is the ATmega version?
Which lines did you uncheck for compilation?
Is it with its bugs before the mode?
And finally, could I have a photo of the soldering?

Closed 2025-05-09.

Thread 74 (2025-03-24):

NTSC-J 7000 memory card

Nightalex77, 2025-03-24:
The new version does not solve the problem with the memory card manager on the 7000 model NTSC-J? When trying to log in, the console freezes and reboots after 30-40 seconds.

kalymos, 2025-03-24:
Good morning,
If you are using v8, in principle the behavior is the same.
We will have to do some tests to confirm this.

Nightalex77, 2025-04-09:
Try entering the memory card menu without a game disc.

kalymos, 2025-04-12:
I took the time to do some tests.

What I've personally noticed with the current version is that PlayStations with BIOS version 4.0j are indeed unable to load memory cards. And it's possible that this could cause your system to crash.

All other versions I've tested don't have this problem.

The solution I see at the moment is to uncomment the #definePATCH_SWICHE option and install a switch like the diagram you'll find in the wiki.
With this solution, you'll be able to handle memory cards by disabling the BIOS patch.

Sylph4, 2025-05-20:
Have the same issue on 7000 J model. Otherwise works ok.

kalymos, 2025-05-29:
I've debugged the #define PATCH_SWITCHE build option and updated the wiki diagram.

To resolve this memory card access issue, or simply disable the BIOS patch, simply undo #define PATCH_SWITCHE in the options section of the PSNee***.ino file and install a switch as shown in the PIN_SWITCH diagram available on the wiki.

thiagosepp-x, 2025-09-06:
So sad, today i have the same problem. No memory card manager and Cd Player resets the console. Maybe the future reveals a solution better than a Switch.

Thread 76 (2025-03-26):

The diagram for the PM-41 motherboard does not show a RESET point.

ohmitek, 2025-03-26:
I have a PSone model SCHP-102 PAL and it has a PM-41 motherboard. According to the instructions, the RESET point must also be connected, but I can't find one in the picture. I am using Arduino Nano.

"For models SCPH-101,SCPH-103, you can ignore the RESET. On the other hand, the model
SCPH-102and SCPH-100, you will have to use the RESET point, and the BIOS points.All of the
points are fairly easy to solder to"

ohmitek, 2025-03-26:
SCHP-102 PAL / PM-41 / Arduino Nano is working good!

SCHP-7502 PAL / PU-22 / Arduino Nano which I installed yesterday also works perfectly.

Thanks and kudos for your hard work.

Closed 2025-03-29.

Thread 78 (2025-03-31):

How do you upload via usb to a pro micro?

dazzaXx, 2025-03-31:
What board type is used for a pro micro? I tried the atmega32u4 option included with the core files but I kept getting a upload failed error. Thanks!

kalymos, 2025-03-31:
Hello,
I'd need a little context to answer your question.
Did you want to inject the code via USB or via ISP?
Is it possible to have a copy of the error message?
Perhaps also the serial number of your console and your motherboard?

kalymos, 2025-03-31:
Have you tried using PSNeecore?
Or is it the standard card manager?

What option did you choose (Tools -> Programmer ->)?

dazzaXx, 2025-03-31:
Hi, I'll close this as it seems it isn't a PsNee issue, it must be the PU-8 motherboard itself, I've tried even with a properly flashed Nano via ISP with no luck at all, compared to my PU-22 that works flawlessly with the nano.

kalymos, 2025-03-31:
Often on old consoles the CD player is a bit out of breath, for that on the PSNee side you can perhaps slightly increase the HYSTERESIS_MAX variable for example around 18-20, and slightly decrease the DELAY_BETWEEN_INJECTION delay. On the hardware side cleaning and lubricating with silicone grease the plastic friction parts of the player can be useful, if the motor makes a nasty noise during rotation speed changes a drop of oil in it or WD-40 can raise it from the dead.

dazzaXx, 2025-04-07:
> Often on old consoles the CD player is a bit out of breath, for that on the PSNee side you can perhaps slightly increase the HYSTERESIS_MAX variable for example around 18-20, and slightly decrease the DELAY_BETWEEN_INJECTION delay. On the hardware side cleaning and lubricating with silicone grease the plastic friction parts of the player can be useful, if the motor makes a nasty noise during rotation speed changes a drop of oil in it or WD-40 can raise it from the dead.

Thank you for the tips! I've got some spare nanos, their usb chips must be bad but they still function as they should with the blink test flashed via an ISP. I'll give what you suggested a go and see if I can get it working. Thank you!

kalymos, 2025-04-07:
Regarding the HYSTERESIS_MAX variable, I updated the project by increasing it to 17. I've been running some tests on it over the past few days, and I've also updated the comments for this variable.
As for the DELAY_BETWEEN_INJECTION variable, I don't think there's any point in modifying it.
And finally, for cleaning, the WD isn't the best option; I'd need to write a complete tutorial for that.

dazzaXx, 2025-04-07:
> Regarding the HYSTERESIS_MAX variable, I updated the project by increasing it to 17. I've been running some tests on it over the past few days, and I've also updated the comments for this variable. As for the DELAY_BETWEEN_INJECTION variable, I don't think there's any point in modifying it. And finally, for cleaning, the WD isn't the best option; I'd need to write a complete tutorial for that. P.S. about the blink test in ISP, I do it because arvdue even if it tells you that it injected correctly, in reality it does not know it, it only knows that it was able to transmit the program to the ISP gateway, the only way to see if it goes well is to see a program running on the target.

Ok thank you, I'll download the latest version of PsNee, I did the blink test on both nanos with bad usb chips and they both ran the blink test fine, I'm planning on removing the usb port anyway to make the pcb not as tall, since it also doesn't work as well.

kalymos, 2025-04-07:
By the way, a little thing about the nanos that have problems with USB, it could be that they no longer have a bootloader, but we can reinject it with the ISP in the Arduino IDE.
Tool >> Burn bootloader

dazzaXx, 2025-04-07:
Update, I've tested several arduinos with this PU-8 board, but it seems at least some connection is wrong or non functioning, I have noticed that the LED that lights up when injecting doesn't light up at all. Only when the board has power.

Thread 79 (2025-04-07):

PU-8 E35D SUBQ Pin the same as a PU-7?

dazzaXx, 2025-04-07:
Hi, me again. I figured out the issue with my PU-8 board with the big chip. It's setup like the PU-7, with the SUBQ being the pin above the one shown in the PU-8 diagram.

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

kalymos, 2025-04-07:
Thanks for the info.
Is it more like this?
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

kalymos, 2025-04-07:
I think I don't have this variant, can you tell me a good point for the reset?

dazzaXx, 2025-04-07:
> I think I don't have this variant, can you tell me a good point for the reset?

How would I go about finding this? My PU-8 Board is from a SCPH-1002.

Also that diagram is correct, yes.

dazzaXx, 2025-04-07:
To confirm my wiring:

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

kalymos, 2025-04-07:
I think it's the same as the other variant of the PU la-8.
To check, you need a multimeter. Put it in continuity mode, one probe on the GNT and the other on the RESET. If continuity is present when you press the hood closing switch, that's the correct point.

dazzaXx, 2025-04-07:
> I think it's the same as the other variant of the PU la-8. To check, you need a multimeter. Put it in continuity mode, one probe on the GNT and the other on the RESET. If continuity is present when you press the hood closing switch, that's the correct point.

I'll have a look and report back

dazzaXx, 2025-04-07:
Hmm, I can't seem to find it. I've tested a few points in and around the area but I've got nothing from them

kalymos, 2025-04-07:
Sorry for the reset, it's connected to the top pin of the power connector.
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

kalymos, 2025-04-07:
Thanks again, I will update the diagram.

kalymos, 2025-04-07:
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

dazzaXx, 2025-04-07:
> 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

Awesome, that's it. Glad to have helped 🙂 I'll close this issue now, thanks again!

Closed 2025-04-07.

Thread 80 (2025-04-17):

Hit or miss booting NTSC backups on SCPH-102

RutgerKroeze, 2025-04-17:
I have installed version 8.6 on a Pro Mini and soldered the chip in my SCPH-102. The console boots PAL backups fine, 100% success rate. But NTSC backups are very dodgy: less than 25% success rate. When it fails to boot, the console shows the main BIOS screen and the CD-reader spins up, then spins down, spins up, spins down etc. I verified the backups work fine in another chipped PS1.

At first I thought it was because of the wire length in my install, I placed the Pro Mini in the upper right corner of the board.
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

So I've relocated the chip to the left of the Alliance branded DRAM chip on the board and switched from solid core 28AWG Kynar wire to stranded 28AWG silicone wire. Power wires are thicker, not sure this is necessary.
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

But the behavior is exactly the same. Any ideas what can cause this? Could the BIOS patch be the culprit?

kalymos, 2025-04-17:
I've never encountered this particular problem, but we'll see what we can do.

One thing is certain, it's not the length of the cables. On my test models, I have harnesses with 20 cm cables to have a connection harness outside the console, and there is no problem.

I thought for a moment that it might be the player, but since the European copy disc plays fine, it must not be that.(Note that it's never a bad thing to give them a service. On plastics, use only silicone grease.)

Did you inject the code via ISP?
If you injected into iSP, what method did you use?
What is the reference of the ATmega 128/328 P/PA/PB?

RutgerKroeze, 2025-04-17:
I've already serviced the CD unit. Cleaned the lens with IPA, cleaned and regreased the rails. It's less noisy now and there's no FMV stutter, even with (PAL) backups. When NTSC backups boot, they run fine as well. So it definitely seems to be related to the modchip.

I used an Arduino Uno with the Arduino as ISP sketch to inject the code. That seemed to go well.

The chip on the Pro Mini (from AliExpress, so a clone?) reads MEGA328P.

Hope we can find something out! If I remember correctly, I started out with postal2201's PSNee V8 repo on the first attempt. Your repo was still at V7 back then. I've reinstalled the code from this repo last week, no difference.

kalymos, 2025-04-17:
There is one last thing that may possibly have an influence, it is the fuses of the ATmega, how did you put them? (personally I use this variation H: DF, L: EE, E: FD)

RutgerKroeze, 2025-04-17:
I didn't do anything to the fuses when I updated to V8.6 from this repo. Previously I had set it to H: DF, L: FF, E: FF, as instructed by postal2201's repo. I think..

What's the best method to verify this? Would it help to set the fuses to your suggestion?

kalymos, 2025-04-17:
Maybe. Look in the wiki, I explain my method with the project's board manager, which sets the fuses automatically.

https://github.com/kalymos/PsNee/wiki/Personal-recipe-to-make-a-good-PSNee

RutgerKroeze, 2025-04-17:
The fuses must be correct then because I followed those steps from the wiki! So installing the PSNeeCore file and selecting the target MCU via PSNeeCore takes care of the fuses?

I will double check those settings and reprogram the Pro Mini, just in case. Guess I just have to disconnect the VCC wire between the modchip and PS1 to avoid injecting 5V into the PS1 board? The Pro Mini is a 16MHz 5V variant, does that matter anything?

RutgerKroeze, 2025-04-20:
I've uploaded the latest version with HYSTERIS_MAX parameter at 17, makes no difference. I think it's related to the BIOS patch for SCPH-102. The purpose of this patch is to bypass the additional region locks in the BIOS, right? Given that PAL backups boot consistently, while NTSC disks almost never boot..

The BIOS patch has changed since V8, correct? Up until V7 the PAL PSone BIOS patch seems to be the exact same patch as implemented in the old ONEchip, at least it uses the same pins. Shall I try the V7 branch to see if it makes a difference? Of course there could be something wrong with my Arduino as well..

kalymos, 2025-04-20:
I haven't done any advanced testing with this patch version to see if it's necessary to pass both PAL games, specifically on this console model. Since I have the same one and it works fine for me.
But from memory, even PAL games won't pass without the bios patch.
Always try version V7, because as you assume, the biopatch doesn't work the same way on version V8.
Let me know if it works for you, if it works I'll see if I can make a legacy bios patch.
V7 is categorized into project branches.

RutgerKroeze, 2025-04-21:
I've uploaded the V7 branch and changed the two BIOS pins. Working very well now! I can see that the BIOS stays in NTSC443 mode on my upscaler. I've tried multiple backups, both PAL and NTSC and all of them boot fine, 100% success rate. Only a few times after power off and power on again, the BIOS switches into PAL mode when the white Sony logo appears, indicating the BIOS patch failed. My guess is the BIOS patch works 90% of the time, but it could also be that I'm powering on too quickly after power off.

Maybe there's something wrong with my Pro Mini, maybe it's my particular console, maybe it's both. But fact is that the 'old' NTSC BIOS patch from V7 is working much better for me. I'll stay on this branch because I don't need any of the added features of V8+ and I'm not using the portable PAL screen.

Thanks for your help and feedback!

kalymos, 2025-04-21:
Thanks for the feedback.
I'll see what I can do to integrate this version of the patch.

Closed 2025-04-21.

Thread 81 (2025-04-21):

Game Discs Stop Working After Console Reset on PU-7, 1.1j

Raz0r029, 2025-04-21:
I recently flashed version 8.6.2 onto an Arduino Nano and installed it in my PU-7 1.1J BIOS SCPH-3500 console. While all backup and original game discs from any region work without issues, when I reset the console, it fails to read the disc and just returns to the main menu. I still have to power cycle the console just to read game discs again. This problem happens only with NTSC-U and PAL discs, while NTSC-J discs load fine even resetting the console. Is this normal, or could it be a bug?

kalymos, 2025-04-21:
This strongly resembles a small problem with the reset line, which is desynchronizing the BIOS patch.
First possibility: there's a problem with your RESET cable; check the solder joints and the solder point.
Second possibility: the voltage levels that trigger the reset are too different between the PlayStation and the Arduino board. In these cases, pressing and (holding) the reset button can have a positive effect.

Raz0r029, 2025-04-21:
I replaced the reset cable and resoldered it properly, but the problem still remains. Holding the reset button for 5–10 seconds didn’t help either. I even tried to solder the reset cable directly to pin 7 on the PSU, but it made no difference.

kalymos, 2025-04-21:
If you can read copied discs, it is because you have normally compiled with this option #define SCPH_3000 ?
I'm going to do some tests on a console with the same bios.

Raz0r029, 2025-04-21:
Yes, I used #define SCPH_3000 instead of #define SCPH_3500_5000 because the latter is meant for the 2.1J BIOS, while mine is a 1.1J.

kalymos, 2025-04-21:
I must admit I don't know where this is coming from. I tested it on my hardware and I can't reproduce this bug.
When you have problems with the timing of the biopatch injection, most of the time the console won't start.
I'm currently testing version 8.7; it has some optimizations for region code injection. You can try it out if you want (I tested it on a PU-7 1.1j console), but I can't guarantee that this will fix your console's problem.

Raz0r029, 2025-04-21:
I see. I suppose I can try version 8.7 and see if that fixes the problem. Also, if I use an ISP programmer to flash the chip while it's still on the motherboard, do I need to desolder all the wires first, or can I connect the programmer without removing them?

kalymos, 2025-04-21:
Theoretically, it's better to bury the unsoldered terminals, but at the very least, solder the VCC. For ISP injection, if you use my card manager, there's no problem with the fuses. If you use another solution, remember to configure the fuses.

kalymos, 2025-04-22:
Thanks for reporting that you finally managed to do something.
For v8.7, it's mostly minor optimizations, and an older bios patch that works better for certain conditions for the 102s. I'm at the stage "coups de savate pour faire rentrer toute le tout"

Closed 2025-04-23.

Thread 83 (2025-05-08):

PSOne will not read burned discs

impy101, 2025-05-08:
I have tried several modchips, such as Mini pro and Nano, but none of them allow me to play burned discs on my PSOne (PM-41 PAL). I followed the guide to the letter, programmed all chips using uno as programmer and the blink program worked fine. So at least that part should be solid.

I checked the wiring 4 times and that, too, seems to be spot-on. I just get a screen that shows minutes, but it will not read.

Any help would be much appreciated.

kalymos, 2025-05-09:
We'll see what we can do.
If I understand correctly, your console is a SCPH_102.
But to move forward, I need some additional information: whether you followed the guide for injection via USB or via iSP.
And which option did you uncomment in the .ino file?
Does the Arduino LED flash like in the gif in the tutorial you followed?

impy101, 2025-05-09:
> We'll see what we can do. If I understand correctly, your console is a SCPH_102. But to move forward, I need some additional information: whether you followed the guide for injection via USB or via iSP. And which option did you uncomment in the .ino file? Does the Arduino LED flash like in the gif in the tutorial you followed?

I injected the code via ISP and I did flash the blink code to see if it worked and yes it did.

I uncommented: #define ATmega328_168  and #define SCPH_102

kalymos, 2025-05-09:
What I wanted to know about the blinking LED, once the mode is installed in the console and you test a disc does the LED react like the gif at the end of the tutorial?

P.S. The boards you tested on currently no longer have a bootloader, you can reinstall them via ISP in the Arduino.

impy101, 2025-05-09:
> What I wanted to know about the blinking LED, once the mode is installed in the console and you test a disc does the LED react like the gif at the end of the tutorial?
>
> P.S. The boards you tested on currently no longer have a bootloader, you can reinstall them via ISP in the Arduino.

I currently have a Mini pro installed and there are 2 solid red lights. No blinking when a burned disc is spinning up.

kalymos, 2025-05-09:
This suggests that the BIOS patch isn't receiving the correct triggers and is stuck.
It's possible to have a photo of your setup so you can see the connections and soldering.
Basically, PSNee has two phases of operation.
The first phase observes a memory address pin AX to determine when to modify a BIOS bit by operating on one of the BIOS memory data output pins DX. In this state, the LED remains lit until the triggers are reached.
The second phase reads the data stream between the CD controller and the processor to inject the region code. In this phase, the LED only lights up during the injection.
In other words, there may be a bad connection between the BIOS address input and pin 2 of the Arduino.

impy101, 2025-05-09:
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

Here you go

kalymos, 2025-05-09:
I think I found a problem, the wire you connected to pin 3 of your Arduino, should be connected to pin 2.

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

kalymos, 2025-05-09:
We've made a little progress, which is already good.
So now, when you play a burned CD, which screen do you arrive at? The PlayStation menu, the warning that it's not a genuine disc, or the region confirmation screen (PlayStation logo on a black background)?
Does it flash constantly now, or only three or four times?

kalymos, 2025-05-09:
And I just thought of two other things, does it have a 16mHz crystal, it seems to me that this pin is badly soldered.

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

impy101, 2025-05-09:
> We've made a little progress, which is already good. So now, when you play a burned CD, which screen do you arrive at? The PlayStation menu, the warning that it's not a genuine disc, or the region confirmation screen (PlayStation logo on a black background)? Does it flash constantly now, or only three or four times?
>
> P.S. The soldering of the data seems a little weak to me. and I can't see the SUBQ SQCK soldering

I've touched up the data point. Solid connection to the capacitor now. However, no change. In fact, after changing the wire to pin 2 it's become quite buggy. Sometimes I just get a black screen, other times I see the playstation screen in grey and when it does start up properly I just see either that screen with minutes on it or a red screen saying I need to put in a playstation disc (depends on which cd I put in)

impy101, 2025-05-09:
I've also counted the number if flashes and I've counted 7 flashes.

impy101, 2025-05-09:
Ive now got new problem where it starts up properly but boot loops on its own.

You know what, I'm going to remove the mini pro and put in a brand new nano and see what it does then.

kalymos, 2025-05-09:
If you plan on removing the board, check all the soldering on the PS carefully. It's not the easiest board to model.

impy101, 2025-05-09:
Put in a brand new Nano and now it works flawlessly... I guess not every arduino is created equal.

kalymos, 2025-05-09:
I've tried a lot of Chinese variations, and with this one, if there was a problem, it was me ;)

Closed 2025-05-09.

Thread 85 (2025-05-18):

If you want to post a message in this section, please read this message first.

kalymos, 2025-05-18:
If you want to post a message in this section, and you want me to be able to process it quickly, It would be very helpful if you could put this information in your message.

| Useful information                                                                      | For example |
| ------------------------------------------------------------------------------------|------------------------------------------------------|
|Console Reference                                                                        | SCPH_5503  |               
|Motherboard reference                                                               | PU-18 |
|MCU referance                                                                               | 328P - 16MHz |
|Injection method                                                                           |PSNeeCore - Arduino as ISP |
|The option you uncommented in the code                              | #define SCPH_1000  #define ATmega328_16|
|BIOS version                                                                                   | V3.0j, Only needed for older Japanese consoles |
| Basically how the LED flashes                                                    |It's like the gif at the end of the tutorial|
|A description of the problem encountered                               | You know what to mark here |
|And a photo of your installation                                                 | This is for my Japanese print collection ;)|

Thread 86 (2025-05-23):

Scph-9001 psnee install now causes the spindle motor to move rapily even when lid sensor is not pressed down

Genomans, 2025-05-23:
- <html><body>
<!--StartFragment-->
Console Reference | SCPH_9001
-- | --
Motherboard reference | PU-22
MCU referance | 328P - 16MHz
Injection method | PSNeeCore - Upload through USB
The option you uncommented in the code | #define SCPH_xxx1 #define SCPH_7000_9000
BIOS version | not sure
Basically how the LED flashes | solid red light on pow
A description of the problem encountered | I installed it wrong i thought it was like the 7v but with bios solder with it now the console won't read games and the spindle motor rapilly spins on startup even when lid is open
And a photo of your installation | 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

<!--EndFragment-->
</body>
</html>

kalymos, 2025-05-23:
First, you just need to uncomment #define SCPH_xxx1
And you can unsolder the D2, D3, and D4 cables, since American consoles don't need the BIOS patch.

kalymos, 2025-05-23:
Do you service the optical unit motors (WD40 does the job for this), and clean the old lubricant on the friction areas (replace with silicone grease)?

Genomans, 2025-05-23:
yes i did  service the motor and laser a relubed the plastic and cleaned the laser using iso alcohol i the laser reads some games back then now it does not after the install. I adjusted the pots and nothing still happends

kalymos, 2025-05-23:
Normally, there's no point in touching the potentiometer on the optical block (it's actually pretty crap).
Does the problem persist even when nothing is installed?

Genomans, 2025-05-23:
yes it does like a said in the start I desoldered it and the spindle motor still does that but after maybe a day or two it goes back too normal 2 spins lens lifting. but after leaving it on for maybe about 30 minutes the spindle acts up again and a have to wait another day or two just for it to go back to normal for 30 mins.

Genomans, 2025-05-23:
also another note this was been a thing since feb ever since your ver of psnee was public i just the time to report it now since a was busy with other projects. thats why i know that the spindle acts normal for a short while

Genomans, 2025-05-23:
no problem it just that this behavior is very unique and im just confused why this happened maybe its my botch soldering

Genomans, 2025-05-24:
will do

david4599, 2025-06-07:
> I installed it wrong i thought it was like the 7v but with bios solder with it now the console won't read games and the spindle motor rapilly spins on startup even when lid is open

The fact that the motor spins when the lid is open tells that psnee is not the issue here but the wrong installation probably caused a sort of short circuit or something somewhere...

Also (which is why I initially wanted to reply):

> Do you service the optical unit motors (WD40 does the job for this)

By experience, WD40 is not a good product to properly lubricate the spindle and sled motors (only a short term solution and this will be actually worse with too much of it, ask me how I know...).
Light oil should be used instead. I highly recommend checking this youtube video to know how to apply the oil (even though I prefer applying it without removing the original ceramic spindle hub which is fragile and can break easily like he says):
https://www.youtube.com/watch?v=cnNTnlaD3rI

Genomans, 2025-06-08:
Could be gonna check that out once I have time
