kalymos/PsNee/(commit log)

2022-12-28 Update README.md (#38)
    Fixed typo and translated ICSP pins to numbers (for pro micro/32UX boards)
2023-12-08 schematic correction for PU-8
2024-03-21 Add files via upload
    modification of the card wiring diagrams, PS1 VCC 3.5v, Rav Vin tu 5V
2024-07-02 Update PsNee.ino
    Pin modification for 32U platform
2024-07-02 Add files via upload
    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
2024-07-02 Update README.md
    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
2025-02-11 Added fuse information to PDF
    Added fuse information to PDF
2025-02-12 adhere to Arduino IDE standards for sketch names (#65)
    The IDE wants them to be named like their containing folder. Otherwise it proposes to create a new
    folder and to move the sketch into it, which again causes troubles because the header files are not
    automatically moved. Giving the sketch name the proper name avoids a lot of troubles for Arduino
    IDE users (at least for version 2.3.4)
    I missed this due to bad practice on my part, and this problem is found with all versions of Arduino IDE that I know of.
2025-02-13 In correction in board.txt
2025-03-09 PsSnee 8.6 (#69)
    * add led on attiny
    * bof
    * mieux
    * logo
    * pat for core
    * coment MUC
    * Image BIOS
    * update comments
    * Update PSNee_V8.6.ino
    * updat BIOSpatch
    * corect bug SWITCH end up fuses
    * shorter injection
    shorter injection, than a specific region is chosen, and return of multi region.
    * test list
    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
    [settings.h]
2025-06-07 Update PSNee_V8.6.ino
    Modification du Commentaire sur les fusibles des ATtiny E:FD -> E:FF
2025-07-14 Fixed schematic
    Fixed schematic for PU-8a motherboard, added schematic for PU-16 motherboard
2025-12-07 Enhance code comments for board detection logic
    Added comments to clarify the behavior of the code for different board generations.
2026-03-29 BIOS patch timer modification
    for the SCPH-5500, SCPH-5000, and SCPH-3500
2026-04-19 Cleanup: Remove deprecated files for V9.0 merge
    - Deleted obsolete files to prepare the branch for the V9.0 main integration.
    - Cleaning up the directory structure to avoid conflicts during the merge.
    [settings.h]
2026-04-19 Merge V9.0 into Main (#111)
    * MUC-MCU
    Fixed the MUC-MCU file name.
    Fixed a bug that prevented additional MCUs from being compiled.
    Modified the clock registers for ATtiny 48-88s; the TCCROB register is missing in these MUCs.
    * Too many things to summarize
    Refactoring of the setting file, to be able to have settings specifying the HYSTERESIS_MAX variable.
    Renamed precompilation variable in BIOS_patching file.
    Changing console selection in .ino file
    * Renaming files to make updating easier
    * Update README.md
    * logo 8.7
    * optimization on regin injection
    * Ad bios patch 102A, and correct some images.
    * SCPH_102A bios patch WIP
    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
    [MCU.h, PSNee.ino, settings.h]
2026-04-26 Pinout Arduino Pro Mini
    MISO MOSI pin inversion correction
